wormyrocks/d-lev-mini/release/burnlist.md

# board burn list

# general to do's

## release script
- [x] round tracks
- [x] teardrops
- [ ] gerbolyzation
- [ ] panelization
- [ ] use commit hash in folder name

# all boards
- [x] de-round round tracks
- [ ] design rule audit 
- [ ] thank you notes

# mainboard
- [x] place refdes'

# i/o board 
- [ ] gerbolyze marla sketch

# tuner
- [ ] gerbolyze front panel design

# afe
- [ ] gerbolyze sketch

# wontfix
- [ ] silk icons for top 10 line items
- [ ] use absolute paths in d-lev-main in order for blender export to work properly
