wormyrocks/d-lev-mini/d-lev-main/Notes_Questions.md

* Anything special about the LP2950 or should any reasonable 3.3v regulator work here?
