wormyrocks/d-lev-mini/d-lev-libraries/refdes/font.md

# reference designator font

exporting with [pixel font converter](https://yellowafterlife.itch.io/pixelfont)
21 characters at 75x110
0 1 2 3 4 5 6 7 8 9 R C L U Q J X P - < >
min/max pressure values: 4/7
export at 1.2mm tall
