wormyrocks/d-lev-mini/d-lev-main/datasheet/EP4CE15 and E22 in QFP144 pinout.xls

Cyclone® IV EP4CE15 Device Version 1.3 Notes (1), (2), (3) |  |  |  |  |  | Cyclone® IV EP4CE22 Device Version 1.2 Notes (1), (2), (3) |  |  |  |  |  |  | +3.3V | I/O | Reserved (config, etc)
 |  |  |  |  |  |  |  |  |  |  |  |  | Com | Com
 |  |  |  |  |  |  |  |  |  |  |  |  | +1.2V | Vccint Vccd_pll
Bank | VREFB Group | Optional Function(s) | Configuration Function | PinName/ Function | E144 (4) | Bank Number | VREFB Group | Optional Function(s) | Configuration Function | Pin Name / Function | E144 (4) | Function | +2.5V | Vcca
 |  |  |  | VCCD_PLL3 | 1 |  |  |  |  | VCCD_PLL3 | 1
 |  |  |  | GNDA3 | 2 |  |  |  |  | GNDA3 | 2
 |  |  |  | VCCA3 | 3 |  |  |  |  | VCCA3 | 3
 |  |  |  | GND | 4 |  |  |  |  | GND | 4
 |  |  |  | VCCINT | 5 |  |  |  |  | VCCINT | 5
B1 | VREFB1N0 | DIFFIO_L4n | DATA1,ASDO | IO | 6 | B1 | VREFB1N0 | DIFFIO_L3n | DATA1,ASDO | IO | 6
B1 | VREFB1N0 | VREFB1N0 |  | IO | 7 | B1 | VREFB1N0 | VREFB1N0 |  | IO | 7
B1 | VREFB1N0 | DIFFIO_L6p | FLASH_nCE,nCSO | IO | 8 | B1 | VREFB1N0 | DIFFIO_L4p | FLASH_nCE,nCSO | IO | 8
B1 | VREFB1N1 |  | nSTATUS | nSTATUS | 9 | B1 | VREFB1N0 |  | nSTATUS | nSTATUS | 9
B1 | VREFB1N1 |  |  | IO | 10 | B1 | VREFB1N0 | DIFFIO_L6p |  | IO | 10
B1 | VREFB1N1 | VREFB1N1 |  | IO | 11 | B1 | VREFB1N0 | DIFFIO_L6n |  | IO | 11
B1 | VREFB1N1 |  | DCLK | DCLK | 12 | B1 | VREFB1N0 |  | DCLK | DCLK | 12
B1 | VREFB1N1 |  | DATA0 | IO | 13 | B1 | VREFB1N0 |  | DATA0 | IO | 13
B1 | VREFB1N1 |  | nCONFIG | nCONFIG | 14 | B1 | VREFB1N0 |  | nCONFIG | nCONFIG | 14
B1 | VREFB1N1 |  | TDI | TDI | 15 | B1 | VREFB1N0 |  | TDI | TDI | 15
B1 | VREFB1N1 |  | TCK | TCK | 16 | B1 | VREFB1N0 |  | TCK | TCK | 16
 |  |  |  | VCCIO1 | 17 |  |  |  |  | VCCIO1 | 17
B1 | VREFB1N1 |  | TMS | TMS | 18 | B1 | VREFB1N0 |  | TMS | TMS | 18
 |  |  |  | GND | 19 |  |  |  |  | GND | 19
B1 | VREFB1N1 |  | TDO | TDO | 20 | B1 | VREFB1N0 |  | TDO | TDO | 20
B1 | VREFB1N1 |  | nCE | nCE | 21 | B1 | VREFB1N0 |  | nCE | nCE | 21
 |  |  |  | GND | 22 |  |  |  |  | GND | 22
B1 | VREFB1N1 | DIFFCLK_0n |  | CLK1 | 23 | B1 | VREFB1N0 | DIFFCLK_0n |  | CLK1 | 23 | Clock
B2 | VREFB2N0 | DIFFCLK_1p |  | CLK2 | 24 | B2 | VREFB2N0 | DIFFCLK_1p |  | CLK2 | 24 | Master In
B2 | VREFB2N0 | DIFFCLK_1n |  | CLK3 | 25 | B2 | VREFB2N0 | DIFFCLK_1n |  | CLK3 | 25
 |  |  |  | VCCIO2 | 26 |  |  |  |  | VCCIO2 | 26
 |  |  |  | GND | 27 |  |  |  |  | GND | 27
B2 | VREFB2N0 | VREFB2N0 |  | IO | 28 | B2 | VREFB2N0 | DIFFIO_L8p |  | IO | 28
 |  |  |  | VCCINT | 29 |  |  |  |  | VCCINT | 29
B2 | VREFB2N0 | DIFFIO_L19p |  | IO | 30 | B2 | VREFB2N0 | DIFFIO_L11p |  | IO | 30 | Dig In
B2 | VREFB2N1 | VREFB2N1 |  | IO | 31 | B2 | VREFB2N0 | VREFB2N0 |  | IO | 31
B2 | VREFB2N1 | RUP1 |  | IO | 32 | B2 | VREFB2N0 | RUP1 |  | IO | 32
B2 | VREFB2N1 | RDN1 |  | IO | 33 | B2 | VREFB2N0 | RDN1 |  | IO | 33
 |  |  |  | VCCINT | 34 |  |  |  |  | VCCINT | 34
 |  |  |  | VCCA1 | 35 |  |  |  |  | VCCA1 | 35
 |  |  |  | GNDA1 | 36 |  |  |  |  | GNDA1 | 36
 |  |  |  | VCCD_PLL1 | 37 |  |  |  |  | VCCD_PLL1 | 37
 |  |  |  | VCCINT | 38 |  |  |  |  | VCCINT | 38
B3 | VREFB3N1 | VREFB3N1 |  | IO | 39 | B3 | VREFB3N0 | DIFFIO_B2p |  | IO | 39 | Dig In
 |  |  |  | VCCIO3 | 40 |  |  |  |  | VCCIO3 | 40
 |  |  |  | GND | 41 |  |  |  |  | GND | 41
B3 | VREFB3N1 |  |  | IO | 42 | B3 | VREFB3N0 |  |  | IO | 42 | Dig In
B3 | VREFB3N1 | PLL1_CLKOUTp |  | IO | 43 | B3 | VREFB3N0 | PLL1_CLKOUTp |  | IO | 43
B3 | VREFB3N1 | PLL1_CLKOUTn |  | IO | 44 | B3 | VREFB3N0 | PLL1_CLKOUTn |  | IO | 44
 |  |  |  | VCCINT | 45 |  |  |  |  | VCCINT | 45
B3 | VREFB3N0 | VREFB3N0 |  | IO | 46 | B3 | VREFB3N0 | VREFB3N0 |  | IO | 46
 |  |  |  | VCCIO3 | 47 |  |  |  |  | VCCIO3 | 47
 |  |  |  | GND | 48 |  |  |  |  | GND | 48
B3 | VREFB3N0 |  |  | IO | 49 | B3 | VREFB3N0 | DIFFIO_B9n |  | IO | 49
B3 | VREFB3N0 | DIFFIO_B18p |  | IO | 50 | B3 | VREFB3N0 | DIFFIO_B10n |  | IO | 50
B3 | VREFB3N0 | DIFFIO_B18n |  | IO | 51 | B3 | VREFB3N0 | DIFFIO_B11p |  | IO | 51
B3 | VREFB3N0 | DIFFCLK_6p |  | CLK15 | 52 | B3 | VREFB3N0 | DIFFCLK_6p |  | CLK15 | 52
B3 | VREFB3N0 | DIFFCLK_6n |  | CLK14 | 53 | B3 | VREFB3N0 | DIFFCLK_6n |  | CLK14 | 53 | AC Line
B4 | VREFB4N1 | DIFFCLK_7p |  | CLK13 | 54 | B4 | VREFB4N0 | DIFFCLK_7p |  | CLK13 | 54 | Extend In
B4 | VREFB4N1 | DIFFCLK_7n |  | CLK12 | 55 | B4 | VREFB4N0 | DIFFCLK_7n |  | CLK12 | 55
 |  |  |  | VCCIO4 | 56 |  |  |  |  | VCCIO4 | 56
 |  |  |  | GND | 57 |  |  |  |  | GND | 57
B4 | VREFB4N1 | DIFFIO_B21p |  | IO | 58 | B4 | VREFB4N0 | DIFFIO_B16p |  | IO | 58 | Extend Out
B4 | VREFB4N1 | DIFFIO_B22p |  | IO | 59 | B4 | VREFB4N0 | DIFFIO_B17p |  | IO | 59
B4 | VREFB4N1 | DIFFIO_B22n |  | IO | 60 | B4 | VREFB4N0 | DIFFIO_B17n |  | IO | 60
B4 | VREFB4N1 | DIFFIO_B23p |  | IO | 61 |  |  |  |  | VCCINT | 61
 |  |  |  | VCCIO4 | 62 |  |  |  |  | VCCIO4 | 62
 |  |  |  | GND | 63 |  |  |  |  | GND | 63
B4 | VREFB4N1 |  |  | IO | 64 | B4 | VREFB4N0 |  |  | IO | 64 | DAC Ctrl
B4 | VREFB4N1 | VREFB4N1 |  | IO | 65 | B4 | VREFB4N0 | VREFB4N0 |  | IO | 65
B4 | VREFB4N0 | RUP2 |  | IO | 66 | B4 | VREFB4N0 | RUP2 |  | IO | 66
B4 | VREFB4N0 | RDN2 |  | IO | 67 | B4 | VREFB4N0 | RDN2 |  | IO | 67
B4 | VREFB4N0 | DIFFIO_B29n |  | IO | 68 | B4 | VREFB4N0 | DIFFIO_B23n |  | IO | 68
B4 | VREFB4N0 | VREFB4N0 |  | IO | 69 | B4 | VREFB4N0 | DIFFIO_B24p |  | IO | 69
 |  |  |  | VCCINT | 70 |  |  |  |  | VCCINT | 70
B4 | VREFB4N0 | PLL4_CLKOUTp |  | IO | 71 | B4 | VREFB4N0 | PLL4_CLKOUTp |  | IO | 71 | DAC
B4 | VREFB4N0 | PLL4_CLKOUTn |  | IO | 72 | B4 | VREFB4N0 | PLL4_CLKOUTn |  | IO | 72
 |  |  |  | VCCD_PLL4 | 73 |  |  |  |  | VCCD_PLL4 | 73
 |  |  |  | GNDA4 | 74 |  |  |  |  | GNDA4 | 74
 |  |  |  | VCCA4 | 75 |  |  |  |  | VCCA4 | 75
B5 | VREFB5N1 | RUP3 |  | IO | 76 | B5 | VREFB5N0 | RUP3 |  | IO | 76
B5 | VREFB5N1 | RDN3 |  | IO | 77 | B5 | VREFB5N0 | RDN3 |  | IO | 77
 |  |  |  | VCCINT | 78 |  |  |  |  | VCCINT | 78
 |  |  |  | GND | 79 |  |  |  |  | GND | 79
B5 | VREFB5N1 | VREFB5N1 |  | IO | 80 | B5 | VREFB5N0 | VREFB5N0 |  | IO | 80
 |  |  |  | VCCIO5 | 81 |  |  |  |  | VCCIO5 | 81
 |  |  |  | GND | 82 |  |  |  |  | GND | 82
B5 | VREFB5N0 | VREFB5N0 |  | IO | 83 | B5 | VREFB5N0 | DIFFIO_R11p |  | IO | 83 | ADC
 |  |  |  | VCCINT | 84 |  |  |  |  | VCCINT | 84
B5 | VREFB5N0 | DIFFIO_R22p |  | IO | 85 | B5 | VREFB5N0 | DIFFIO_R10p |  | IO | 85 | ADC
B5 | VREFB5N0 | DIFFIO_R21n | DEV_OE | IO | 86 | B5 | VREFB5N0 | DIFFIO_R9n | DEV_OE | IO | 86
B5 | VREFB5N0 | DIFFIO_R21p | DEV_CLRn | IO | 87 | B5 | VREFB5N0 | DIFFIO_R9p | DEV_CLRn | IO | 87
B5 | VREFB5N0 | DIFFCLK_3n |  | CLK7 | 88 | B5 | VREFB5N0 | DIFFCLK_3n |  | CLK7 | 88
B5 | VREFB5N0 | DIFFCLK_3p |  | CLK6 | 89 | B5 | VREFB5N0 | DIFFCLK_3p |  | CLK6 | 89
B6 | VREFB6N1 | DIFFCLK_2n |  | CLK5 | 90 | B6 | VREFB6N0 | DIFFCLK_2n |  | CLK5 | 90
B6 | VREFB6N1 | DIFFCLK_2p |  | CLK4 | 91 | B6 | VREFB6N0 | DIFFCLK_2p |  | CLK4 | 91
B6 | VREFB6N1 |  | CONF_DONE | CONF_DONE | 92 | B6 | VREFB6N0 |  | CONF_DONE | CONF_DONE | 92
 |  |  |  | VCCIO6 | 93 |  |  |  |  | VCCIO6 | 93
B6 | VREFB6N1 |  | MSEL0 | MSEL0 | 94 | B6 | VREFB6N0 |  | MSEL0 | MSEL0 | 94 |  | GND | AS +3.3V
 |  |  |  | GND | 95 |  |  |  |  | GND | 95
B6 | VREFB6N1 |  | MSEL1 | MSEL1 | 96 | B6 | VREFB6N0 |  | MSEL1 | MSEL1 | 96 |  | Vcca
B6 | VREFB6N1 |  | MSEL2 | MSEL2 | 97 | B6 | VREFB6N0 |  | MSEL2 | MSEL2 | 97 |  | GND
B6 | VREFB6N1 | DIFFIO_R17n | INIT_DONE | IO | 98 | B6 | VREFB6N0 | DIFFIO_R5n | INIT_DONE | IO | 98 | DAC
B6 | VREFB6N1 | DIFFIO_R17p | CRC_ERROR | IO | 99 | B6 | VREFB6N0 | DIFFIO_R5p | CRC_ERROR | IO | 99
B6 | VREFB6N1 | VREFB6N1 |  | IO | 100 | B6 | VREFB6N0 |  |  | IO | 100
B6 | VREFB6N1 | DIFFIO_R16n | nCEO | IO | 101 | B6 | VREFB6N0 | DIFFIO_R4n | nCEO | IO | 101
 |  |  |  | VCCINT | 102 |  |  |  |  | VCCINT | 102
B6 | VREFB6N1 | DIFFIO_R16p | CLKUSR | IO | 103 | B6 | VREFB6N0 | DIFFIO_R4p | CLKUSR | IO | 103 | DAC
B6 | VREFB6N1 | DIFFIO_R15n |  | IO | 104 | B6 | VREFB6N0 |  |  | IO | 104
B6 | VREFB6N0 | VREFB6N0 |  | IO | 105 | B6 | VREFB6N0 | VREFB6N0 |  | IO | 105
B6 | VREFB6N0 | DIFFIO_R2n | PADD20 | IO | 106 | B6 | VREFB6N0 | DIFFIO_R1n | PADD20 | IO | 106
 |  |  |  | VCCA2 | 107 |  |  |  |  | VCCA2 | 107
 |  |  |  | GNDA2 | 108 |  |  |  |  | GNDA2 | 108
 |  |  |  | VCCD_PLL2 | 109 |  |  |  |  | VCCD_PLL2 | 109
B7 | VREFB7N0 | DIFFIO_T30p |  | IO | 110 | B7 | VREFB7N0 | DIFFIO_T23p |  | IO | 110 | DAC
B7 | VREFB7N0 | VREFB7N0 |  | IO | 111 | B7 | VREFB7N0 | DIFFIO_T22p |  | IO | 111
B7 | VREFB7N0 | PLL2_CLKOUTn |  | IO | 112 | B7 | VREFB7N0 | PLL2_CLKOUTn |  | IO | 112
B7 | VREFB7N0 | PLL2_CLKOUTp |  | IO | 113 | B7 | VREFB7N0 | PLL2_CLKOUTp |  | IO | 113
B7 | VREFB7N0 | RUP4 |  | IO | 114 | B7 | VREFB7N0 | RUP4 |  | IO | 114
B7 | VREFB7N0 | RDN4 |  | IO | 115 | B7 | VREFB7N0 | RDN4 |  | IO | 115
 |  |  |  | VCCINT | 116 |  |  |  |  | VCCINT | 116
 |  |  |  | VCCIO7 | 117 |  |  |  |  | VCCIO7 | 117
 |  |  |  | GND | 118 |  |  |  |  | GND | 118
B7 | VREFB7N1 | VREFB7N1 |  | IO | 119 | B7 | VREFB7N0 | VREFB7N0 |  | IO | 119
B7 | VREFB7N1 | DIFFIO_T23n | PADD3 | IO | 120 | B7 | VREFB7N0 | DIFFIO_T19n | PADD1 | IO | 120 | Phi Pot
B7 | VREFB7N1 | DIFFIO_T21p | PADD4 | IO | 121 | B7 | VREFB7N0 | DIFFIO_T17p | PADD4 | IO | 121 | Phi Pot
 |  |  |  | VCCIO7 | 122 |  |  |  |  | VCCIO7 | 122
 |  |  |  | GND | 123 |  |  |  |  | GND | 123
 |  |  |  | VCCINT | 124 |  |  |  |  | VCCINT | 124
B7 | VREFB7N1 | DIFFIO_T17p | PADD12 | IO | 125 | B7 | VREFB7N0 | DIFFIO_T13p | PADD12 | IO | 125
B7 | VREFB7N1 | DIFFCLK_5n |  | CLK8 | 126 | B7 | VREFB7N0 | DIFFCLK_5n |  | CLK8 | 126 | Phi Pot
B7 | VREFB7N1 | DIFFCLK_5p |  | CLK9 | 127 | B7 | VREFB7N0 | DIFFCLK_5p |  | CLK9 | 127
B8 | VREFB8N0 | DIFFCLK_4n |  | CLK10 | 128 | B8 | VREFB8N0 | DIFFCLK_4n |  | CLK10 | 128
B8 | VREFB8N0 | DIFFCLK_4p |  | CLK11 | 129 | B8 | VREFB8N0 | DIFFCLK_4p |  | CLK11 | 129
 |  |  |  | VCCIO8 | 130 |  |  |  |  | VCCIO8 | 130
 |  |  |  | GND | 131 |  |  |  |  | GND | 131
B8 | VREFB8N0 | DIFFIO_T12n | DATA2 | IO | 132 | B8 | VREFB8N0 | DIFFIO_T10n | DATA2 | IO | 132 | Dat Out
B8 | VREFB8N0 | DIFFIO_T12p | DATA3 | IO | 133 | B8 | VREFB8N0 | DIFFIO_T10p | DATA3 | IO | 133
B8 | VREFB8N0 | DIFFIO_T11n | PADD18 | IO | 134 |  |  |  |  | VCCINT | 134
B8 | VREFB8N0 | DIFFIO_T11p | DATA4 | IO | 135 | B8 | VREFB8N0 | DIFFIO_T9p | DATA4 | IO | 135 | Dat Out
B8 | VREFB8N0 | VREFB8N0 |  | IO | 136 | B8 | VREFB8N0 | VREFB8N0 |  | IO | 136
B8 | VREFB8N0 |  | DATA5 | IO | 137 | B8 | VREFB8N0 |  | DATA5 | IO | 137
 |  |  |  | VCCINT | 138 |  |  |  |  | VCCINT | 138
 |  |  |  | VCCIO8 | 139 |  |  |  |  | VCCIO8 | 139
 |  |  |  | GND | 140 |  |  |  |  | GND | 140
B8 | VREFB8N1 | VREFB8N1 |  | IO | 141 | B8 | VREFB8N0 | DIFFIO_T2p |  | IO | 141 | Dat out
B8 | VREFB8N1 | DIFFIO_T2p | DATA12 | IO | 142 | B8 | VREFB8N0 |  | DATA12 | IO | 142
B8 | VREFB8N1 | PLL3_CLKOUTn |  | IO | 143 | B8 | VREFB8N0 | PLL3_CLKOUTn |  | IO | 143 | PRBS Out
B8 | VREFB8N1 | PLL3_CLKOUTp |  | IO | 144 | B8 | VREFB8N0 | PLL3_CLKOUTp |  | IO | 144 | LED
Notes:
(1) If the p pin or n pin is not available for the package, the particular differential pair is not supported. |  |  |  |  |  | Notes:
(2) For DQS pins that do not have the associated DQpins, the particular DQS is not supported. |  |  |  |  |  | (1) If the p pin or n pin is not available for the package, the particular differential pair is not supported.
(3) For more information about pin definition and pin connection guidelines, refer to the |  |  |  |  |  | (2) For DQS pins that do not have the associated DQ pins, the particular DQS is not supported.
Cyclone IV Device Family Pin Connection Guidelines. (http://www.altera.com/literature/dp/cyclone-iv/PCG-01008.pdf) |  |  |  |  |  | (3) For more information about pin definition and pin connection guidelines, refer to the
(4) The E144 package has an exposed pad at the bottom of the package. This exposed pad is a ground pad that must be connected to the ground plane on your PCB. |  |  |  |  |  | Cyclone IV Device Family Pin Connection Guidelines. (http://www.altera.com/literature/dp/cyclone-iv/PCG-01008.pdf)
This exposed pad is used for electrical connectivity, and not for thermal purposes. |  |  |  |  |  | (4) The E144 package has an exposed pad at the bottom of the package. This exposed pad is a ground pad that must be connected to the ground plane on your PCB.
 |  |  |  |  |  | This exposed pad is used for electrical connectivity, and not for thermal purposes.
