wormyrocks/d-lev-mini/d-lev-afe/2019-03-09_AFE3_layout.jpg

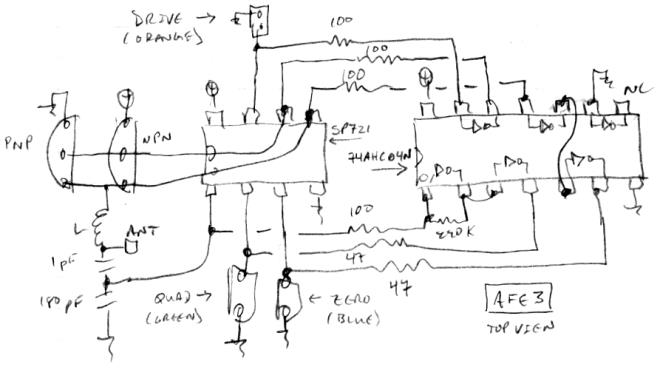
d-lev-afe/2019-03-09_AFE3_layout.jpg
