wormyrocks/d-lev-mini/d-lev-libraries/refdes/text.png

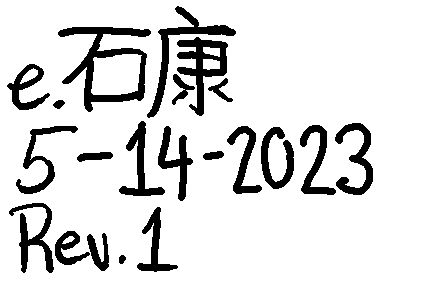
d-lev-libraries/refdes/text.png
