wormyrocks/d-lev-mini/d-lev-main/datasheet/Big_Inductor.png

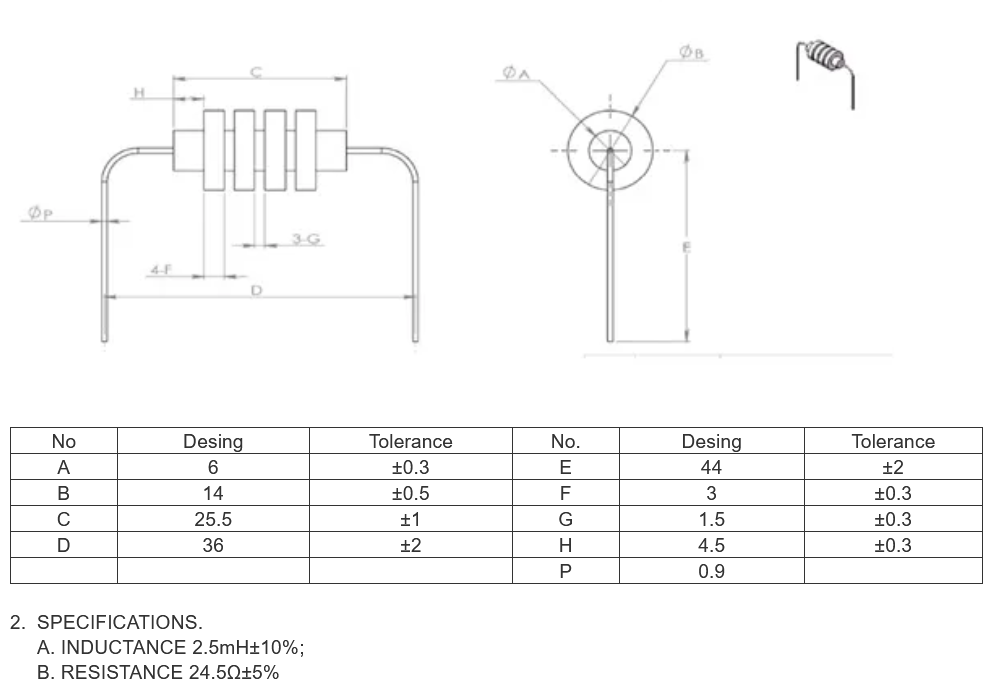
d-lev-main/datasheet/Big_Inductor.png
