wormyrocks/d-lev-mini/d-lev-main/ac608-pinmap.xlsx

Sheet: EP4CE10 Mapping
Pin Information for the Cyclone® IV EP4CE10 Device Version 1.2 Notes (1), (2), (3)
Bank Number |  |  | VREFB Group |  | Pin Name / Function |  |  | Optional Function(s) |  | Configuration Function | F256/ U256 |  | E144 (4) | DQS for X8/X9 in F256/U256 | DQS for X16/X18 in F256/U256 |  |  | DQS for X8/X9 in E144
B1 |  |  | VREFB1N0 |  | IO |  |  |  |  |  | D4 |  | 1
B1 |  |  | VREFB1N0 |  | IO |  |  |  |  |  | E5 |  | 2
B1 |  |  | VREFB1N0 |  | IO |  |  |  |  |  | F5 |  | 3
B1 |  |  | VREFB1N0 |  | IO |  |  |  |  |  | B1 |  |  | DQS2L/CQ3L | DQS2L/CQ3L |  |  | DQS2L/CQ3L
B1 |  |  | VREFB1N0 |  | IO |  |  | DIFFIO_L1p |  |  | C2
B1 |  |  | VREFB1N0 |  | IO |  |  | DIFFIO_L1n |  | DATA1,ASDO | C1 |  | 6
B1 |  |  | VREFB1N0 |  | IO |  |  | VREFB1N0 |  |  | F3 |  | 7
B1 |  |  | VREFB1N0 |  | IO |  |  | DIFFIO_L2p |  | FLASH_nCE,nCSO | D2 |  | 8
B1 |  |  | VREFB1N0 |  | IO |  |  | DIFFIO_L2n |  |  | D1
B1 |  |  | VREFB1N0 |  | nSTATUS |  |  |  |  | nSTATUS | F4 |  | 9
B1 |  |  | VREFB1N0 |  | IO |  |  |  |  |  | G5
B1 |  |  | VREFB1N0 |  | IO |  |  | DIFFIO_L3p |  |  | F2
B1 |  |  | VREFB1N0 |  | IO |  |  | DIFFIO_L3n |  |  | F1
B1 |  |  | VREFB1N0 |  | IO |  |  | DIFFIO_L4p |  |  | G2 |  | 10 | DQS0L/CQ1L,DPCLK0 | DQS0L/CQ1L,DPCLK0 |  |  | DQS0L/CQ1L,DPCLK0
B1 |  |  | VREFB1N0 |  | IO |  |  | DIFFIO_L4n |  |  | G1 |  | 11
B1 |  |  | VREFB1N0 |  | DCLK |  |  |  |  | DCLK | H1 |  | 12
B1 |  |  | VREFB1N0 |  | IO |  |  |  |  | DATA0 | H2 |  | 13
B1 |  |  | VREFB1N0 |  | nCONFIG |  |  |  |  | nCONFIG | H5 |  | 14
B1 |  |  | VREFB1N0 |  | TDI |  |  |  |  | TDI | H4 |  | 15
B1 |  |  | VREFB1N0 |  | TCK |  |  |  |  | TCK | H3 |  | 16
B1 |  |  | VREFB1N0 |  | TMS |  |  |  |  | TMS | J5 |  | 18
B1 |  |  | VREFB1N0 |  | TDO |  |  |  |  | TDO | J4 |  | 20
B1 |  |  | VREFB1N0 |  | nCE |  |  |  |  | nCE | J3 |  | 21
B1 |  |  | VREFB1N0 |  | CLK1 |  |  | DIFFCLK_0n |  |  | E1 |  | 23
B2 |  |  | VREFB2N0 |  | CLK2 |  |  | DIFFCLK_1p |  |  | M2 |  | 24
B2 |  |  | VREFB2N0 |  | CLK3 |  |  | DIFFCLK_1n |  |  | M1 |  | 25
B2 |  |  | VREFB2N0 |  | IO |  |  | DIFFIO_L5p |  |  | J2 |  |  | DQ1L
B2 |  |  | VREFB2N0 |  | IO |  |  | DIFFIO_L5n |  |  | J1 |  |  | DQ1L
B2 |  |  | VREFB2N0 |  | IO |  |  |  |  |  | J6
B2 |  |  | VREFB2N0 |  | IO |  |  | DIFFIO_L6p |  |  | K6
B2 |  |  | VREFB2N0 |  | IO |  |  | DIFFIO_L6n |  |  | L6 |  | 28
B2 |  |  | VREFB2N0 |  | IO |  |  | DIFFIO_L7p |  |  | K2
B2 |  |  | VREFB2N0 |  | IO |  |  | DIFFIO_L7n |  |  | K1 |  |  | DQ1L
B2 |  |  | VREFB2N0 |  | IO |  |  | DIFFIO_L8p |  |  | L2 |  | 30 | DQS1L/CQ1L#,DPCLK1 | DQS1L/CQ1L#,DPCLK1 |  |  | DQS1L/CQ1L#,DPCLK1
B2 |  |  | VREFB2N0 |  | IO |  |  | DIFFIO_L8n |  |  | L1 |  |  | DQ1L
B2 |  |  | VREFB2N0 |  | IO |  |  | VREFB2N0 |  |  | L3 |  | 31
B2 |  |  | VREFB2N0 |  | IO |  |  | DIFFIO_L9p |  |  | N2 |  |  | DQ1L
B2 |  |  | VREFB2N0 |  | IO |  |  | DIFFIO_L9n |  |  | N1 |  |  | DQ1L
B2 |  |  | VREFB2N0 |  | IO |  |  | RUP1 |  |  | K5 |  | 32 | DQ1L
B2 |  |  | VREFB2N0 |  | IO |  |  | RDN1 |  |  | L4 |  | 33 | DQ1L
B2 |  |  | VREFB2N0 |  | IO |  |  |  |  |  |  |  | 34
B2 |  |  | VREFB2N0 |  | IO |  |  |  |  |  | R1 |  |  | DQS3L/CQ3L# | DQS3L/CQ3L# |  |  | DQS3L/CQ3L#
B2 |  |  | VREFB2N0 |  | IO |  |  | DIFFIO_L10p |  |  | P2 |  |  | DQ1L
B2 |  |  | VREFB2N0 |  | IO |  |  | DIFFIO_L10n |  |  | P1 |  |  | DM1L/BWS#1L
B3 |  |  | VREFB3N0 |  | IO |  |  | DIFFIO_B1p |  |  | N3 |  | 38
B3 |  |  | VREFB3N0 |  | IO |  |  | DIFFIO_B1n |  |  | P3 |  | 39 | DM3B/BWS#3B | DM5B/BWS#5B
Pin Information for the Cyclone® IV EP4CE10 Device Version 1.2 Notes (1), (2), (3)
Bank Number |  |  | VREFB Group |  | Pin Name / Function |  |  | Optional Function(s) |  | Configuration Function | F256/ U256 |  | E144 (4) | DQS for X8/X9 in F256/U256 | DQS for X16/X18 in F256/U256 |  |  | DQS for X8/X9 in E144
B3 |  |  | VREFB3N0 |  | IO |  |  | DIFFIO_B2p |  |  | R3 |  |  | DQ3B | DQ5B
B3 |  |  | VREFB3N0 |  | IO |  |  | DIFFIO_B2n |  |  | T3
B3 |  |  | VREFB3N0 |  | IO |  |  |  |  |  | T2 |  | 42 | DQS1B/CQ1B#,DPCLK2 | DQS1B/CQ1B#,DPCLK2 |  |  | DQS1B/CQ1B#,DPCLK2
B3 |  |  | VREFB3N0 |  | IO |  |  | PLL1_CLKOUTp |  |  | R4 |  | 43
B3 |  |  | VREFB3N0 |  | IO |  |  | PLL1_CLKOUTn |  |  | T4 |  | 44
B3 |  |  | VREFB3N0 |  | IO |  |  | DIFFIO_B4p |  |  | N5 |  |  | DQ3B | DQ5B
B3 |  |  | VREFB3N0 |  | IO |  |  | DIFFIO_B4n |  |  | N6 |  |  | DQ3B | DQ5B
B3 |  |  | VREFB3N0 |  | IO |  |  |  |  |  | M6 |  |  | DQ3B | DQ5B
B3 |  |  | VREFB3N0 |  | IO |  |  | VREFB3N0 |  |  | P6 |  | 46
B3 |  |  | VREFB3N0 |  | IO |  |  | DIFFIO_B5p |  |  | M7 |  |  | DQS3B/CQ3B# | DQS3B/CQ3B# |  |  | DQS3B/CQ3B#
B3 |  |  | VREFB3N0 |  | IO |  |  | DIFFIO_B5n |  |  | K8
B3 |  |  | VREFB3N0 |  | IO |  |  | DIFFIO_B6p |  |  | R5 |  |  | DQ3B | DQ5B
B3 |  |  | VREFB3N0 |  | IO |  |  | DIFFIO_B6n |  |  | T5
B3 |  |  | VREFB3N0 |  | IO |  |  | DIFFIO_B7p |  |  | R6 |  |  | DQ3B | DQ5B
B3 |  |  | VREFB3N0 |  | IO |  |  | DIFFIO_B7n |  |  | T6
B3 |  |  | VREFB3N0 |  | IO |  |  |  |  |  | L7 |  |  | DQ3B | DQ5B
B3 |  |  | VREFB3N0 |  | IO |  |  | DIFFIO_B8p |  |  | R7 |  |  | DQ3B | DQ5B
B3 |  |  | VREFB3N0 |  | IO |  |  | DIFFIO_B8n |  |  | T7 |  |  | DQS5B/CQ5B# | DQS5B/CQ5B# |  |  | DQS5B/CQ5B#
B3 |  |  | VREFB3N0 |  | IO |  |  | DIFFIO_B9p |  |  | L8 |  | 49 | DQ3B | DQ5B |  |  | DQ1B
B3 |  |  | VREFB3N0 |  | IO |  |  | DIFFIO_B9n |  |  | M8 |  | 50 | DM5B/BWS#5B | DM5B/BWS#5B |  |  | DQ1B
B3 |  |  | VREFB3N0 |  | IO |  |  | DIFFIO_B10p |  |  | N8 |  | 51 | DQ5B | DQ5B |  |  | DQ1B
B3 |  |  | VREFB3N0 |  | IO |  |  | DIFFIO_B10n |  |  | P8 |  |  | DQ5B | DQ5B
B3 |  |  | VREFB3N0 |  | IO |  |  | DIFFIO_B11p |  |  | R8 |  | 52
B3 |  |  | VREFB3N0 |  | IO |  |  | DIFFIO_B11n |  |  | T8 |  | 53
B4 |  |  | VREFB4N0 |  | IO |  |  | DIFFIO_B12p |  |  | R9 |  | 54
B4 |  |  | VREFB4N0 |  | IO |  |  | DIFFIO_B12n |  |  | T9 |  | 55
B4 |  |  | VREFB4N0 |  | IO |  |  | DIFFIO_B13p |  |  | K9
B4 |  |  | VREFB4N0 |  | IO |  |  | DIFFIO_B13n |  |  | L9
B4 |  |  | VREFB4N0 |  | IO |  |  | DIFFIO_B14p |  |  | M9
B4 |  |  | VREFB4N0 |  | IO |  |  | DIFFIO_B14n |  |  | N9 |  |  | DQ5B | DQ5B
B4 |  |  | VREFB4N0 |  | IO |  |  | DIFFIO_B15p |  |  | R10 |  | 58 | DQ5B | DQ5B |  |  | DQ1B
B4 |  |  | VREFB4N0 |  | IO |  |  | DIFFIO_B15n |  |  | T10 |  |  | DQS4B/CQ5B | DQS4B/CQ5B |  |  | DQS4B/CQ5B
B4 |  |  | VREFB4N0 |  | IO |  |  | DIFFIO_B16p |  |  | R11 |  | 59 | DQ5B | DQ5B |  |  | DQ1B
B4 |  |  | VREFB4N0 |  | IO |  |  | DIFFIO_B16n |  |  | T11 |  | 60 |  |  |  |  | DQ1B
B4 |  |  | VREFB4N0 |  | IO |  |  | DIFFIO_B17p |  |  | R12 |  |  | DQ5B | DQ5B
B4 |  |  | VREFB4N0 |  | IO |  |  | DIFFIO_B17n |  |  | T12 |  |  | DQ5B | DQ5B
B4 |  |  | VREFB4N0 |  | IO |  |  | DIFFIO_B18p |  |  | K10
B4 |  |  | VREFB4N0 |  | IO |  |  | DIFFIO_B18n |  |  | L10
B4 |  |  | VREFB4N0 |  | IO |  |  |  |  |  | P9 |  | 64 | DQS2B/CQ3B | DQS2B/CQ3B
B4 |  |  | VREFB4N0 |  | IO |  |  | VREFB4N0 |  |  | P11 |  | 65
B4 |  |  | VREFB4N0 |  | IO |  |  | DIFFIO_B19p |  |  | R13
B4 |  |  | VREFB4N0 |  | IO |  |  | DIFFIO_B19n |  |  | T13 |  |  | DQ5B | DQ5B
B4 |  |  | VREFB4N0 |  | IO |  |  | RUP2 |  |  | M10 |  | 66 |  |  |  |  | DQ1B
B4 |  |  | VREFB4N0 |  | IO |  |  | RDN2 |  |  | N11 |  | 67 |  |  |  |  | DQ1B
B4 |  |  | VREFB4N0 |  | IO |  |  | DIFFIO_B20p |  |  | T14 |  |  | DQ5B | DQ5B
B4 |  |  | VREFB4N0 |  | IO |  |  | DIFFIO_B20n |  |  | T15 |  | 68 | DQS0B/CQ1B,DPCLK3 | DQS0B/CQ1B,DPCLK3 |  |  | DQS0B/CQ1B,DPCLK3
Pin Information for the Cyclone® IV EP4CE10 Device Version 1.2 Notes (1), (2), (3)
Bank Number |  |  | VREFB Group |  | Pin Name / Function |  |  | Optional Function(s) |  | Configuration Function | F256/ U256 |  | E144 (4) | DQS for X8/X9 in F256/U256 | DQS for X16/X18 in F256/U256 |  |  | DQS for X8/X9 in E144
B4 |  |  | VREFB4N0 |  | IO |  |  |  |  |  | R14 |  | 69
B4 |  |  | VREFB4N0 |  | IO |  |  | DIFFIO_B21p |  |  | P14 |  | 70
B4 |  |  | VREFB4N0 |  | IO |  |  | DIFFIO_B21n |  |  | L11 |  | 71
B4 |  |  | VREFB4N0 |  | IO |  |  | DIFFIO_B22p |  |  | M11 |  | 72
B4 |  |  | VREFB4N0 |  | IO |  |  | DIFFIO_B22n |  |  | N12
B5 |  |  | VREFB5N0 |  | IO |  |  |  |  |  | N13 |  | 73
B5 |  |  | VREFB5N0 |  | IO |  |  |  |  |  | M12 |  | 74
B5 |  |  | VREFB5N0 |  | IO |  |  |  |  |  | L12 |  | 75
B5 |  |  | VREFB5N0 |  | IO |  |  |  |  |  | K12
B5 |  |  | VREFB5N0 |  | IO |  |  | RUP3 |  |  | N14 |  | 76 | DM1R/BWS#1R
B5 |  |  | VREFB5N0 |  | IO |  |  | RDN3 |  |  | P15 |  | 77 | DQ1R
B5 |  |  | VREFB5N0 |  | IO |  |  | DIFFIO_R11n |  |  | P16 |  |  | DQS3R/CQ3R# | DQS3R/CQ3R# |  |  | DQS3R/CQ3R#
B5 |  |  | VREFB5N0 |  | IO |  |  | DIFFIO_R11p |  |  | R16 |  |  | DQ1R
B5 |  |  | VREFB5N0 |  | IO |  |  |  |  |  | K11
B5 |  |  | VREFB5N0 |  | IO |  |  | DIFFIO_R10n |  |  | N16 |  |  | DQ1R
B5 |  |  | VREFB5N0 |  | IO |  |  | DIFFIO_R10p |  |  | N15 |  |  | DQ1R
B5 |  |  | VREFB5N0 |  | IO |  |  | VREFB5N0 |  |  | L14 |  | 80
B5 |  |  | VREFB5N0 |  | IO |  |  |  |  |  | L13 |  |  | DQ1R
B5 |  |  | VREFB5N0 |  | IO |  |  | DIFFIO_R9n |  |  | L16 |  |  | DQ1R
B5 |  |  | VREFB5N0 |  | IO |  |  | DIFFIO_R9p |  |  | L15
B5 |  |  | VREFB5N0 |  | IO |  |  |  |  |  | J11 |  | 83
B5 |  |  | VREFB5N0 |  | IO |  |  | DIFFIO_R8n |  |  | K16 |  | 84 | DQ1R
B5 |  |  | VREFB5N0 |  | IO |  |  | DIFFIO_R8p |  |  | K15 |  | 85 | DQS1R/CQ1R#,DPCLK4 | DQS1R/CQ1R#,DPCLK4 |  |  | DQS1R/CQ1R#,DPCLK4
B5 |  |  | VREFB5N0 |  | IO |  |  | DIFFIO_R7n |  | DEV_OE | J16 |  | 86
B5 |  |  | VREFB5N0 |  | IO |  |  | DIFFIO_R7p |  | DEV_CLRn | J15 |  | 87
B5 |  |  | VREFB5N0 |  | IO |  |  | DIFFIO_R6n |  |  | J14 |  |  | DQ1R
B5 |  |  | VREFB5N0 |  | IO |  |  | DIFFIO_R6p |  |  | J12
B5 |  |  | VREFB5N0 |  | IO |  |  |  |  |  | J13 |  |  | DQ1R
B5 |  |  | VREFB5N0 |  | CLK7 |  |  | DIFFCLK_3n |  |  | M16 |  | 88
B5 |  |  | VREFB5N0 |  | CLK6 |  |  | DIFFCLK_3p |  |  | M15 |  | 89
B6 |  |  | VREFB6N0 |  | CLK5 |  |  | DIFFCLK_2n |  |  | E16 |  | 90
B6 |  |  | VREFB6N0 |  | CLK4 |  |  | DIFFCLK_2p |  |  | E15 |  | 91
B6 |  |  | VREFB6N0 |  | CONF_DONE |  |  |  |  | CONF_DONE | H14 |  | 92
B6 |  |  | VREFB6N0 |  | MSEL0 |  |  |  |  | MSEL0 | H13 |  | 94
B6 |  |  | VREFB6N0 |  | MSEL1 |  |  |  |  | MSEL1 | H12 |  | 96
B6 |  |  | VREFB6N0 |  | MSEL2 |  |  |  |  | MSEL2 | G12 |  | 97
B6 |  |  | VREFB6N0 |  | IO |  |  | DIFFIO_R4n |  | INIT_DONE | G16 |  | 98
B6 |  |  | VREFB6N0 |  | IO |  |  | DIFFIO_R4p |  | CRC_ERROR | G15 |  | 99
B6 |  |  | VREFB6N0 |  | IO |  |  |  |  |  | F13 |  | 100
B6 |  |  | VREFB6N0 |  | IO |  |  | DIFFIO_R3n |  | nCEO | F16 |  | 101
B6 |  |  | VREFB6N0 |  | IO |  |  | DIFFIO_R3p |  | CLKUSR | F15 |  | 103
B6 |  |  | VREFB6N0 |  | IO |  |  |  |  |  | B16 |  | 104 | DQS0R/CQ1R,DPCLK5 | DQS0R/CQ1R,DPCLK5 |  |  | DQS0R/CQ1R,DPCLK5
B6 |  |  | VREFB6N0 |  | IO |  |  | VREFB6N0 |  |  | F14 |  | 105
B6 |  |  | VREFB6N0 |  | IO |  |  | DIFFIO_R2n |  |  | D16
B6 |  |  | VREFB6N0 |  | IO |  |  | DIFFIO_R2p |  |  | D15
B6 |  |  | VREFB6N0 |  | IO |  |  |  |  |  | G11
Pin Information for the Cyclone® IV EP4CE10 Device Version 1.2 Notes (1), (2), (3)
Bank Number |  |  | VREFB Group |  | Pin Name / Function |  |  | Optional Function(s) |  | Configuration Function | F256/ U256 |  | E144 (4) | DQS for X8/X9 in F256/U256 | DQS for X16/X18 in F256/U256 |  |  | DQS for X8/X9 in E144
B6 |  |  | VREFB6N0 |  | IO |  |  | DIFFIO_R1n |  |  | C16 |  | 106 | DQS2R/CQ3R | DQS2R/CQ3R
B6 |  |  | VREFB6N0 |  | IO |  |  | DIFFIO_R1p |  |  | C15
B7 |  |  | VREFB7N0 |  | IO |  |  | DIFFIO_T21n |  |  | C14
B7 |  |  | VREFB7N0 |  | IO |  |  | DIFFIO_T21p |  |  | D14 |  |  | DQ5T | DQ5T
B7 |  |  | VREFB7N0 |  | IO |  |  | DIFFIO_T20n |  |  | D11
B7 |  |  | VREFB7N0 |  | IO |  |  | DIFFIO_T20p |  |  | D12 |  | 110 | DQS0T/CQ1T,DPCLK6 | DQS0T/CQ1T,DPCLK6 |  |  | DQS0T/CQ1T,DPCLK6
B7 |  |  | VREFB7N0 |  | IO |  |  | DIFFIO_T19n |  |  | A13
B7 |  |  | VREFB7N0 |  | IO |  |  | DIFFIO_T19p |  |  | B13 |  | 111 | DQ5T | DQ5T
B7 |  |  | VREFB7N0 |  | IO |  |  | PLL2_CLKOUTn |  |  | A14 |  | 112
B7 |  |  | VREFB7N0 |  | IO |  |  | PLL2_CLKOUTp |  |  | B14 |  | 113
B7 |  |  | VREFB7N0 |  | IO |  |  | RUP4 |  |  | E11 |  | 114 |  |  |  |  | DQ1T
B7 |  |  | VREFB7N0 |  | IO |  |  | RDN4 |  |  | E10 |  | 115 |  |  |  |  | DQ1T
B7 |  |  | VREFB7N0 |  | IO |  |  | DIFFIO_T18n |  |  | A12 |  |  | DQ5T | DQ5T
B7 |  |  | VREFB7N0 |  | IO |  |  | DIFFIO_T18p |  |  | B12 |  |  | DQ5T | DQ5T
B7 |  |  | VREFB7N0 |  | IO |  |  | DIFFIO_T17n |  |  | A11 |  |  | DQ5T | DQ5T
B7 |  |  | VREFB7N0 |  | IO |  |  | DIFFIO_T17p |  |  | B11 |  |  | DQ5T | DQ5T
B7 |  |  | VREFB7N0 |  | IO |  |  | VREFB7N0 |  |  | C11 |  | 119
B7 |  |  | VREFB7N0 |  | IO |  |  | DIFFIO_T16n |  |  | F10 |  | 120 |  |  |  |  | DQ1T
B7 |  |  | VREFB7N0 |  | IO |  |  | DIFFIO_T16p |  |  | F9 |  | 121 | DQS2T/CQ3T | DQS2T/CQ3T
B7 |  |  | VREFB7N0 |  | IO |  |  | DIFFIO_T15n |  |  | F11
B7 |  |  | VREFB7N0 |  | IO |  |  | DIFFIO_T15p |  |  | A15
B7 |  |  | VREFB7N0 |  | IO |  |  | DIFFIO_T14n |  |  | A10 |  |  | DQ5T | DQ5T
B7 |  |  | VREFB7N0 |  | IO |  |  | DIFFIO_T14p |  |  | B10 |  |  | DQ5T | DQ5T
B7 |  |  | VREFB7N0 |  | IO |  |  | DIFFIO_T13n |  |  | C9 |  |  | DQ5T | DQ5T
B7 |  |  | VREFB7N0 |  | IO |  |  | DIFFIO_T13p |  |  | D9 |  | 124 | DM5T/BWS#5T | DM5T/BWS#5T
B7 |  |  | VREFB7N0 |  | IO |  |  |  |  |  | E9 |  | 125 | DQS4T/CQ5T | DQS4T/CQ5T
B7 |  |  | VREFB7N0 |  | IO |  |  | DIFFIO_T12n |  |  | A9 |  | 126
B7 |  |  | VREFB7N0 |  | IO |  |  | DIFFIO_T12p |  |  | B9 |  | 127
B8 |  |  | VREFB8N0 |  | IO |  |  | DIFFIO_T11n |  |  | A8 |  | 128
B8 |  |  | VREFB8N0 |  | IO |  |  | DIFFIO_T11p |  |  | B8 |  | 129
B8 |  |  | VREFB8N0 |  | IO |  |  |  |  |  | C8 |  |  | DQS5T/CQ5T# | DQS5T/CQ5T# |  |  | DQS5T/CQ5T#
B8 |  |  | VREFB8N0 |  | IO |  |  |  |  |  | D8 |  |  | DQ3T | DQ5T
B8 |  |  | VREFB8N0 |  | IO |  |  | DIFFIO_T10n |  | DATA2 | E8 |  | 132 | DQ3T | DQ5T |  |  | DQ1T
B8 |  |  | VREFB8N0 |  | IO |  |  | DIFFIO_T10p |  | DATA3 | F8 |  | 133 |  |  |  |  | DQ1T
B8 |  |  | VREFB8N0 |  | IO |  |  | DIFFIO_T9n |  |  | A7 |  |  | DQ3T | DQ5T
B8 |  |  | VREFB8N0 |  | IO |  |  | DIFFIO_T9p |  | DATA4 | B7 |  |  | DQ3T | DQ5T
B8 |  |  | VREFB8N0 |  | IO |  |  | DIFFIO_T8n |  |  | F6 |  | 135 |  |  |  |  | DQ1T
B8 |  |  | VREFB8N0 |  | IO |  |  | DIFFIO_T8p |  |  | F7
B8 |  |  | VREFB8N0 |  | IO |  |  | VREFB8N0 |  |  | C6 |  | 136
B8 |  |  | VREFB8N0 |  | IO |  |  | DIFFIO_T7n |  |  | A6 |  |  | DQS3T/CQ3T# | DQS3T/CQ3T# |  |  | DQS3T/CQ3T#
B8 |  |  | VREFB8N0 |  | IO |  |  | DIFFIO_T7p |  |  | B6 |  |  | DQ3T | DQ5T
B8 |  |  | VREFB8N0 |  | IO |  |  |  |  | DATA5 | E7 |  | 137 | DQ3T | DQ5T |  |  | DQ1T
B8 |  |  | VREFB8N0 |  | IO |  |  |  |  | DATA6 | E6 |  | 138 | DQ3T | DQ5T
B8 |  |  | VREFB8N0 |  | IO |  |  | DIFFIO_T6n |  | DATA7 | A5 |  |  | DQ3T | DQ5T
B8 |  |  | VREFB8N0 |  | IO |  |  | DIFFIO_T5n |  |  | A2
B8 |  |  | VREFB8N0 |  | IO |  |  | DIFFIO_T5p |  |  | B5 |  | 141 | DQ3T | DQ5T
Pin Information for the Cyclone® IV EP4CE10 Device Version 1.2 Notes (1), (2), (3)
Bank Number |  |  | VREFB Group |  | Pin Name / Function |  |  | Optional Function(s) |  | Configuration Function | F256/ U256 |  | E144 (4) | DQS for X8/X9 in F256/U256 | DQS for X16/X18 in F256/U256 |  |  | DQS for X8/X9 in E144
B8 |  |  | VREFB8N0 |  | IO |  |  | DIFFIO_T4n |  |  | A4 |  |  | DM3T/BWS#3T | DM5T/BWS#5T
B8 |  |  | VREFB8N0 |  | IO |  |  | DIFFIO_T4p |  |  | B4
B8 |  |  | VREFB8N0 |  | IO |  |  | DIFFIO_T3n |  |  | D5
B8 |  |  | VREFB8N0 |  | IO |  |  | DIFFIO_T3p |  |  | D6
B8 |  |  | VREFB8N0 |  | IO |  |  | DIFFIO_T2n |  |  | A3
B8 |  |  | VREFB8N0 |  | IO |  |  | DIFFIO_T2p |  |  | B3 |  | 142 | DQS1T/CQ1T#,DPCLK7 | DQS1T/CQ1T#,DPCLK7 |  |  | DQS1T/CQ1T#,DPCLK7
B8 |  |  | VREFB8N0 |  | IO |  |  | DIFFIO_T1n |  |  | C3 |  | 143 |  |  |  |  | DQ1T
B8 |  |  | VREFB8N0 |  | IO |  |  | DIFFIO_T1p |  |  | D3 |  | 144 |  |  |  |  | DM1T
 |  |  |  |  | GND |  |  |  |  |  | H7 |  | 19
 |  |  |  |  | GND |  |  |  |  |  | H8 |  | 27
 |  |  |  |  | GND |  |  |  |  |  | H9 |  | 41
 |  |  |  |  | GND |  |  |  |  |  | H10 |  | 48
 |  |  |  |  | GND |  |  |  |  |  | J7 |  | 57
 |  |  |  |  | GND |  |  |  |  |  | J8 |  | 63
 |  |  |  |  | GND |  |  |  |  |  | J9 |  | 82
 |  |  |  |  | GND |  |  |  |  |  | J10 |  | 95
 |  |  |  |  | GND |  |  |  |  |  | B2 |  | 118
 |  |  |  |  | GND |  |  |  |  |  | B15 |  | 123
 |  |  |  |  | GND |  |  |  |  |  | C5 |  | 131
 |  |  |  |  | GND |  |  |  |  |  | C12 |  | 140
 |  |  |  |  | GND |  |  |  |  |  | D7 |  | 4
 |  |  |  |  | GND |  |  |  |  |  | D10 |  | 22
 |  |  |  |  | GND |  |  |  |  |  | E4 |  | 79
 |  |  |  |  | GND |  |  |  |  |  | E13
 |  |  |  |  | GND |  |  |  |  |  | G4
 |  |  |  |  | GND |  |  |  |  |  | G13
 |  |  |  |  | GND |  |  |  |  |  | K4
 |  |  |  |  | GND |  |  |  |  |  | K13
 |  |  |  |  | GND |  |  |  |  |  | M4
 |  |  |  |  | GND |  |  |  |  |  | M13
 |  |  |  |  | GND |  |  |  |  |  | N7
 |  |  |  |  | GND |  |  |  |  |  | N10
 |  |  |  |  | GND |  |  |  |  |  | P5
 |  |  |  |  | GND |  |  |  |  |  | P12
 |  |  |  |  | GND |  |  |  |  |  | R2
 |  |  |  |  | GND |  |  |  |  |  | R15
 |  |  |  |  | GND |  |  |  |  |  | E2
 |  |  |  |  | GND |  |  |  |  |  | H16
 |  |  |  |  | GND |  |  |  |  |  | H15
 |  |  |  |  | GNDA1 |  |  |  |  |  | M5 |  | 36
 |  |  |  |  | GNDA2 |  |  |  |  |  | E12 |  | 108
 |  |  |  |  | VCCINT |  |  |  |  |  | G6 |  | 5
 |  |  |  |  | VCCINT |  |  |  |  |  | G7 |  | 29
 |  |  |  |  | VCCINT |  |  |  |  |  | G8 |  | 45
 |  |  |  |  | VCCINT |  |  |  |  |  | G9 |  | 61
 |  |  |  |  | VCCINT |  |  |  |  |  | G10 |  | 78
Pin Information for the Cyclone® IV EP4CE10 Device Version 1.2 Notes (1), (2), (3)
Bank Number |  |  | VREFB Group |  | Pin Name / Function |  |  | Optional Function(s) |  | Configuration Function | F256/ U256 |  | E144 (4) | DQS for X8/X9 in F256/U256 | DQS for X16/X18 in F256/U256 |  |  | DQS for X8/X9 in E144
 |  |  |  |  | VCCINT |  |  |  |  |  | H6 |  | 102
 |  |  |  |  | VCCINT |  |  |  |  |  | H11 |  | 116
 |  |  |  |  | VCCINT |  |  |  |  |  | K7 |  | 134
 |  |  |  |  | VCCIO1 |  |  |  |  |  | E3 |  | 17
 |  |  |  |  | VCCIO1 |  |  |  |  |  | G3
 |  |  |  |  | VCCIO2 |  |  |  |  |  | K3 |  | 26
 |  |  |  |  | VCCIO2 |  |  |  |  |  | M3
 |  |  |  |  | VCCIO3 |  |  |  |  |  | P4 |  | 40
 |  |  |  |  | VCCIO3 |  |  |  |  |  | P7 |  | 47
 |  |  |  |  | VCCIO3 |  |  |  |  |  | T1
 |  |  |  |  | VCCIO4 |  |  |  |  |  | P10 |  | 56
 |  |  |  |  | VCCIO4 |  |  |  |  |  | P13 |  | 62
 |  |  |  |  | VCCIO4 |  |  |  |  |  | T16
 |  |  |  |  | VCCIO5 |  |  |  |  |  | K14 |  | 81
 |  |  |  |  | VCCIO5 |  |  |  |  |  | M14
 |  |  |  |  | VCCIO6 |  |  |  |  |  | E14 |  | 93
 |  |  |  |  | VCCIO6 |  |  |  |  |  | G14
 |  |  |  |  | VCCIO7 |  |  |  |  |  | A16 |  | 117
 |  |  |  |  | VCCIO7 |  |  |  |  |  | C10 |  | 122
 |  |  |  |  | VCCIO7 |  |  |  |  |  | C13
 |  |  |  |  | VCCIO8 |  |  |  |  |  | A1 |  | 130
 |  |  |  |  | VCCIO8 |  |  |  |  |  | C4 |  | 139
 |  |  |  |  | VCCIO8 |  |  |  |  |  | C7
 |  |  |  |  | VCCA1 |  |  |  |  |  | L5 |  | 35
 |  |  |  |  | VCCA2 |  |  |  |  |  | F12 |  | 107
 |  |  |  |  | VCCD_PLL1 |  |  |  |  |  | N4 |  | 37
 |  |  |  |  | VCCD_PLL2 |  |  |  |  |  | D13 |  | 109
Notes:
(1) If the p pin or n pin is not available for the package, the particular differential pair is not supported.
(2) For DQS pins that do not have the associated DQ pins, the particular DQS is not supported.
(3) For more information about pin definition and pin connection guidelines, refer to the
Cyclone IV Device Family Pin Connection Guidelines. (http://www.altera.com/literature/dp/cyclone-iv/PCG-01008.pdf)
(4) The E144 package has an exposed pad at the bottom of the package. This exposed pad is a ground pad that must be connected to the ground plane on your PCB.
This exposed pad is used for electrical connectivity, and not for thermal purposes.
Pin Information for the Cyclone® IV EP4CE10 Device Version 1.2
 |  |  |  |  |  | VREFB8N0 |  |  |  |  |  | VREFB7N0 |  |  |  | PLL2
 |  |  |  |  |  | B8 |  |  |  |  |  | B7
 |  | VREFB1N0 |  | B1 |  |  |  |  |  |  |  |  |  |  |  | B6 | VREFB6N0
 |  | VREFB2N0 |  | B2 |  |  |  |  |  |  |  |  |  |  |  | B5 | VREFB5N0
 |  | PLL1 |  |  |  | B3 |  |  |  |  |  | B4
 |  |  |  |  |  | VREFB3N0 |  |  |  |  |  | VREFB4N0
Notes:
1. This is a top view of the silicon die.
2. This is only a pictorial representation to provide an idea of placement on the device. For exact locations, refer to the pin list and the Quartus® II software.
 | Pin Information for the Cyclone® IV EP4CE10 Device Version 1.2
 | Version Number |  |  |  |  |  | Date |  | Changes made
 | 1.0 |  |  |  |  |  | 2010-01-25 |  | Initial Release.
 | 1.1 |  |  |  |  |  | 2010-12-06 |  | Added UBGA package support.
 | 1.2 |  |  |  |  |  | 2011-06-10 |  | Removed Pin Definitions sheet.

Sheet: EP4CE6 Mapping
Pin Information for the Cyclone® IV EP4CE6 Device Version 1.2 Notes (1), (2), (3)
Bank Number |  |  | VREFB Group |  | Pin Name / Function |  |  | Optional Function(s) |  | Configuration Function | F256/ U256 | E144 (4) | DQS for X8/X9 in F256/U256 | DQS for X16/X18 in F256/U256 |  |  | DQS for X8/X9 in E144
B1 |  |  | VREFB1N0 |  | IO |  |  |  |  |  | D4 | 1
B1 |  |  | VREFB1N0 |  | IO |  |  |  |  |  | E5 | 2
B1 |  |  | VREFB1N0 |  | IO |  |  |  |  |  | F5 | 3
B1 |  |  | VREFB1N0 |  | IO |  |  |  |  |  | B1 |  | DQS2L/CQ3L | DQS2L/CQ3L |  |  | DQS2L/CQ3L
B1 |  |  | VREFB1N0 |  | IO |  |  | DIFFIO_L1p |  |  | C2
B1 |  |  | VREFB1N0 |  | IO |  |  | DIFFIO_L1n |  | DATA1,ASDO | C1 | 6
B1 |  |  | VREFB1N0 |  | IO |  |  | VREFB1N0 |  |  | F3 | 7
B1 |  |  | VREFB1N0 |  | IO |  |  | DIFFIO_L2p |  | FLASH_nCE,nCSO | D2 | 8
B1 |  |  | VREFB1N0 |  | IO |  |  | DIFFIO_L2n |  |  | D1
B1 |  |  | VREFB1N0 |  | nSTATUS |  |  |  |  | nSTATUS | F4 | 9
B1 |  |  | VREFB1N0 |  | IO |  |  |  |  |  | G5
B1 |  |  | VREFB1N0 |  | IO |  |  | DIFFIO_L3p |  |  | F2
B1 |  |  | VREFB1N0 |  | IO |  |  | DIFFIO_L3n |  |  | F1
B1 |  |  | VREFB1N0 |  | IO |  |  | DIFFIO_L4p |  |  | G2 | 10 | DQS0L/CQ1L,DPCLK0 | DQS0L/CQ1L,DPCLK0 |  |  | DQS0L/CQ1L,DPCLK0
B1 |  |  | VREFB1N0 |  | IO |  |  | DIFFIO_L4n |  |  | G1 | 11
B1 |  |  | VREFB1N0 |  | DCLK |  |  |  |  | DCLK | H1 | 12
B1 |  |  | VREFB1N0 |  | IO |  |  |  |  | DATA0 | H2 | 13
B1 |  |  | VREFB1N0 |  | nCONFIG |  |  |  |  | nCONFIG | H5 | 14
B1 |  |  | VREFB1N0 |  | TDI |  |  |  |  | TDI | H4 | 15
B1 |  |  | VREFB1N0 |  | TCK |  |  |  |  | TCK | H3 | 16
B1 |  |  | VREFB1N0 |  | TMS |  |  |  |  | TMS | J5 | 18
B1 |  |  | VREFB1N0 |  | TDO |  |  |  |  | TDO | J4 | 20
B1 |  |  | VREFB1N0 |  | nCE |  |  |  |  | nCE | J3 | 21
B1 |  |  | VREFB1N0 |  | CLK1 |  |  | DIFFCLK_0n |  |  | E1 | 23
B2 |  |  | VREFB2N0 |  | CLK2 |  |  | DIFFCLK_1p |  |  | M2 | 24
B2 |  |  | VREFB2N0 |  | CLK3 |  |  | DIFFCLK_1n |  |  | M1 | 25
B2 |  |  | VREFB2N0 |  | IO |  |  | DIFFIO_L5p |  |  | J2 |  | DQ1L
B2 |  |  | VREFB2N0 |  | IO |  |  | DIFFIO_L5n |  |  | J1 |  | DQ1L
B2 |  |  | VREFB2N0 |  | IO |  |  |  |  |  | J6
B2 |  |  | VREFB2N0 |  | IO |  |  | DIFFIO_L6p |  |  | K6
B2 |  |  | VREFB2N0 |  | IO |  |  | DIFFIO_L6n |  |  | L6 | 28
B2 |  |  | VREFB2N0 |  | IO |  |  | DIFFIO_L7p |  |  | K2
B2 |  |  | VREFB2N0 |  | IO |  |  | DIFFIO_L7n |  |  | K1 |  | DQ1L
B2 |  |  | VREFB2N0 |  | IO |  |  | DIFFIO_L8p |  |  | L2 | 30 | DQS1L/CQ1L#,DPCLK1 | DQS1L/CQ1L#,DPCLK1 |  |  | DQS1L/CQ1L#,DPCLK1
B2 |  |  | VREFB2N0 |  | IO |  |  | DIFFIO_L8n |  |  | L1 |  | DQ1L
B2 |  |  | VREFB2N0 |  | IO |  |  | VREFB2N0 |  |  | L3 | 31
B2 |  |  | VREFB2N0 |  | IO |  |  | DIFFIO_L9p |  |  | N2 |  | DQ1L
B2 |  |  | VREFB2N0 |  | IO |  |  | DIFFIO_L9n |  |  | N1 |  | DQ1L
B2 |  |  | VREFB2N0 |  | IO |  |  | RUP1 |  |  | K5 | 32 | DQ1L
B2 |  |  | VREFB2N0 |  | IO |  |  | RDN1 |  |  | L4 | 33 | DQ1L
B2 |  |  | VREFB2N0 |  | IO |  |  |  |  |  |  | 34
B2 |  |  | VREFB2N0 |  | IO |  |  |  |  |  | R1 |  | DQS3L/CQ3L# | DQS3L/CQ3L# |  |  | DQS3L/CQ3L#
B2 |  |  | VREFB2N0 |  | IO |  |  | DIFFIO_L10p |  |  | P2 |  | DQ1L
B2 |  |  | VREFB2N0 |  | IO |  |  | DIFFIO_L10n |  |  | P1 |  | DM1L/BWS#1L
B3 |  |  | VREFB3N0 |  | IO |  |  | DIFFIO_B1p |  |  | N3 | 38
B3 |  |  | VREFB3N0 |  | IO |  |  | DIFFIO_B1n |  |  | P3 | 39 | DM3B/BWS#3B | DM5B/BWS#5B
Pin Information for the Cyclone® IV EP4CE6 Device Version 1.2 Notes (1), (2), (3)
Bank Number |  |  | VREFB Group |  | Pin Name / Function |  |  | Optional Function(s) |  | Configuration Function | F256/ U256 | E144 (4) | DQS for X8/X9 in F256/U256 | DQS for X16/X18 in F256/U256 |  |  | DQS for X8/X9 in E144
B3 |  |  | VREFB3N0 |  | IO |  |  | DIFFIO_B2p |  |  | R3 |  | DQ3B | DQ5B
B3 |  |  | VREFB3N0 |  | IO |  |  | DIFFIO_B2n |  |  | T3
B3 |  |  | VREFB3N0 |  | IO |  |  |  |  |  | T2 | 42 | DQS1B/CQ1B#,DPCLK2 | DQS1B/CQ1B#,DPCLK2 |  |  | DQS1B/CQ1B#,DPCLK2
B3 |  |  | VREFB3N0 |  | IO |  |  | PLL1_CLKOUTp |  |  | R4 | 43
B3 |  |  | VREFB3N0 |  | IO |  |  | PLL1_CLKOUTn |  |  | T4 | 44
B3 |  |  | VREFB3N0 |  | IO |  |  | DIFFIO_B4p |  |  | N5 |  | DQ3B | DQ5B
B3 |  |  | VREFB3N0 |  | IO |  |  | DIFFIO_B4n |  |  | N6 |  | DQ3B | DQ5B
B3 |  |  | VREFB3N0 |  | IO |  |  |  |  |  | M6 |  | DQ3B | DQ5B
B3 |  |  | VREFB3N0 |  | IO |  |  | VREFB3N0 |  |  | P6 | 46
B3 |  |  | VREFB3N0 |  | IO |  |  | DIFFIO_B5p |  |  | M7 |  | DQS3B/CQ3B# | DQS3B/CQ3B# |  |  | DQS3B/CQ3B#
B3 |  |  | VREFB3N0 |  | IO |  |  | DIFFIO_B5n |  |  | K8
B3 |  |  | VREFB3N0 |  | IO |  |  | DIFFIO_B6p |  |  | R5 |  | DQ3B | DQ5B
B3 |  |  | VREFB3N0 |  | IO |  |  | DIFFIO_B6n |  |  | T5
B3 |  |  | VREFB3N0 |  | IO |  |  | DIFFIO_B7p |  |  | R6 |  | DQ3B | DQ5B
B3 |  |  | VREFB3N0 |  | IO |  |  | DIFFIO_B7n |  |  | T6
B3 |  |  | VREFB3N0 |  | IO |  |  |  |  |  | L7 |  | DQ3B | DQ5B
B3 |  |  | VREFB3N0 |  | IO |  |  | DIFFIO_B8p |  |  | R7 |  | DQ3B | DQ5B
B3 |  |  | VREFB3N0 |  | IO |  |  | DIFFIO_B8n |  |  | T7 |  | DQS5B/CQ5B# | DQS5B/CQ5B# |  |  | DQS5B/CQ5B#
B3 |  |  | VREFB3N0 |  | IO |  |  | DIFFIO_B9p |  |  | L8 | 49 | DQ3B | DQ5B |  |  | DQ1B
B3 |  |  | VREFB3N0 |  | IO |  |  | DIFFIO_B9n |  |  | M8 | 50 | DM5B/BWS#5B | DM5B/BWS#5B |  |  | DQ1B
B3 |  |  | VREFB3N0 |  | IO |  |  | DIFFIO_B10p |  |  | N8 | 51 | DQ5B | DQ5B |  |  | DQ1B
B3 |  |  | VREFB3N0 |  | IO |  |  | DIFFIO_B10n |  |  | P8 |  | DQ5B | DQ5B
B3 |  |  | VREFB3N0 |  | IO |  |  | DIFFIO_B11p |  |  | R8 | 52
B3 |  |  | VREFB3N0 |  | IO |  |  | DIFFIO_B11n |  |  | T8 | 53
B4 |  |  | VREFB4N0 |  | IO |  |  | DIFFIO_B12p |  |  | R9 | 54
B4 |  |  | VREFB4N0 |  | IO |  |  | DIFFIO_B12n |  |  | T9 | 55
B4 |  |  | VREFB4N0 |  | IO |  |  | DIFFIO_B13p |  |  | K9
B4 |  |  | VREFB4N0 |  | IO |  |  | DIFFIO_B13n |  |  | L9
B4 |  |  | VREFB4N0 |  | IO |  |  | DIFFIO_B14p |  |  | M9
B4 |  |  | VREFB4N0 |  | IO |  |  | DIFFIO_B14n |  |  | N9 |  | DQ5B | DQ5B
B4 |  |  | VREFB4N0 |  | IO |  |  | DIFFIO_B15p |  |  | R10 | 58 | DQ5B | DQ5B |  |  | DQ1B
B4 |  |  | VREFB4N0 |  | IO |  |  | DIFFIO_B15n |  |  | T10 |  | DQS4B/CQ5B | DQS4B/CQ5B |  |  | DQS4B/CQ5B
B4 |  |  | VREFB4N0 |  | IO |  |  | DIFFIO_B16p |  |  | R11 | 59 | DQ5B | DQ5B |  |  | DQ1B
B4 |  |  | VREFB4N0 |  | IO |  |  | DIFFIO_B16n |  |  | T11 | 60 |  |  |  |  | DQ1B
B4 |  |  | VREFB4N0 |  | IO |  |  | DIFFIO_B17p |  |  | R12 |  | DQ5B | DQ5B
B4 |  |  | VREFB4N0 |  | IO |  |  | DIFFIO_B17n |  |  | T12 |  | DQ5B | DQ5B
B4 |  |  | VREFB4N0 |  | IO |  |  | DIFFIO_B18p |  |  | K10
B4 |  |  | VREFB4N0 |  | IO |  |  | DIFFIO_B18n |  |  | L10
B4 |  |  | VREFB4N0 |  | IO |  |  |  |  |  | P9 | 64 | DQS2B/CQ3B | DQS2B/CQ3B
B4 |  |  | VREFB4N0 |  | IO |  |  | VREFB4N0 |  |  | P11 | 65
B4 |  |  | VREFB4N0 |  | IO |  |  | DIFFIO_B19p |  |  | R13
B4 |  |  | VREFB4N0 |  | IO |  |  | DIFFIO_B19n |  |  | T13 |  | DQ5B | DQ5B
B4 |  |  | VREFB4N0 |  | IO |  |  | RUP2 |  |  | M10 | 66 |  |  |  |  | DQ1B
B4 |  |  | VREFB4N0 |  | IO |  |  | RDN2 |  |  | N11 | 67 |  |  |  |  | DQ1B
B4 |  |  | VREFB4N0 |  | IO |  |  | DIFFIO_B20p |  |  | T14 |  | DQ5B | DQ5B
B4 |  |  | VREFB4N0 |  | IO |  |  | DIFFIO_B20n |  |  | T15 | 68 | DQS0B/CQ1B,DPCLK3 | DQS0B/CQ1B,DPCLK3 |  |  | DQS0B/CQ1B,DPCLK3
Pin Information for the Cyclone® IV EP4CE6 Device Version 1.2 Notes (1), (2), (3)
Bank Number |  |  | VREFB Group |  | Pin Name / Function |  |  | Optional Function(s) |  | Configuration Function | F256/ U256 | E144 (4) | DQS for X8/X9 in F256/U256 | DQS for X16/X18 in F256/U256 |  |  | DQS for X8/X9 in E144
B4 |  |  | VREFB4N0 |  | IO |  |  |  |  |  | R14 | 69
B4 |  |  | VREFB4N0 |  | IO |  |  | DIFFIO_B21p |  |  | P14 | 70
B4 |  |  | VREFB4N0 |  | IO |  |  | DIFFIO_B21n |  |  | L11 | 71
B4 |  |  | VREFB4N0 |  | IO |  |  | DIFFIO_B22p |  |  | M11 | 72
B4 |  |  | VREFB4N0 |  | IO |  |  | DIFFIO_B22n |  |  | N12
B5 |  |  | VREFB5N0 |  | IO |  |  |  |  |  | N13 | 73
B5 |  |  | VREFB5N0 |  | IO |  |  |  |  |  | M12 | 74
B5 |  |  | VREFB5N0 |  | IO |  |  |  |  |  | L12 | 75
B5 |  |  | VREFB5N0 |  | IO |  |  |  |  |  | K12
B5 |  |  | VREFB5N0 |  | IO |  |  | RUP3 |  |  | N14 | 76 | DM1R/BWS#1R
B5 |  |  | VREFB5N0 |  | IO |  |  | RDN3 |  |  | P15 | 77 | DQ1R
B5 |  |  | VREFB5N0 |  | IO |  |  | DIFFIO_R11n |  |  | P16 |  | DQS3R/CQ3R# | DQS3R/CQ3R# |  |  | DQS3R/CQ3R#
B5 |  |  | VREFB5N0 |  | IO |  |  | DIFFIO_R11p |  |  | R16 |  | DQ1R
B5 |  |  | VREFB5N0 |  | IO |  |  |  |  |  | K11
B5 |  |  | VREFB5N0 |  | IO |  |  | DIFFIO_R10n |  |  | N16 |  | DQ1R
B5 |  |  | VREFB5N0 |  | IO |  |  | DIFFIO_R10p |  |  | N15 |  | DQ1R
B5 |  |  | VREFB5N0 |  | IO |  |  | VREFB5N0 |  |  | L14 | 80
B5 |  |  | VREFB5N0 |  | IO |  |  |  |  |  | L13 |  | DQ1R
B5 |  |  | VREFB5N0 |  | IO |  |  | DIFFIO_R9n |  |  | L16 |  | DQ1R
B5 |  |  | VREFB5N0 |  | IO |  |  | DIFFIO_R9p |  |  | L15
B5 |  |  | VREFB5N0 |  | IO |  |  |  |  |  | J11 | 83
B5 |  |  | VREFB5N0 |  | IO |  |  | DIFFIO_R8n |  |  | K16 | 84 | DQ1R
B5 |  |  | VREFB5N0 |  | IO |  |  | DIFFIO_R8p |  |  | K15 | 85 | DQS1R/CQ1R#,DPCLK4 | DQS1R/CQ1R#,DPCLK4 |  |  | DQS1R/CQ1R#,DPCLK4
B5 |  |  | VREFB5N0 |  | IO |  |  | DIFFIO_R7n |  | DEV_OE | J16 | 86
B5 |  |  | VREFB5N0 |  | IO |  |  | DIFFIO_R7p |  | DEV_CLRn | J15 | 87
B5 |  |  | VREFB5N0 |  | IO |  |  | DIFFIO_R6n |  |  | J14 |  | DQ1R
B5 |  |  | VREFB5N0 |  | IO |  |  | DIFFIO_R6p |  |  | J12
B5 |  |  | VREFB5N0 |  | IO |  |  |  |  |  | J13 |  | DQ1R
B5 |  |  | VREFB5N0 |  | CLK7 |  |  | DIFFCLK_3n |  |  | M16 | 88
B5 |  |  | VREFB5N0 |  | CLK6 |  |  | DIFFCLK_3p |  |  | M15 | 89
B6 |  |  | VREFB6N0 |  | CLK5 |  |  | DIFFCLK_2n |  |  | E16 | 90
B6 |  |  | VREFB6N0 |  | CLK4 |  |  | DIFFCLK_2p |  |  | E15 | 91
B6 |  |  | VREFB6N0 |  | CONF_DONE |  |  |  |  | CONF_DONE | H14 | 92
B6 |  |  | VREFB6N0 |  | MSEL0 |  |  |  |  | MSEL0 | H13 | 94
B6 |  |  | VREFB6N0 |  | MSEL1 |  |  |  |  | MSEL1 | H12 | 96
B6 |  |  | VREFB6N0 |  | MSEL2 |  |  |  |  | MSEL2 | G12 | 97
B6 |  |  | VREFB6N0 |  | IO |  |  | DIFFIO_R4n |  | INIT_DONE | G16 | 98
B6 |  |  | VREFB6N0 |  | IO |  |  | DIFFIO_R4p |  | CRC_ERROR | G15 | 99
B6 |  |  | VREFB6N0 |  | IO |  |  |  |  |  | F13 | 100
B6 |  |  | VREFB6N0 |  | IO |  |  | DIFFIO_R3n |  | nCEO | F16 | 101
B6 |  |  | VREFB6N0 |  | IO |  |  | DIFFIO_R3p |  | CLKUSR | F15 | 103
B6 |  |  | VREFB6N0 |  | IO |  |  |  |  |  | B16 | 104 | DQS0R/CQ1R,DPCLK5 | DQS0R/CQ1R,DPCLK5 |  |  | DQS0R/CQ1R,DPCLK5
B6 |  |  | VREFB6N0 |  | IO |  |  | VREFB6N0 |  |  | F14 | 105
B6 |  |  | VREFB6N0 |  | IO |  |  | DIFFIO_R2n |  |  | D16
B6 |  |  | VREFB6N0 |  | IO |  |  | DIFFIO_R2p |  |  | D15
B6 |  |  | VREFB6N0 |  | IO |  |  |  |  |  | G11
Pin Information for the Cyclone® IV EP4CE6 Device Version 1.2 Notes (1), (2), (3)
Bank Number |  |  | VREFB Group |  | Pin Name / Function |  |  | Optional Function(s) |  | Configuration Function | F256/ U256 | E144 (4) | DQS for X8/X9 in F256/U256 | DQS for X16/X18 in F256/U256 |  |  | DQS for X8/X9 in E144
B6 |  |  | VREFB6N0 |  | IO |  |  | DIFFIO_R1n |  |  | C16 | 106 | DQS2R/CQ3R | DQS2R/CQ3R
B6 |  |  | VREFB6N0 |  | IO |  |  | DIFFIO_R1p |  |  | C15
B7 |  |  | VREFB7N0 |  | IO |  |  | DIFFIO_T21n |  |  | C14
B7 |  |  | VREFB7N0 |  | IO |  |  | DIFFIO_T21p |  |  | D14 |  | DQ5T | DQ5T
B7 |  |  | VREFB7N0 |  | IO |  |  | DIFFIO_T20n |  |  | D11
B7 |  |  | VREFB7N0 |  | IO |  |  | DIFFIO_T20p |  |  | D12 | 110 | DQS0T/CQ1T,DPCLK6 | DQS0T/CQ1T,DPCLK6 |  |  | DQS0T/CQ1T,DPCLK6
B7 |  |  | VREFB7N0 |  | IO |  |  | DIFFIO_T19n |  |  | A13
B7 |  |  | VREFB7N0 |  | IO |  |  | DIFFIO_T19p |  |  | B13 | 111 | DQ5T | DQ5T
B7 |  |  | VREFB7N0 |  | IO |  |  | PLL2_CLKOUTn |  |  | A14 | 112
B7 |  |  | VREFB7N0 |  | IO |  |  | PLL2_CLKOUTp |  |  | B14 | 113
B7 |  |  | VREFB7N0 |  | IO |  |  | RUP4 |  |  | E11 | 114 |  |  |  |  | DQ1T
B7 |  |  | VREFB7N0 |  | IO |  |  | RDN4 |  |  | E10 | 115 |  |  |  |  | DQ1T
B7 |  |  | VREFB7N0 |  | IO |  |  | DIFFIO_T18n |  |  | A12 |  | DQ5T | DQ5T
B7 |  |  | VREFB7N0 |  | IO |  |  | DIFFIO_T18p |  |  | B12 |  | DQ5T | DQ5T
B7 |  |  | VREFB7N0 |  | IO |  |  | DIFFIO_T17n |  |  | A11 |  | DQ5T | DQ5T
B7 |  |  | VREFB7N0 |  | IO |  |  | DIFFIO_T17p |  |  | B11 |  | DQ5T | DQ5T
B7 |  |  | VREFB7N0 |  | IO |  |  | VREFB7N0 |  |  | C11 | 119
B7 |  |  | VREFB7N0 |  | IO |  |  | DIFFIO_T16n |  |  | F10 | 120 |  |  |  |  | DQ1T
B7 |  |  | VREFB7N0 |  | IO |  |  | DIFFIO_T16p |  |  | F9 | 121 | DQS2T/CQ3T | DQS2T/CQ3T
B7 |  |  | VREFB7N0 |  | IO |  |  | DIFFIO_T15n |  |  | F11
B7 |  |  | VREFB7N0 |  | IO |  |  | DIFFIO_T15p |  |  | A15
B7 |  |  | VREFB7N0 |  | IO |  |  | DIFFIO_T14n |  |  | A10 |  | DQ5T | DQ5T
B7 |  |  | VREFB7N0 |  | IO |  |  | DIFFIO_T14p |  |  | B10 |  | DQ5T | DQ5T
B7 |  |  | VREFB7N0 |  | IO |  |  | DIFFIO_T13n |  |  | C9 |  | DQ5T | DQ5T
B7 |  |  | VREFB7N0 |  | IO |  |  | DIFFIO_T13p |  |  | D9 | 124 | DM5T/BWS#5T | DM5T/BWS#5T
B7 |  |  | VREFB7N0 |  | IO |  |  |  |  |  | E9 | 125 | DQS4T/CQ5T | DQS4T/CQ5T
B7 |  |  | VREFB7N0 |  | IO |  |  | DIFFIO_T12n |  |  | A9 | 126
B7 |  |  | VREFB7N0 |  | IO |  |  | DIFFIO_T12p |  |  | B9 | 127
B8 |  |  | VREFB8N0 |  | IO |  |  | DIFFIO_T11n |  |  | A8 | 128
B8 |  |  | VREFB8N0 |  | IO |  |  | DIFFIO_T11p |  |  | B8 | 129
B8 |  |  | VREFB8N0 |  | IO |  |  |  |  |  | C8 |  | DQS5T/CQ5T# | DQS5T/CQ5T# |  |  | DQS5T/CQ5T#
B8 |  |  | VREFB8N0 |  | IO |  |  |  |  |  | D8 |  | DQ3T | DQ5T
B8 |  |  | VREFB8N0 |  | IO |  |  | DIFFIO_T10n |  | DATA2 | E8 | 132 | DQ3T | DQ5T |  |  | DQ1T
B8 |  |  | VREFB8N0 |  | IO |  |  | DIFFIO_T10p |  | DATA3 | F8 | 133 |  |  |  |  | DQ1T
B8 |  |  | VREFB8N0 |  | IO |  |  | DIFFIO_T9n |  |  | A7 |  | DQ3T | DQ5T
B8 |  |  | VREFB8N0 |  | IO |  |  | DIFFIO_T9p |  | DATA4 | B7 |  | DQ3T | DQ5T
B8 |  |  | VREFB8N0 |  | IO |  |  | DIFFIO_T8n |  |  | F6 | 135 |  |  |  |  | DQ1T
B8 |  |  | VREFB8N0 |  | IO |  |  | DIFFIO_T8p |  |  | F7
B8 |  |  | VREFB8N0 |  | IO |  |  | VREFB8N0 |  |  | C6 | 136
B8 |  |  | VREFB8N0 |  | IO |  |  | DIFFIO_T7n |  |  | A6 |  | DQS3T/CQ3T# | DQS3T/CQ3T# |  |  | DQS3T/CQ3T#
B8 |  |  | VREFB8N0 |  | IO |  |  | DIFFIO_T7p |  |  | B6 |  | DQ3T | DQ5T
B8 |  |  | VREFB8N0 |  | IO |  |  |  |  | DATA5 | E7 | 137 | DQ3T | DQ5T |  |  | DQ1T
B8 |  |  | VREFB8N0 |  | IO |  |  |  |  | DATA6 | E6 | 138 | DQ3T | DQ5T
B8 |  |  | VREFB8N0 |  | IO |  |  | DIFFIO_T6n |  | DATA7 | A5 |  | DQ3T | DQ5T
B8 |  |  | VREFB8N0 |  | IO |  |  | DIFFIO_T5n |  |  | A2
B8 |  |  | VREFB8N0 |  | IO |  |  | DIFFIO_T5p |  |  | B5 | 141 | DQ3T | DQ5T
Pin Information for the Cyclone® IV EP4CE6 Device Version 1.2 Notes (1), (2), (3)
Bank Number |  |  | VREFB Group |  | Pin Name / Function |  |  | Optional Function(s) |  | Configuration Function | F256/ U256 | E144 (4) | DQS for X8/X9 in F256/U256 | DQS for X16/X18 in F256/U256 |  |  | DQS for X8/X9 in E144
B8 |  |  | VREFB8N0 |  | IO |  |  | DIFFIO_T4n |  |  | A4 |  | DM3T/BWS#3T | DM5T/BWS#5T
B8 |  |  | VREFB8N0 |  | IO |  |  | DIFFIO_T4p |  |  | B4
B8 |  |  | VREFB8N0 |  | IO |  |  | DIFFIO_T3n |  |  | D5
B8 |  |  | VREFB8N0 |  | IO |  |  | DIFFIO_T3p |  |  | D6
B8 |  |  | VREFB8N0 |  | IO |  |  | DIFFIO_T2n |  |  | A3
B8 |  |  | VREFB8N0 |  | IO |  |  | DIFFIO_T2p |  |  | B3 | 142 | DQS1T/CQ1T#,DPCLK7 | DQS1T/CQ1T#,DPCLK7 |  |  | DQS1T/CQ1T#,DPCLK7
B8 |  |  | VREFB8N0 |  | IO |  |  | DIFFIO_T1n |  |  | C3 | 143 |  |  |  |  | DQ1T
B8 |  |  | VREFB8N0 |  | IO |  |  | DIFFIO_T1p |  |  | D3 | 144 |  |  |  |  | DM1T
 |  |  |  |  | GND |  |  |  |  |  | H7 | 19
 |  |  |  |  | GND |  |  |  |  |  | H8 | 27
 |  |  |  |  | GND |  |  |  |  |  | H9 | 41
 |  |  |  |  | GND |  |  |  |  |  | H10 | 48
 |  |  |  |  | GND |  |  |  |  |  | J7 | 57
 |  |  |  |  | GND |  |  |  |  |  | J8 | 63
 |  |  |  |  | GND |  |  |  |  |  | J9 | 82
 |  |  |  |  | GND |  |  |  |  |  | J10 | 95
 |  |  |  |  | GND |  |  |  |  |  | B2 | 118
 |  |  |  |  | GND |  |  |  |  |  | B15 | 123
 |  |  |  |  | GND |  |  |  |  |  | C5 | 131
 |  |  |  |  | GND |  |  |  |  |  | C12 | 140
 |  |  |  |  | GND |  |  |  |  |  | D7 | 4
 |  |  |  |  | GND |  |  |  |  |  | D10 | 22
 |  |  |  |  | GND |  |  |  |  |  | E4 | 79
 |  |  |  |  | GND |  |  |  |  |  | E13
 |  |  |  |  | GND |  |  |  |  |  | G4
 |  |  |  |  | GND |  |  |  |  |  | G13
 |  |  |  |  | GND |  |  |  |  |  | K4
 |  |  |  |  | GND |  |  |  |  |  | K13
 |  |  |  |  | GND |  |  |  |  |  | M4
 |  |  |  |  | GND |  |  |  |  |  | M13
 |  |  |  |  | GND |  |  |  |  |  | N7
 |  |  |  |  | GND |  |  |  |  |  | N10
 |  |  |  |  | GND |  |  |  |  |  | P5
 |  |  |  |  | GND |  |  |  |  |  | P12
 |  |  |  |  | GND |  |  |  |  |  | R2
 |  |  |  |  | GND |  |  |  |  |  | R15
 |  |  |  |  | GND |  |  |  |  |  | E2
 |  |  |  |  | GND |  |  |  |  |  | H16
 |  |  |  |  | GND |  |  |  |  |  | H15
 |  |  |  |  | GNDA1 |  |  |  |  |  | M5 | 36
 |  |  |  |  | GNDA2 |  |  |  |  |  | E12 | 108
 |  |  |  |  | VCCINT |  |  |  |  |  | G6 | 5
 |  |  |  |  | VCCINT |  |  |  |  |  | G7 | 29
 |  |  |  |  | VCCINT |  |  |  |  |  | G8 | 45
 |  |  |  |  | VCCINT |  |  |  |  |  | G9 | 61
 |  |  |  |  | VCCINT |  |  |  |  |  | G10 | 78
Pin Information for the Cyclone® IV EP4CE6 Device Version 1.2 Notes (1), (2), (3)
Bank Number |  |  | VREFB Group |  | Pin Name / Function |  |  | Optional Function(s) |  | Configuration Function | F256/ U256 | E144 (4) | DQS for X8/X9 in F256/U256 | DQS for X16/X18 in F256/U256 |  |  | DQS for X8/X9 in E144
 |  |  |  |  | VCCINT |  |  |  |  |  | H6 | 102
 |  |  |  |  | VCCINT |  |  |  |  |  | H11 | 116
 |  |  |  |  | VCCINT |  |  |  |  |  | K7 | 134
 |  |  |  |  | VCCIO1 |  |  |  |  |  | E3 | 17
 |  |  |  |  | VCCIO1 |  |  |  |  |  | G3
 |  |  |  |  | VCCIO2 |  |  |  |  |  | K3 | 26
 |  |  |  |  | VCCIO2 |  |  |  |  |  | M3
 |  |  |  |  | VCCIO3 |  |  |  |  |  | P4 | 40
 |  |  |  |  | VCCIO3 |  |  |  |  |  | P7 | 47
 |  |  |  |  | VCCIO3 |  |  |  |  |  | T1
 |  |  |  |  | VCCIO4 |  |  |  |  |  | P10 | 56
 |  |  |  |  | VCCIO4 |  |  |  |  |  | P13 | 62
 |  |  |  |  | VCCIO4 |  |  |  |  |  | T16
 |  |  |  |  | VCCIO5 |  |  |  |  |  | K14 | 81
 |  |  |  |  | VCCIO5 |  |  |  |  |  | M14
 |  |  |  |  | VCCIO6 |  |  |  |  |  | E14 | 93
 |  |  |  |  | VCCIO6 |  |  |  |  |  | G14
 |  |  |  |  | VCCIO7 |  |  |  |  |  | A16 | 117
 |  |  |  |  | VCCIO7 |  |  |  |  |  | C10 | 122
 |  |  |  |  | VCCIO7 |  |  |  |  |  | C13
 |  |  |  |  | VCCIO8 |  |  |  |  |  | A1 | 130
 |  |  |  |  | VCCIO8 |  |  |  |  |  | C4 | 139
 |  |  |  |  | VCCIO8 |  |  |  |  |  | C7
 |  |  |  |  | VCCA1 |  |  |  |  |  | L5 | 35
 |  |  |  |  | VCCA2 |  |  |  |  |  | F12 | 107
 |  |  |  |  | VCCD_PLL1 |  |  |  |  |  | N4 | 37
 |  |  |  |  | VCCD_PLL2 |  |  |  |  |  | D13 | 109
Notes:
(1) If the p pin or n pin is not available for the package, the particular differential pair is not supported.
(2) For DQS pins that do not have the associated DQ pins, the particular DQS is not supported.
(3) For more information about pin definition and pin connection guidelines, refer to the
Cyclone IV Device Family Pin Connection Guidelines. (http://www.altera.com/literature/dp/cyclone-iv/PCG-01008.pdf)
(4) The E144 package has an exposed pad at the bottom of the package. This exposed pad is a ground pad that must be connected to the ground plane on your PCB.
This exposed pad is used for electrical connectivity, and not for thermal purposes.
Pin Information for the Cyclone® IV EP4CE6 Device Version 1.2
 |  |  |  |  |  | VREFB8N0 |  |  |  |  | VREFB7N0 |  |  |  | PLL2
 |  |  |  |  |  | B8 |  |  |  |  | B7
 |  | VREFB1N0 |  | B1 |  |  |  |  |  |  |  |  |  |  | B6 | VREFB6N0
 |  | VREFB2N0 |  | B2 |  |  |  |  |  |  |  |  |  |  | B5 | VREFB5N0
 |  | PLL1 |  |  |  | B3 |  |  |  |  | B4
 |  |  |  |  |  | VREFB3N0 |  |  |  |  | VREFB4N0
Notes:
1. This is a top view of the silicon die.
2. This is only a pictorial representation to provide an idea of placement on the device. For exact locations, refer to the pin list and the Quartus® II software.
 | Pin Information for the Cyclone® IV EP4CE6 Device Version 1.2
 | Version Number |  |  |  |  |  | Date |  | Changes made
 | 1.0 |  |  |  |  |  | 2010-01-25 |  | Initial Release.
 | 1.1 |  |  |  |  |  | 2010-12-06 |  | Added UBGA package support.
 | 1.2 |  |  |  |  |  | 2011-06-10 |  | Removed Pin Definitions sheet.

Sheet: AC608 Pins
ac608 pin | ep4ce10 pin | AC608 comment | e144 equivalent
1 | T14 |  | 0
2 | T15 |  | 68
3 | R16 |  | 0
4 | P15 |  | 77
5 | P16 |  | 0
6 | N15 |  | 0
7 | N16 |  | 0
8 | M15 | INPUT ONLY | 89
9 | M16 | INPUT ONLY | 88
10 | L15 |  | 0
11 | L16 |  | 0
12 | P11 |  | 65
13 | N11 |  | 67
14 | VDD3.3 |  | ERR
15 | GND |  | ERR
16 | N12 |  | 0
17 | P14 |  | 70
18 | N14 |  | 76
19 | L13 |  | 0
20 | K16 |  | 84
21 | J15 |  | 87
22 | J16 |  | 86
23 | L14 |  | 80
24 | J14 |  | 0
25 | K15 |  | 85
26 | F16 |  | 101
27 | G15 |  | 99
28 | F15 |  | 103
29 | E16 | INPUT ONLY | 90
30 | D16 |  | 0
31 | D15 |  | 0
32 | C16 |  | 106
33 | C15 |  | 0
34 | B16 |  | 104
35 | J13 |  | 0
36 | G16 |  | 98
37 | F8 |  | 133
38 | F13 |  | 100
39 | F14 |  | 105
40 | F9 |  | 121
41 | E11 |  | 114
42 | A9 | INPUT ONLY | 126
43 | B9 | INPUT ONLY | 127
44 | C9 |  | 0
45 | A8 | INPUT ONLY | 128
46 | D9 |  | 124
47 | B8 | INPUT ONLY | 129
48 | VDD3.3 |  | ERR
49 | GND |  | ERR
50 | E1 | INPUT ONLY | 23
51 | B1 |  | 0
52 | C2 |  | 0
53 | D1 |  | 0
54 | F3 |  | 7
55 | F2 |  | 0
56 | F1 |  | 0
57 | G5 |  | 0
58 | G2 |  | 10
59 | G1 |  | 11
60 | H3 | TCK | 16
61 | H4 | TDI | 15
62 | J5 | TMS | 18
63 | VDD2.5 |  | ERR
64 | J4 | TDO | 20
65 | K5 |  | 32
66 | L4 |  | 33
67 | M6 |  | 0
68 | N3 |  | 38
69 | N5 |  | 0
70 | P3 |  | 39
71 | L7 |  | 0
72 | N6 |  | 0
73 | GND |  | ERR
74 | VDD1.2 |  | ERR
75 | P6 |  | 46
76 | M7 |  | 0
77 | M8 |  | 50
78 | VDD3.3 |  | ERR
79 | GND |  | ERR
80 | P8 |  | 0
81 | N8 |  | 51
82 | L8 |  | 49
83 | N9 |  | 0
84 | P9 |  | 64
85 | M10 |  | 66
86 | J1 | LVDS_TX1_N | 0
87 | J2 | LVDS_TX1_P | 0
88 | K1 | LVDS_TX2_N | 0
89 | K2 | LVDS_TX2_P | 0
90 | L1 | LVDS_TX3_N | 0
91 | L2 | LVDS_TX3_P | 30
92 | M1 | INPUT ONLY / RXCLK_N | 25
93 | M2 | INPUT ONLY / RXCLK_P | 24
94 | N1 | LVDS_TX4_N | 0
95 | N2 | LVDS_TX4_P | 0
96 | P1 | LVDS_TX5_N | 0
97 | P2 | LVDS_TX5_P | 0
98 | R1 |  | 0
99 | T2 |  | 42
100 | R3 |  | 0
101 | T3 |  | 0
102 | R4 |  | 43
103 | T4 |  | 44
104 | R5 |  | 0
105 | T5 |  | 0
106 | VDD3.3 |  | ERR
107 | GND |  | ERR
108 | R6 |  | 0
109 | T6 |  | 0
110 | R7 |  | 0
111 | T7 |  | 0
112 | R8 | INPUT ONLY | 52
113 | T8 | INPUT ONLY | 53
114 | R9 | INPUT ONLY | 54
115 | T9 | INPUT ONLY | 55
116 | R10 |  | 58
117 | T10 |  | 0
118 | R11 |  | 59
119 | T11 |  | 60
120 | R12 |  | 0
121 | T12 |  | 0
122 | R13 |  | 0
123 | T13 |  | 0
124 | R14 |  | 69

Sheet: D-Lev To Waveshare
Eric Pin Left |  | Waveshare Pin Left | Eric Pin Right |  | Waveshare Pin Right
2 | GND | 1 | 2 | 3V3 | 1
4 | NC | 3 | 4 | NC | 3
6 | NC | 5 | 6 | NC | 5
8 | pitch_quad_i | 7 | 8 | NC | 7
10 | pitch_sq_o | 9 | 10 | NC | 9
12 | pitch_zero_i | 11 | 12 | NC | 11
14 | NC | 13 | 14 | NC | 13
16 | midi_tx_o | 15 | 16 | NC | 15
18 | enc_7_i[0] | 17 | 18 | NC | 17
20 | enc_5_i[0] | 19 | 20 | midi_tx_n_o | 19
22 | enc_3_i[0] | 21 | 22 | gpio_o[3] | 21
24 | GND | 23 | 24 | 5V | 23
26 | enc_1_i[0] | 25 | 26 | NC | 25
28 | enc_1_i[1] | 27 | 28 | NC | 27
30 | pb_i[1] | 29 | 30 | spi_scl_o | 29
32 | enc_3_i[1] | 31 | 32 | spi_sdi_o | 31
34 | pb_i[3] | 33 | 34 | spi_sdo_i | 33
36 | enc_5_i[1] | 35 | 36 | spi_scs_o | 35
38 | pb_i[5] | 37 | 38 | gpio_i[3] | 37
40 | enc_7_i[1] | 39 | 40 | gpio_i[2] | 39
42 | pb_i[7] | 41 | 42 | spdif_tx_o[0] | 41
44 | pb_acal_i/gpio_i[1] | 43 | 44 | spdif_tx_o[1] | 43
1 | 3V3 | 2 | 1 | GND | 2
3 | NC | 4 | 3 | NC | 4
5 | NC | 6 | 5 | NC | 6
7 | NC | 8 | 7 | volume_zero_i | 8
9 | NC | 10 | 9 | volume_sq_o | 10
11 | NC | 12 | 11 | volume_quad_i | 12
13 | lcd_data_o[0] | 14 | 13 | pb_i[6] | 14
15 | lcd_data_o[2] | 16 | 15 | enc_6_i[1] | 16
17 | lcd_data_o[3] | 18 | 17 | pb_i[4] | 18
19 | lcd_data_o[1] | 20 | 19 | enc_4_i[1] | 20
21 | lcd_e_o | 22 | 21 | pb_i[2] | 22
23 | 5V | 24 | 23 | GND | 24
25 | lcd_rs_o | 26 | 25 | NC | 26
27 | lcd_pwm_o/gpio_o[1] | 28 | 27 | NC | 28
29 | mute_led_o/gpio_o[0] | 30 | 29 | enc_2_i[1] | 30
31 | gpio_o[2] | 32 | 31 | pb_i[0] | 32
33 | tuner_scl_o | 34 | 33 | enc_0_i[1] | 34
35 | tuner_le_o | 36 | 35 | enc_0_i[0] | 36
37 | tuner_oe_o | 38 | 37 | enc_2_i[0] | 38
39 | tuner_sda_o | 40 | 39 | enc_4_i[0] | 40
41 | uart_rx_i | 42 | 41 | enc_6_i[0] | 42
43 | uart_tx_o | 44 | 43 | pb_mute_i/gpio_i[0] | 44

Sheet: Waveshare to E144
Waveshare Left | E144 | Altera Comment | FBGA Equiv | AC608 | FBGA | Xiaomege Comment | D-Lev Function | FBGA (check)
1 | 4 | 0 | D7 | not found |  |  | GND | err
2 | 3V3 | not found |  | not found |  |  | 3V3 | match
3 | 59 | 0 | R11 | 118 | R11 | 0 | NC | match
4 | 60 | 0 | T11 | 119 | T11 | 0 | NC | match
5 | 64 | 0 | P9 | 84 | P9 | 0 | NC | match
6 | 65 | 0 | P11 | 12 | P11 | 0 | NC | match
7 | 66 | 0 | M10 | 85 | M10 | 0 | pitch_quad_i | match
8 | 67 | 0 | N11 | 13 | N11 | 0 | NC | match
9 | 68 | 0 | T15 | 2 | T15 | 0 | pitch_sq_o | match
10 | 69 | 0 | R14 | 124 | R14 | 0 | NC | match
11 | 70 | 0 | P14 | 17 | P14 | 0 | pitch_zero_i | match
12 | 71 | 0 | L11 | not found |  |  | NC | err
13 | 72 | 0 | M11 | not found |  |  | NC | err
14 | 73 | 0 | N13 | not found |  |  | lcd_data_o[0] | err
15 | 74 | 0 | M12 | not found |  |  | midi_tx_o | err
16 | 75 | 0 | L12 | not found |  |  | lcd_data_o[2] | err
17 | 76 | 0 | N14 | 18 | N14 | 0 | enc_7_i[0] | match
18 | 77 | 0 | P15 | 4 | P15 | 0 | lcd_data_o[3] | match
19 | 80 | 0 | L14 | 23 | L14 | 0 | enc_5_i[0] | match
20 | 83 | 0 | J11 | not found |  |  | lcd_data_o[1] | err
21 | 84 | 0 | K16 | 20 | K16 | 0 | enc_3_i[0] | match
22 | 85 | 0 | K15 | 25 | K15 | 0 | lcd_e_o | match
23 | GND | not found |  | not found |  |  | GND | match
24 | 5V | not found |  | not found |  |  | 5V | match
25 | 86 | DEV_OE | J16 | 22 | J16 | 0 | enc_1_i[0] | match
26 | 87 | DEV_CLRn | J15 | 21 | J15 | 0 | lcd_rs_o | match
27 | 98 | INIT_DONE | G16 | 36 | G16 | 0 | enc_1_i[1] | match
28 | 99 | CRC_ERROR | G15 | 27 | G15 | 0 | lcd_pwm_o/gpio_o[1] | match
29 | 100 | 0 | F13 | 38 | F13 | 0 | pb_i[1] | match
30 | 101 | nCEO | F16 | 26 | F16 | 0 | mute_led_o/gpio_o[0] | match
31 | 103 | CLKUSR | F15 | 28 | F15 | 0 | enc_3_i[1] | match
32 | 104 | 0 | B16 | 34 | B16 | 0 | gpio_o[2] | match
33 | 105 | 0 | F14 | 39 | F14 | 0 | pb_i[3] | match
34 | 106 | 0 | C16 | 32 | C16 | 0 | tuner_scl_o | match
35 | 110 | 0 | D12 | not found |  |  | enc_5_i[1] | err
36 | 111 | 0 | B13 | not found |  |  | tuner_le_o | err
37 | 112 | 0 | A14 | not found |  |  | pb_i[5] | err
38 | 113 | 0 | B14 | not found |  |  | tuner_oe_o | err
39 | 114 | 0 | E11 | 41 | E11 | 0 | enc_7_i[1] | match
40 | 115 | 0 | E10 | not found |  |  | tuner_sda_o | err
41 | 119 | 0 | C11 | not found |  |  | pb_i[7] | err
42 | 120 | 0 | F10 | not found |  |  | uart_rx_i | err
43 | 121 | 0 | F9 | 40 | F9 | 0 | pb_acal_i/gpio_i[1] | match
44 | 124 | 0 | D9 | 46 | D9 | 0 | uart_tx_o | match
Waveshare Right | E144 | Altera Comment | FBGA Equiv | AC608 | FBGA | Xiaomege Comment | D-Lev Function
1 | GND | not found |  | not found |  |  | 3V3 | match
2 | 3V3 | not found |  | not found |  |  | GND | match
3 | 55 | 0 | T9 | 115 | T9 | INPUT ONLY | NC | match
4 | 58 | 0 | R10 | 116 | R10 | 0 | NC | match
5 | 53 | 0 | T8 | 113 | T8 | INPUT ONLY | NC | match
6 | 54 | 0 | R9 | 114 | R9 | INPUT ONLY | NC | match
7 | 51 | 0 | N8 | 81 | N8 | 0 | NC | match
8 | 52 | 0 | R8 | 112 | R8 | INPUT ONLY | volume_zero_i | match
9 | 49 | 0 | L8 | 82 | L8 | 0 | NC | match
10 | 50 | 0 | M8 | 77 | M8 | 0 | volume_sq_o | match
11 | 44 | 0 | T4 | 103 | T4 | 0 | NC | match
12 | 46 | 0 | P6 | 75 | P6 | 0 | volume_quad_i | match
13 | 42 | 0 | T2 | 99 | T2 | 0 | NC | match
14 | 43 | 0 | R4 | 102 | R4 | 0 | pb_i[6] | match
15 | 38 | 0 | N3 | 68 | N3 | 0 | NC | match
16 | 39 | 0 | P3 | 70 | P3 | 0 | enc_6_i[1] | match
17 | 33 | 0 | L4 | 66 | L4 | 0 | NC | match
18 | 34 | 0 | 0 | not found |  |  | pb_i[4] | match
19 | 31 | 0 | L3 | not found |  |  | midi_tx_n_o | err
20 | 32 | 0 | K5 | 65 | K5 | 0 | enc_4_i[1] | match
21 | 28 | 0 | L6 | not found |  |  | gpio_o[3] | err
22 | 30 | 0 | L2 | 91 | L2 | LVDS_TX3_P | pb_i[2] | match
23 | 5V | not found |  | not found |  |  | 5V | match
24 | GND | not found |  | not found |  |  | GND | match
25 | 10 | 0 | G2 | 58 | G2 | 0 | NC | match
26 | 11 | 0 | G1 | 59 | G1 | 0 | NC | match
27 | 3 | 0 | F5 | not found |  |  | NC | err
28 | 7 | 0 | F3 | 54 | F3 | 0 | NC | match
29 | 1 | 0 | D4 | not found |  |  | spi_scl_o | err
30 | 2 | 0 | E5 | not found |  |  | enc_2_i[1] | err
31 | 143 | 0 | C3 | not found |  |  | spi_sdi_o | err
32 | 144 | 0 | D3 | not found |  |  | pb_i[0] | err
33 | 141 | 0 | B5 | not found |  |  | spi_sdo_i | err
34 | 142 | 0 | B3 | not found |  |  | enc_0_i[1] | err
35 | 137 | DATA5 | E7 | not found |  |  | spi_scs_o | err
36 | 138 | DATA6 | E6 | not found |  |  | enc_0_i[0] | err
37 | 135 | 0 | F6 | not found |  |  | gpio_i[3] | err
38 | 136 | 0 | C6 | not found |  |  | enc_2_i[0] | err
39 | 132 | DATA2 | E8 | not found |  |  | gpio_i[2] | err
40 | 133 | DATA3 | F8 | 37 | F8 | 0 | enc_4_i[0] | match
41 | 128 | 0 | A8 | 45 | A8 | INPUT ONLY | spdif_tx_o[0] | match
42 | 129 | 0 | B8 | 47 | B8 | INPUT ONLY | enc_6_i[0] | match
43 | 126 | 0 | A9 | 42 | A9 | INPUT ONLY | spdif_tx_o[1] | match
44 | 127 | 0 | B9 | 43 | B9 | INPUT ONLY | pb_mute_i/gpio_i[0] | match

Sheet: AC608 safe GPIO
AC608_MB3 Headers | Altera Comments
 |  |  | VREFB Group |  | Pin Name / Function |  |  | Optional Function(s) |  | Configuration Function | PIN |  | E144 (4) | DQS for X8/X9 in F256/U256
M10 | 0 | 0 | VREFB4N0 | 0 | IO | 0 | 0 | RUP2 | 0 | 0 | M10 | 0 | 66
N9 | 0 | 0 | VREFB4N0 | 0 | IO | 0 | 0 | DIFFIO_B14n | 0 | 0 | N9 | 0 | 0
N8 | 0 | 0 | VREFB3N0 | 0 | IO | 0 | 0 | DIFFIO_B10p | 0 | 0 | N8 | 0 | 51
M8 | 0 | 0 | VREFB3N0 | 0 | IO | 0 | 0 | DIFFIO_B9n | 0 | 0 | M8 | 0 | 50
P6 | 0 | 0 | VREFB3N0 | 0 | IO | 0 | 0 | VREFB3N0 | 0 | 0 | P6 | 0 | 46
 | 0 | 0 | VREFB2N0 | 0 | IO | 0 | 0 | 0 | 0 | 0 | 0 | 0 | 34
L7 | 0 | 0 | VREFB3N0 | 0 | IO | 0 | 0 | 0 | 0 | 0 | L7 | 0 | 0
N5 | 0 | 0 | VREFB3N0 | 0 | IO | 0 | 0 | DIFFIO_B4p | 0 | 0 | N5 | 0 | 0
M6 | 0 | 0 | VREFB3N0 | 0 | IO | 0 | 0 | 0 | 0 | 0 | M6 | 0 | 0
K5 | 0 | 0 | VREFB2N0 | 0 | IO | 0 | 0 | RUP1 | 0 | 0 | K5 | 0 | 32
G2 | 0 | 0 | VREFB1N0 | 0 | IO | 0 | 0 | DIFFIO_L4p | 0 | 0 | G2 | 0 | 10
F1 | 0 | 0 | VREFB1N0 | 0 | IO | 0 | 0 | DIFFIO_L3n | 0 | 0 | F1 | 0 | 0
F3 | 0 | 0 | VREFB1N0 | 0 | IO | 0 | 0 | VREFB1N0 | 0 | 0 | F3 | 0 | 7
C2 | 0 | 0 | VREFB1N0 | 0 | IO | 0 | 0 | DIFFIO_L1p | 0 | 0 | C2 | 0 | 0
 | 0 | 0 | VREFB2N0 | 0 | IO | 0 | 0 | 0 | 0 | 0 | 0 | 0 | 34
D9 | 0 | 0 | VREFB7N0 | 0 | IO | 0 | 0 | DIFFIO_T13p | 0 | 0 | D9 | 0 | 124
E11 | 0 | 0 | VREFB7N0 | 0 | IO | 0 | 0 | RUP4 | 0 | 0 | E11 | 0 | 114
F14 | 0 | 0 | VREFB6N0 | 0 | IO | 0 | 0 | VREFB6N0 | 0 | 0 | F14 | 0 | 105
F8 | 0 | 0 | VREFB8N0 | 0 | IO | 0 | 0 | DIFFIO_T10p | 0 | DATA3 | F8 | 0 | 133
J13 | 0 | 0 | VREFB5N0 | 0 | IO | 0 | 0 | 0 | 0 | 0 | J13 | 0 | 0
 | 0 | 0 | VREFB2N0 | 0 | IO | 0 | 0 | 0 | 0 | 0 | 0 | 0 | 34
 | 0 | 0 | VREFB2N0 | 0 | IO | 0 | 0 | 0 | 0 | 0 | 0 | 0 | 34
C15 | 0 | 0 | VREFB6N0 | 0 | IO | 0 | 0 | DIFFIO_R1p | 0 | 0 | C15 | 0 | 0
D15 | 0 | 0 | VREFB6N0 | 0 | IO | 0 | 0 | DIFFIO_R2p | 0 | 0 | D15 | 0 | 0
F15 | 0 | 0 | VREFB6N0 | 0 | IO | 0 | 0 | DIFFIO_R3p | 0 | CLKUSR | F15 | 0 | 103
F16 | 0 | 0 | VREFB6N0 | 0 | IO | 0 | 0 | DIFFIO_R3n | 0 | nCEO | F16 | 0 | 101
J14 | 0 | 0 | VREFB5N0 | 0 | IO | 0 | 0 | DIFFIO_R6n | 0 | 0 | J14 | 0 | 0
 | 0 | 0 | VREFB2N0 | 0 | IO | 0 | 0 | 0 | 0 | 0 | 0 | 0 | 34
J16 | 0 | 0 | VREFB5N0 | 0 | IO | 0 | 0 | DIFFIO_R7n | 0 | DEV_OE | J16 | 0 | 86
K16 | 0 | 0 | VREFB5N0 | 0 | IO | 0 | 0 | DIFFIO_R8n | 0 | 0 | K16 | 0 | 84
N14 | 0 | 0 | VREFB5N0 | 0 | IO | 0 | 0 | RUP3 | 0 | 0 | N14 | 0 | 76
N12 | 0 | 0 | VREFB4N0 | 0 | IO | 0 | 0 | DIFFIO_B22n | 0 | 0 | N12 | 0 | 0
P11 | 0 | 0 | VREFB4N0 | 0 | IO | 0 | 0 | VREFB4N0 | 0 | 0 | P11 | 0 | 65
L15 | 0 | 0 | VREFB5N0 | 0 | IO | 0 | 0 | DIFFIO_R9p | 0 | 0 | L15 | 0 | 0
N15 | 0 | 0 | VREFB5N0 | 0 | IO | 0 | 0 | DIFFIO_R10p | 0 | 0 | N15 | 0 | 0
P15 | 0 | 0 | VREFB5N0 | 0 | IO | 0 | 0 | RDN3 | 0 | 0 | P15 | 0 | 77
 | 0 | 0 | VREFB2N0 | 0 | IO | 0 | 0 | 0 | 0 | 0 | 0 | 0 | 34
T15 | 0 | 0 | VREFB4N0 | 0 | IO | 0 | 0 | DIFFIO_B20n | 0 | 0 | T15 | 0 | 68
R14 | 0 | 0 | VREFB4N0 | 0 | IO | 0 | 0 | 0 | 0 | 0 | R14 | 0 | 69
R13 | 0 | 0 | VREFB4N0 | 0 | IO | 0 | 0 | DIFFIO_B19p | 0 | 0 | R13 | 0 | 0
R12 | 0 | 0 | VREFB4N0 | 0 | IO | 0 | 0 | DIFFIO_B17p | 0 | 0 | R12 | 0 | 0
R11 | 0 | 0 | VREFB4N0 | 0 | IO | 0 | 0 | DIFFIO_B16p | 0 | 0 | R11 | 0 | 59
 | 0 | 0 | VREFB2N0 | 0 | IO | 0 | 0 | 0 | 0 | 0 | 0 | 0 | 34
P9 | 0 | 0 | VREFB4N0 | 0 | IO | 0 | 0 | 0 | 0 | 0 | P9 | 0 | 64
L8 | 0 | 0 | VREFB3N0 | 0 | IO | 0 | 0 | DIFFIO_B9p | 0 | 0 | L8 | 0 | 49
P8 | 0 | 0 | VREFB3N0 | 0 | IO | 0 | 0 | DIFFIO_B10n | 0 | 0 | P8 | 0 | 0
M7 | 0 | 0 | VREFB3N0 | 0 | IO | 0 | 0 | DIFFIO_B5p | 0 | 0 | M7 | 0 | 0
N6 | 0 | 0 | VREFB3N0 | 0 | IO | 0 | 0 | DIFFIO_B4n | 0 | 0 | N6 | 0 | 0
 | 0 | 0 | VREFB2N0 | 0 | IO | 0 | 0 | 0 | 0 | 0 | 0 | 0 | 34
P3 | 0 | 0 | VREFB3N0 | 0 | IO | 0 | 0 | DIFFIO_B1n | 0 | 0 | P3 | 0 | 39
N3 | 0 | 0 | VREFB3N0 | 0 | IO | 0 | 0 | DIFFIO_B1p | 0 | 0 | N3 | 0 | 38
L4 | 0 | 0 | VREFB2N0 | 0 | IO | 0 | 0 | RDN1 | 0 | 0 | L4 | 0 | 33
G1 | 0 | 0 | VREFB1N0 | 0 | IO | 0 | 0 | DIFFIO_L4n | 0 | 0 | G1 | 0 | 11
G5 | 0 | 0 | VREFB1N0 | 0 | IO | 0 | 0 | 0 | 0 | 0 | G5 | 0 | 0
F2 | 0 | 0 | VREFB1N0 | 0 | IO | 0 | 0 | DIFFIO_L3p | 0 | 0 | F2 | 0 | 0
D1 | 0 | 0 | VREFB1N0 | 0 | IO | 0 | 0 | DIFFIO_L2n | 0 | 0 | D1 | 0 | 0
B1 | 0 | 0 | VREFB1N0 | 0 | IO | 0 | 0 | 0 | 0 | 0 | B1 | 0 | 0
 | 0 | 0 | VREFB2N0 | 0 | IO | 0 | 0 | 0 | 0 | 0 | 0 | 0 | 34
C9 | 0 | 0 | VREFB7N0 | 0 | IO | 0 | 0 | DIFFIO_T13n | 0 | 0 | C9 | 0 | 0
F9 | 0 | 0 | VREFB7N0 | 0 | IO | 0 | 0 | DIFFIO_T16p | 0 | 0 | F9 | 0 | 121
F13 | 0 | 0 | VREFB6N0 | 0 | IO | 0 | 0 | 0 | 0 | 0 | F13 | 0 | 100
G16 | 0 | 0 | VREFB6N0 | 0 | IO | 0 | 0 | DIFFIO_R4n | 0 | INIT_DONE | G16 | 0 | 98
B16 | 0 | 0 | VREFB6N0 | 0 | IO | 0 | 0 | 0 | 0 | 0 | B16 | 0 | 104
 | 0 | 0 | VREFB2N0 | 0 | IO | 0 | 0 | 0 | 0 | 0 | 0 | 0 | 34
 | 0 | 0 | VREFB2N0 | 0 | IO | 0 | 0 | 0 | 0 | 0 | 0 | 0 | 34
C16 | 0 | 0 | VREFB6N0 | 0 | IO | 0 | 0 | DIFFIO_R1n | 0 | 0 | C16 | 0 | 106
D16 | 0 | 0 | VREFB6N0 | 0 | IO | 0 | 0 | DIFFIO_R2n | 0 | 0 | D16 | 0 | 0
G15 | 0 | 0 | VREFB6N0 | 0 | IO | 0 | 0 | DIFFIO_R4p | 0 | CRC_ERROR | G15 | 0 | 99
K15 | 0 | 0 | VREFB5N0 | 0 | IO | 0 | 0 | DIFFIO_R8p | 0 | 0 | K15 | 0 | 85
L14 | 0 | 0 | VREFB5N0 | 0 | IO | 0 | 0 | VREFB5N0 | 0 | 0 | L14 | 0 | 80
 | 0 | 0 | VREFB2N0 | 0 | IO | 0 | 0 | 0 | 0 | 0 | 0 | 0 | 34
J15 | 0 | 0 | VREFB5N0 | 0 | IO | 0 | 0 | DIFFIO_R7p | 0 | DEV_CLRn | J15 | 0 | 87
L13 | 0 | 0 | VREFB5N0 | 0 | IO | 0 | 0 | 0 | 0 | 0 | L13 | 0 | 0
P14 | 0 | 0 | VREFB4N0 | 0 | IO | 0 | 0 | DIFFIO_B21p | 0 | 0 | P14 | 0 | 70
N11 | 0 | 0 | VREFB4N0 | 0 | IO | 0 | 0 | RDN2 | 0 | 0 | N11 | 0 | 67
L16 | 0 | 0 | VREFB5N0 | 0 | IO | 0 | 0 | DIFFIO_R9n | 0 | 0 | L16 | 0 | 0
N16 | 0 | 0 | VREFB5N0 | 0 | IO | 0 | 0 | DIFFIO_R10n | 0 | 0 | N16 | 0 | 0
P16 | 0 | 0 | VREFB5N0 | 0 | IO | 0 | 0 | DIFFIO_R11n | 0 | 0 | P16 | 0 | 0
R16 | 0 | 0 | VREFB5N0 | 0 | IO | 0 | 0 | DIFFIO_R11p | 0 | 0 | R16 | 0 | 0
 | 0 | 0 | VREFB2N0 | 0 | IO | 0 | 0 | 0 | 0 | 0 | 0 | 0 | 34
T14 | 0 | 0 | VREFB4N0 | 0 | IO | 0 | 0 | DIFFIO_B20p | 0 | 0 | T14 | 0 | 0
T13 | 0 | 0 | VREFB4N0 | 0 | IO | 0 | 0 | DIFFIO_B19n | 0 | 0 | T13 | 0 | 0
T12 | 0 | 0 | VREFB4N0 | 0 | IO | 0 | 0 | DIFFIO_B17n | 0 | 0 | T12 | 0 | 0
T11 | 0 | 0 | VREFB4N0 | 0 | IO | 0 | 0 | DIFFIO_B16n | 0 | 0 | T11 | 0 | 60
T10 | 0 | 0 | VREFB4N0 | 0 | IO | 0 | 0 | DIFFIO_B15n | 0 | 0 | T10 | 0 | 0
