wormyrocks/d-lev-mini/cad/standoff_m3x5.stp

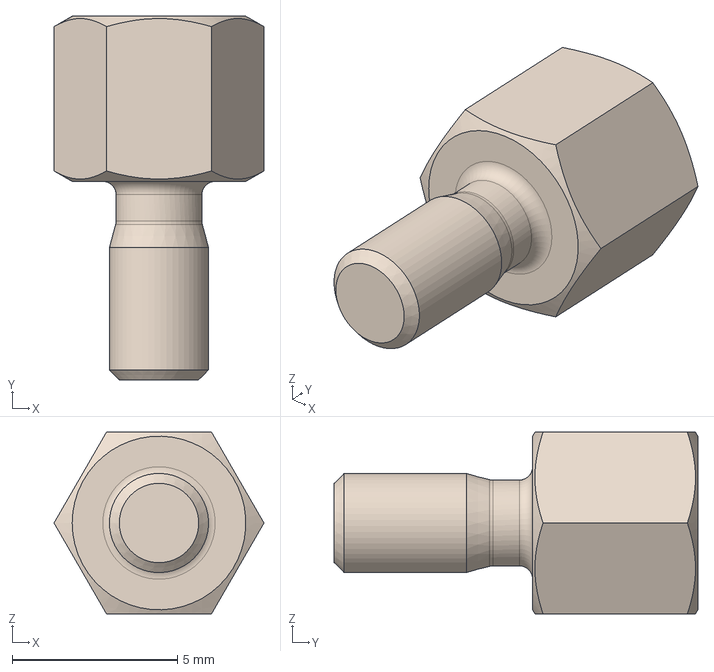
[picture p4: CAD file, 2023-06-12]
cad/standoff_m3x5.stp
6.35 x 11.0 x 5.50 mm
