wormyrocks/d-lev-mini/cad/standoff_m3x4.stp

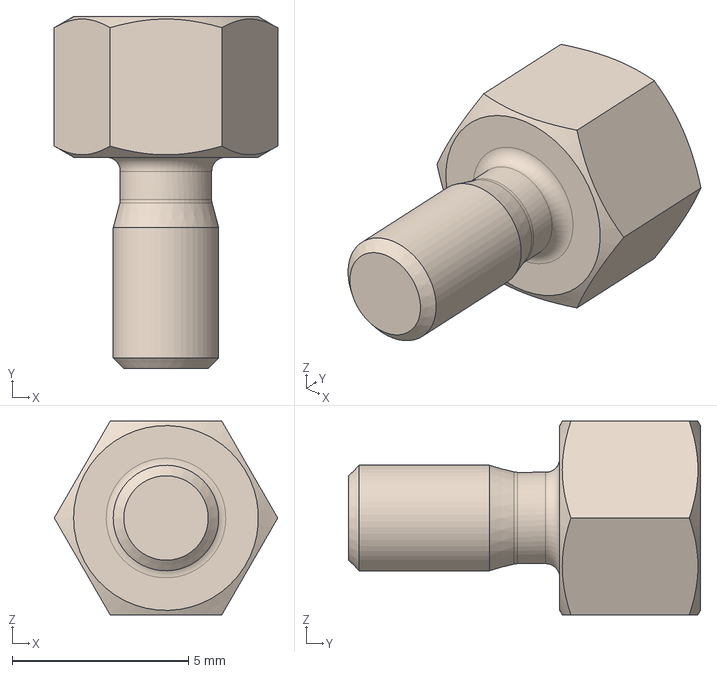
[picture p5: CAD file, 2023-06-12]
cad/standoff_m3x4.stp
6.35 x 10.0 x 5.50 mm
