wormyrocks/d-lev-mini/cad/standoff_m3x10.stp

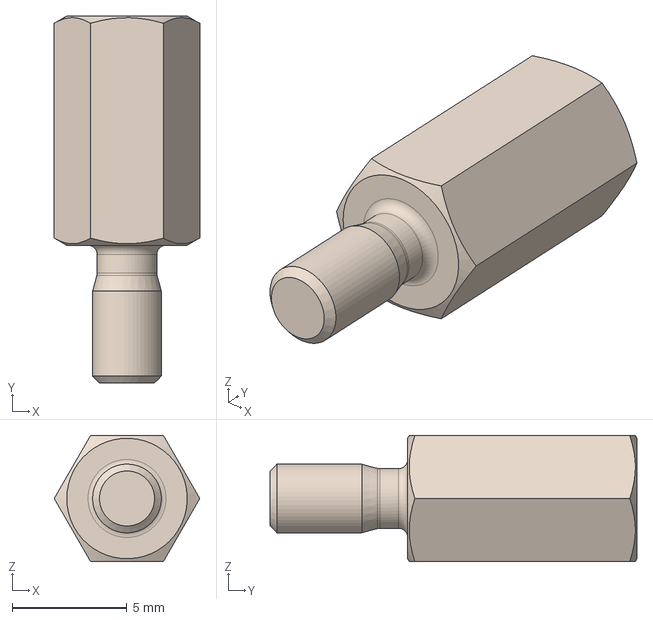
[picture p6: CAD file, 2023-06-12]
cad/standoff_m3x10.stp
6.35 x 16.0 x 5.50 mm
