wormyrocks/d-lev-mini/cad/knob.step

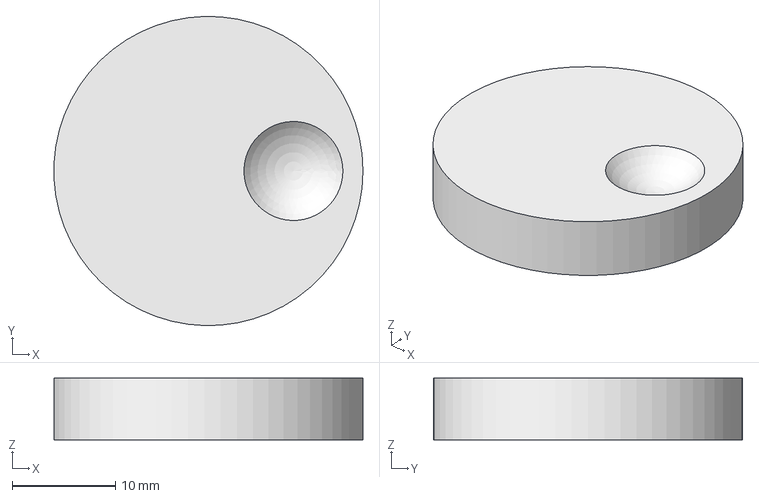
[picture p7: CAD file, 2023-06-12]
cad/knob.step
30.0 x 30.0 x 6.00 mm
