wormyrocks/d-lev-mini/cad/standoff_m3x6.stp

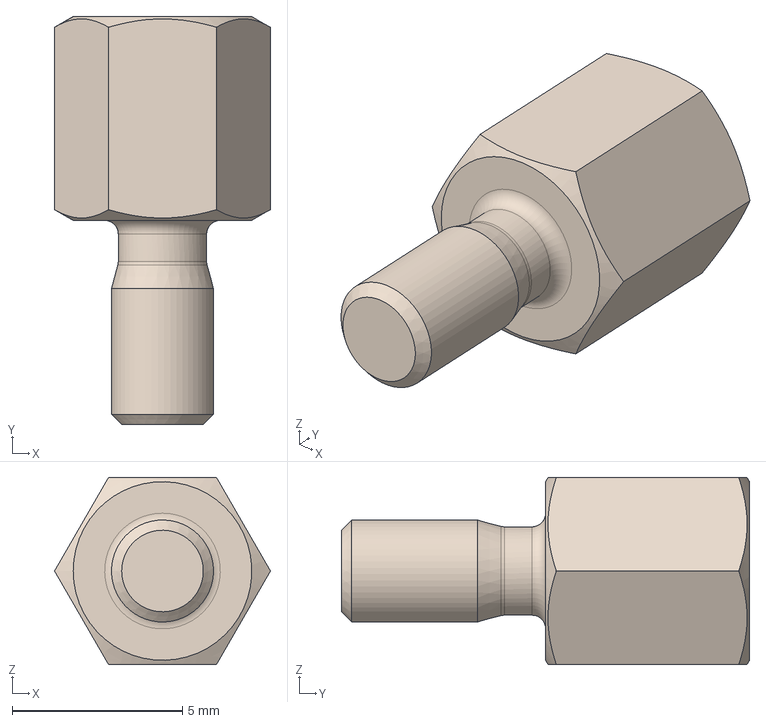
[picture p8: CAD file, 2023-06-12]
cad/standoff_m3x6.stp
6.35 x 12.0 x 5.50 mm
