wormyrocks/d-lev-mini/cad/standoff_m3x8.stp

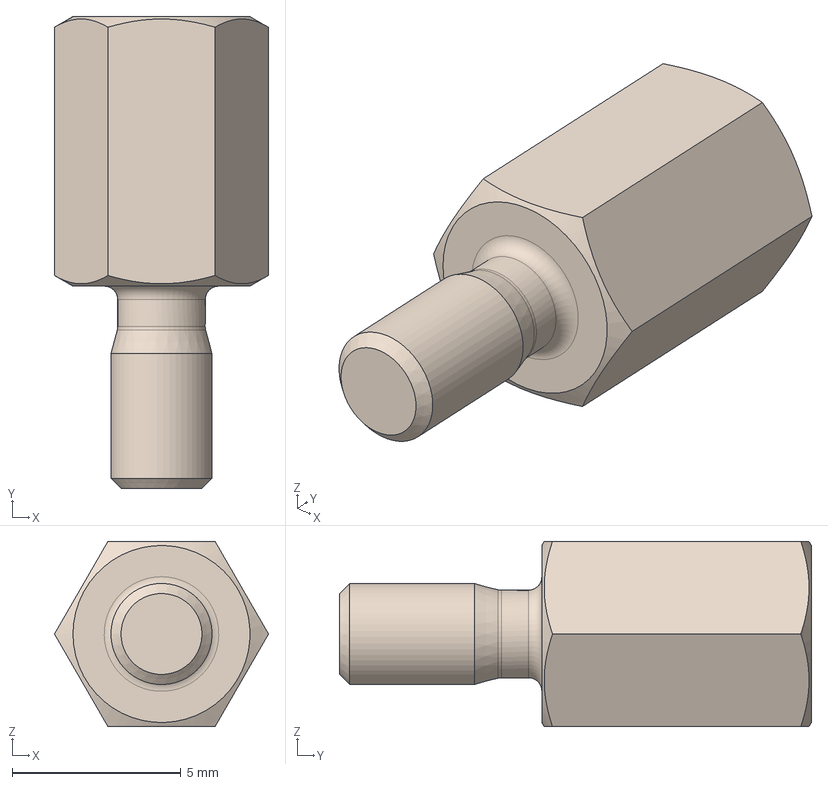
[picture p9: CAD file, 2023-06-12]
cad/standoff_m3x8.stp
6.35 x 14.0 x 5.50 mm
