wormyrocks/d-lev-mini/cad/standoff_m3x7.stp

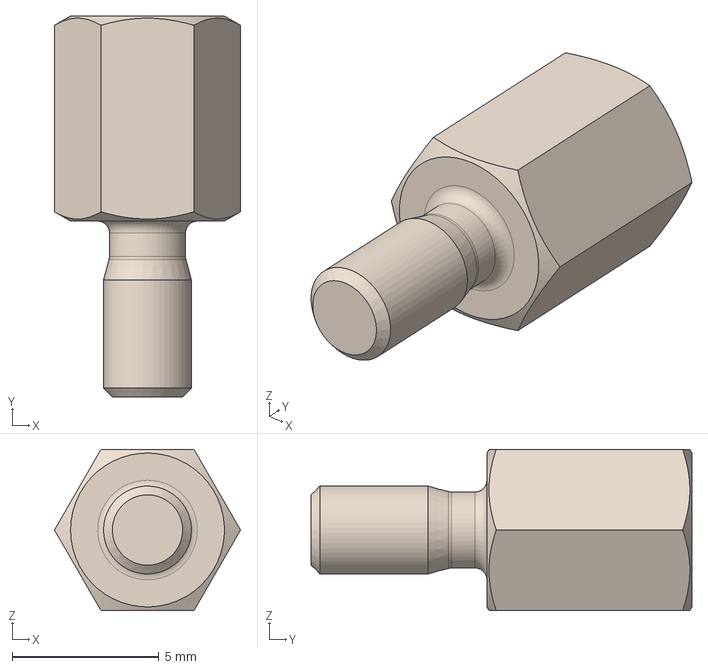
[picture p10: CAD file, 2023-06-12]
cad/standoff_m3x7.stp
6.35 x 13.0 x 5.50 mm
