wormyrocks/d-lev-mini/d-lev-tuner/lightguides.md

https://hackaday.com/2023/03/13/a-hackers-introduction-to-diy-light-guide-plates/#more-578474
https://hackaday.io/page/6081-using-side-view-leds-in-place-of-reverse-mount-leds
https://hackaday.io/project/162980-you-are-here
