wormyrocks/d-lev-mini/d-lev-io/datasheet/2023-03-24 14_20_47-TPS54202H 4.5-V to 28-V Input, 2-A Output, SWIFT™ Synchronous Step Down Voltage .png

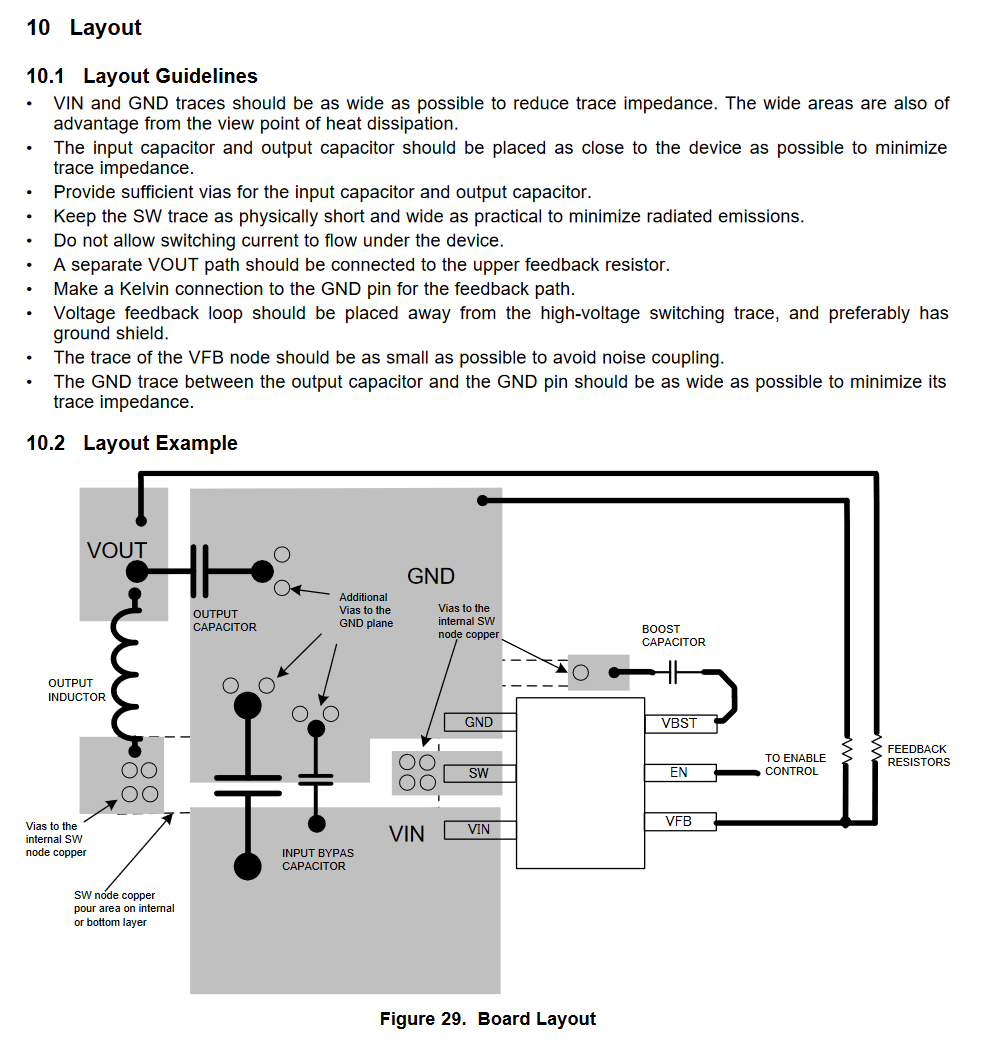
d-lev-io/datasheet/2023-03-24 14_20_47-TPS54202H 4.5-V to 28-V Input, 2-A Output, SWIFT™ Synchronous Step Down Voltage .png
