wormyrocks/d-lev-mini/(list of files, drawings)

Other design files:
d-lev-main/datasheet/4868-9016K2M/PCB/ES90182M_REF3_3v0.dip
