wormyrocks/d-lev-mini/d-lev-afe/d-lev-afe.kicad_pcb

## KiCad design d-lev-afe/d-lev-afe.kicad_pcb (2023-10-17)

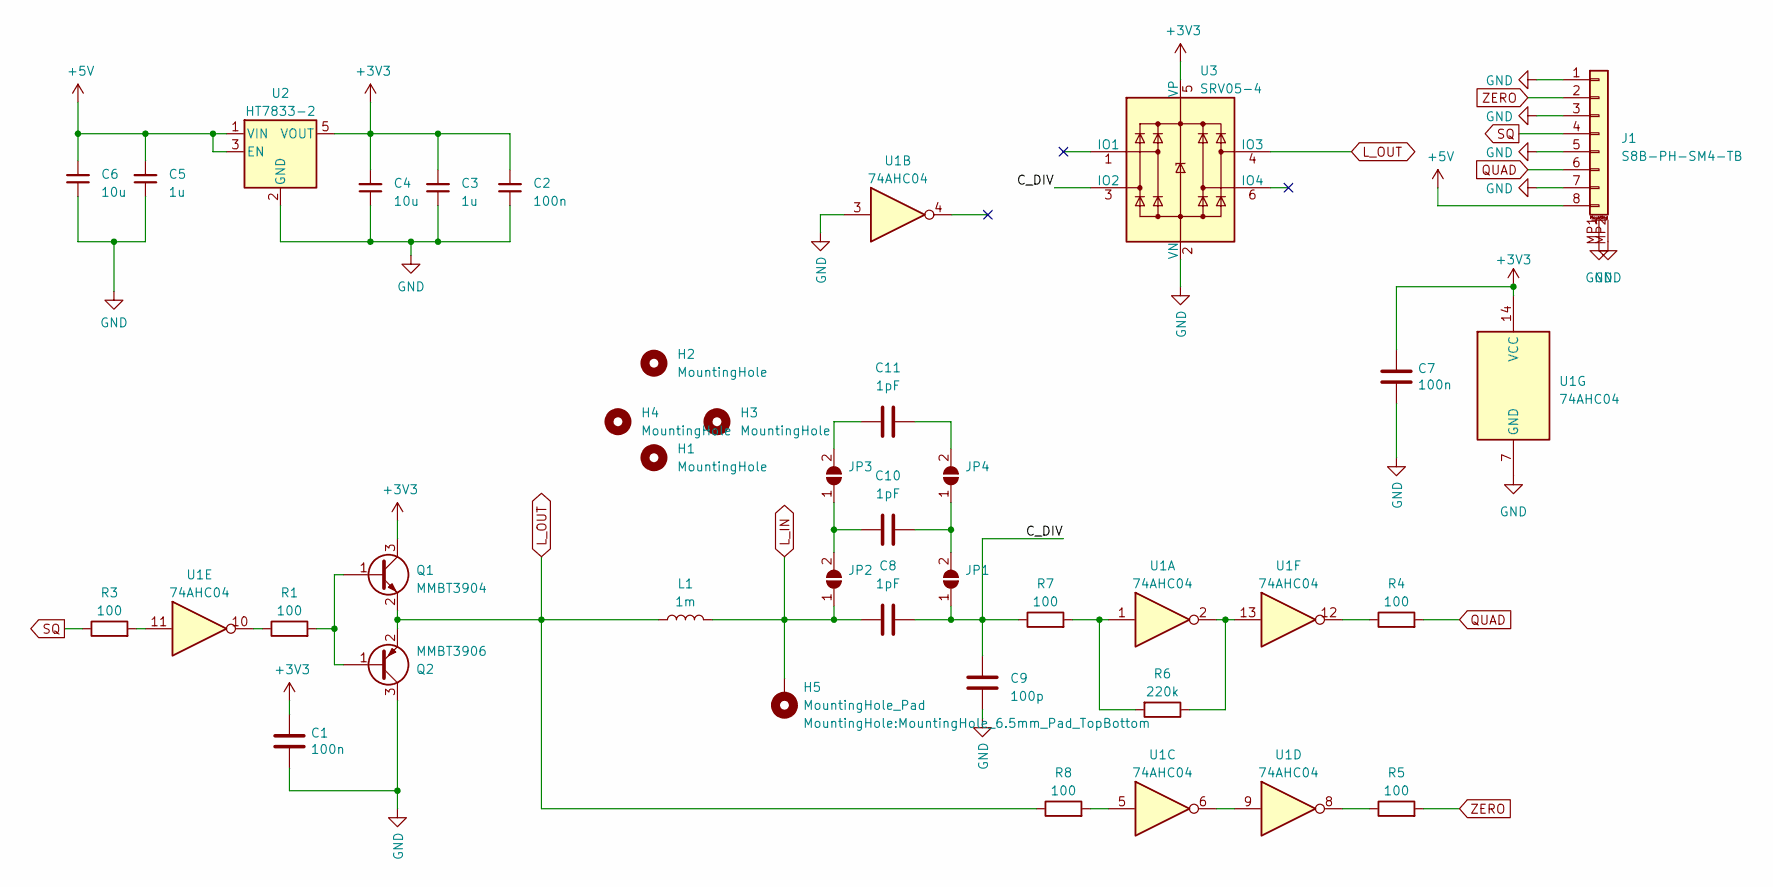
[picture p12: schematic d-lev-afe.kicad_sch]

Parts:
C1, C2, C7: 100n; C_0603_1608Metric; MPN GRM188R71E104KA01D; LCSC C14663
C3, C5: 1u; C_0603_1608Metric; LCSC C15849
C4, C6: 10u; C_0805_2012Metric; MPN CL21A106KAYNNNG; LCSC C440198
C8, C10, C11: 1pF; testpoint_cap_1pf
C9: 100p; C_0603_1608Metric; MPN C0603C101K8RACAUTO; LCSC C14858
H1, H2, H3, H4: MountingHole; MountingHole_3.2mm_M3
H5: MountingHole_Pad; MountingHole_6.5mm_Pad_TopBottom
J1: S8B-PH-SM4-TB; JST_PH_S8B-PH-SM4-TB_1x08-1MP_P2.00mm_Horizontal; MPN S8B-PH-SM4-TB; LCSC C265121
JP1, JP2, JP3, JP4: SolderJumper_2_Open; SolderJumper-0.5mm-Tiny
L1: 1m; LargeHoneycombCoil; Tolerance 10%; MPN 2ZFF4-252k-DM
Q1: MMBT3904; SOT-23; MPN MMBT3904-7-F; LCSC C20526
Q2: MMBT3906; SOT-23; MPN MMBT3906-7-F; LCSC C2143
R1, R3, R4, R5, R7, R8: 100; R_0603_1608Metric; LCSC C22775
R6: 220k; R_0603_1608Metric; MPN RC0603FR-13220KL; LCSC C22961
U1: 74AHC04; SOIC-14_3.9x8.7mm_P1.27mm; MPN SN74AHC04DRG4; LCSC C8131
U2: HT7833-2; SOT-23-5; MPN HT7833-2; LCSC C164106
U3: SRV05-4; SOT-23-6; MPN SRV05-4L-TP; LCSC C85364

Connections:
+3V3: C1.1, C2.2, C3.2, C4.2, C7.1, Q1.3 (C), U1.14 (VCC), U2.5 (VOUT), U3.5 (VP)
+5V: C5.2, C6.2, J1.8, U2.1 (VIN), U2.3 (EN)
/C_DIV: C8.1, C9.1, JP1.1 (A), R7.1, U3.3 (IO2)
GND: C1.2, C2.1, C3.1, C4.1, C5.1, C6.1, C7.2, C9.2, J1.1, J1.3, J1.5, J1.7, J1.MP1 (MountPin1), J1.MP2 (MountPin2), Q2.3 (C), U1.3, U1.7 (GND), U2.2 (GND), U3.2 (VN)
L_IN: C8.2, H5.1, JP2.1 (A), L1.2
L_OUT: L1.1, Q1.2 (E), Q2.2 (E), R8.1, U3.4 (IO3)
unnamed: C10.1, JP1.2 (B), JP4.1 (A)
unnamed: C10.2, JP2.2 (B), JP3.1 (A)
unnamed: C11.2, JP3.2 (B)
unnamed: C11.1, JP4.2 (B)
unnamed: Q1.1 (B), Q2.1 (B), R1.2
unnamed: R1.1, U1.10
unnamed: R3.2, U1.11
unnamed: R4.1, U1.12
unnamed: R5.1, U1.8
unnamed: R6.1, U1.2, U1.13
unnamed: R6.2, R7.2, U1.1
unnamed: R8.2, U1.5
unnamed: U1.6, U1.9
QUAD: J1.6, R4.2
SQ: J1.4, R3.1
ZERO: J1.2, R5.2

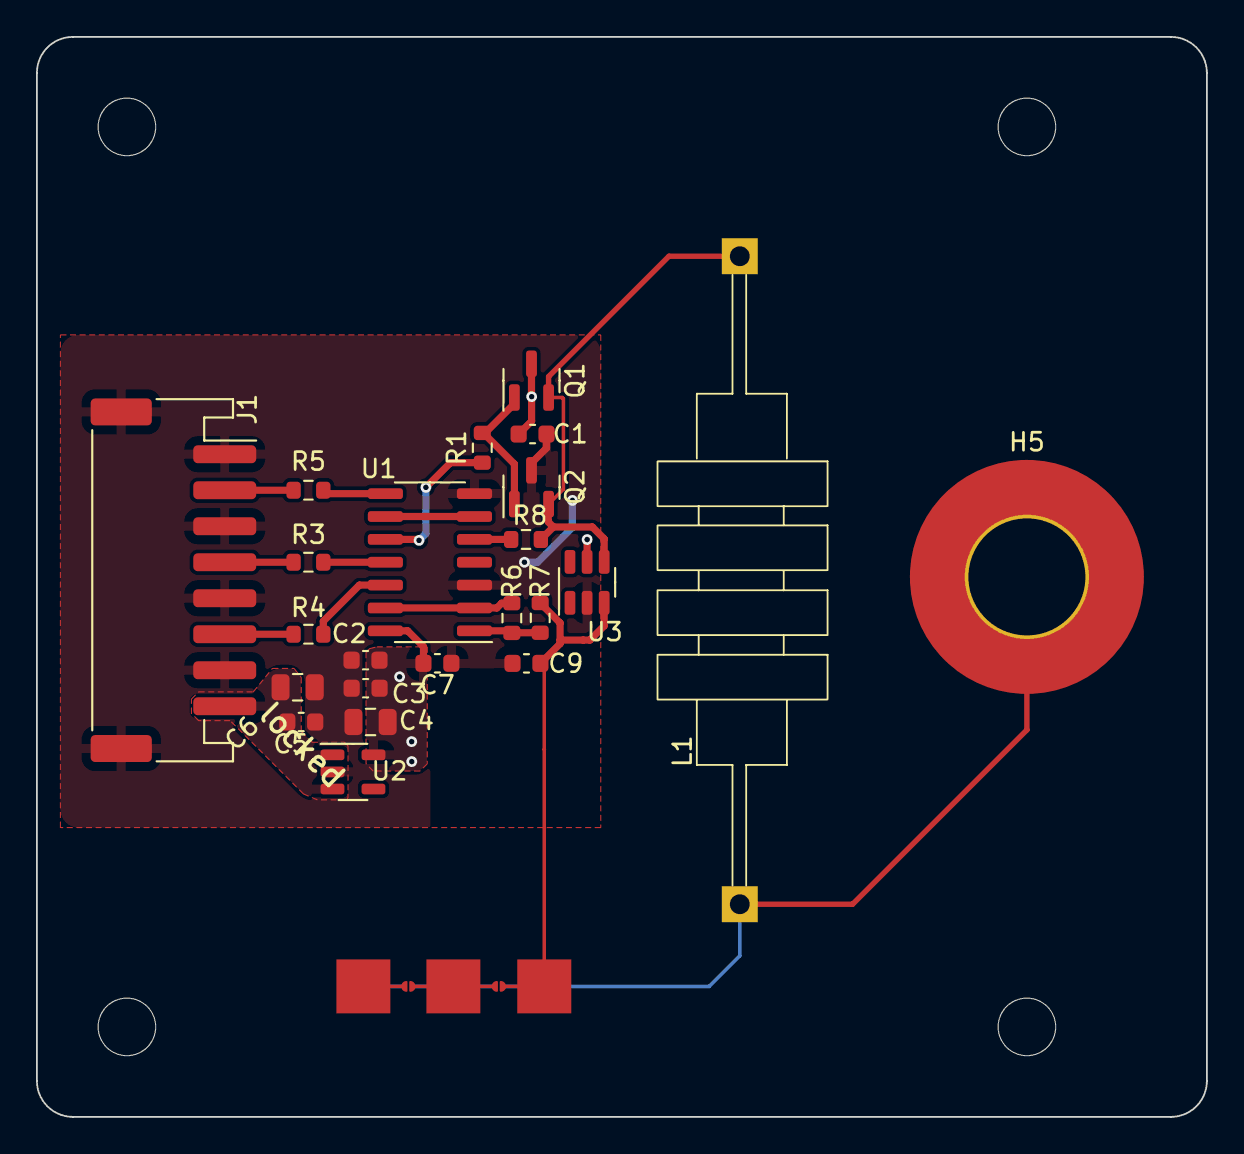
[picture p13: board d-lev-afe.kicad_pcb from above]

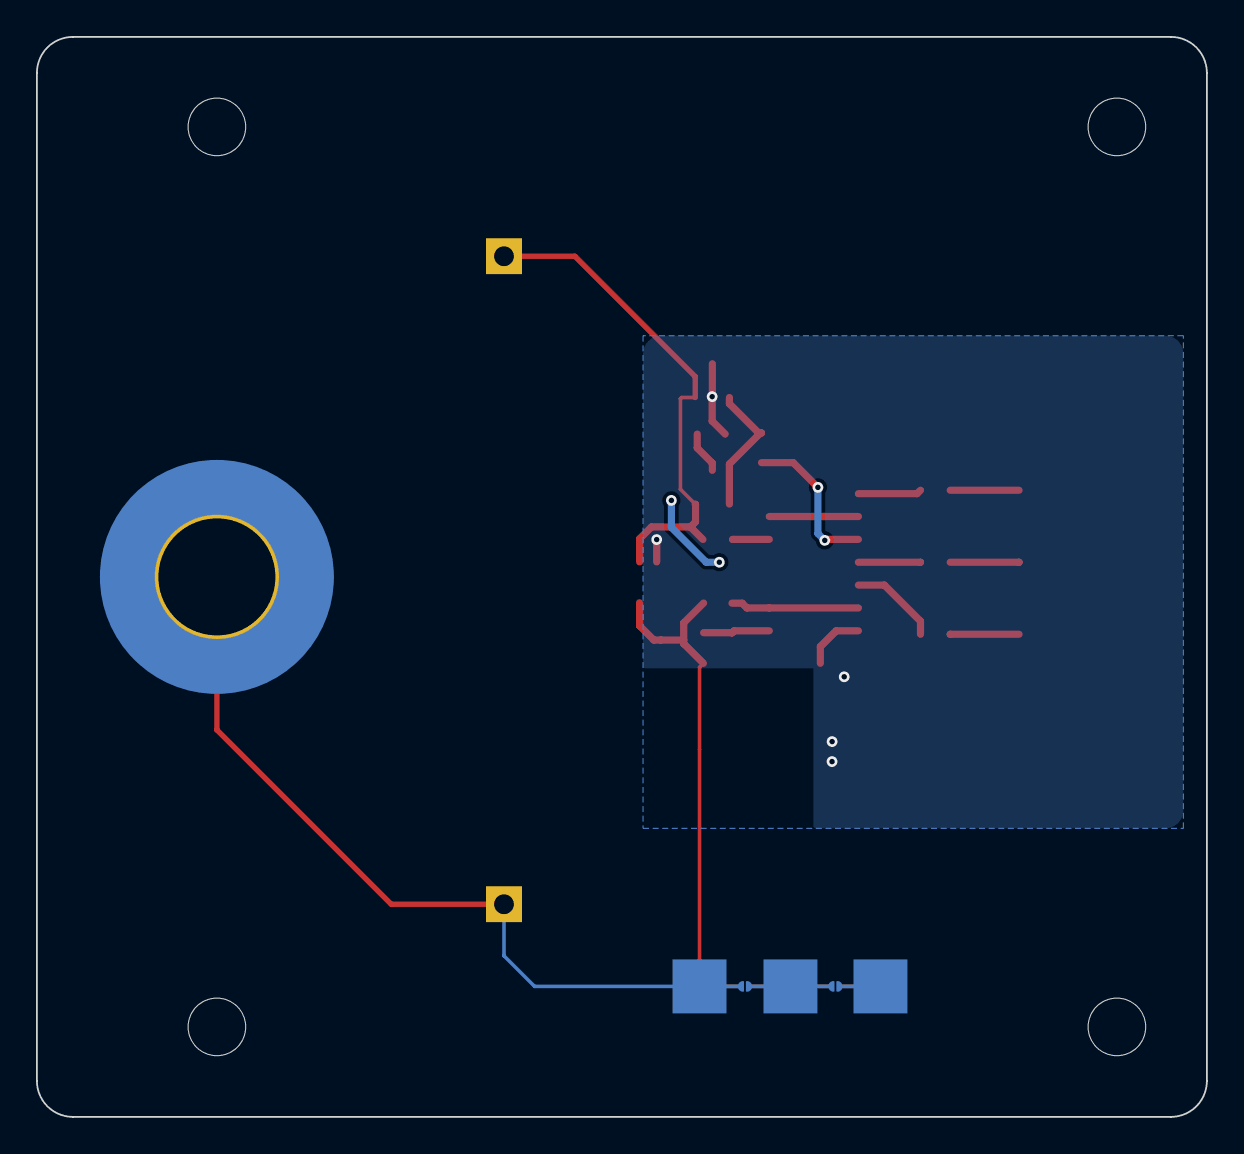
[picture p14: board d-lev-afe.kicad_pcb from below]

Board: 2 copper layers, 65.0 x 60.0 mm, 34 parts (2 on the bottom side), 22 nets.
