wormyrocks/d-lev-mini/d-lev-tuner/d-lev-tuner.kicad_pcb

## KiCad design d-lev-tuner/d-lev-tuner.kicad_pcb (2023-06-06)

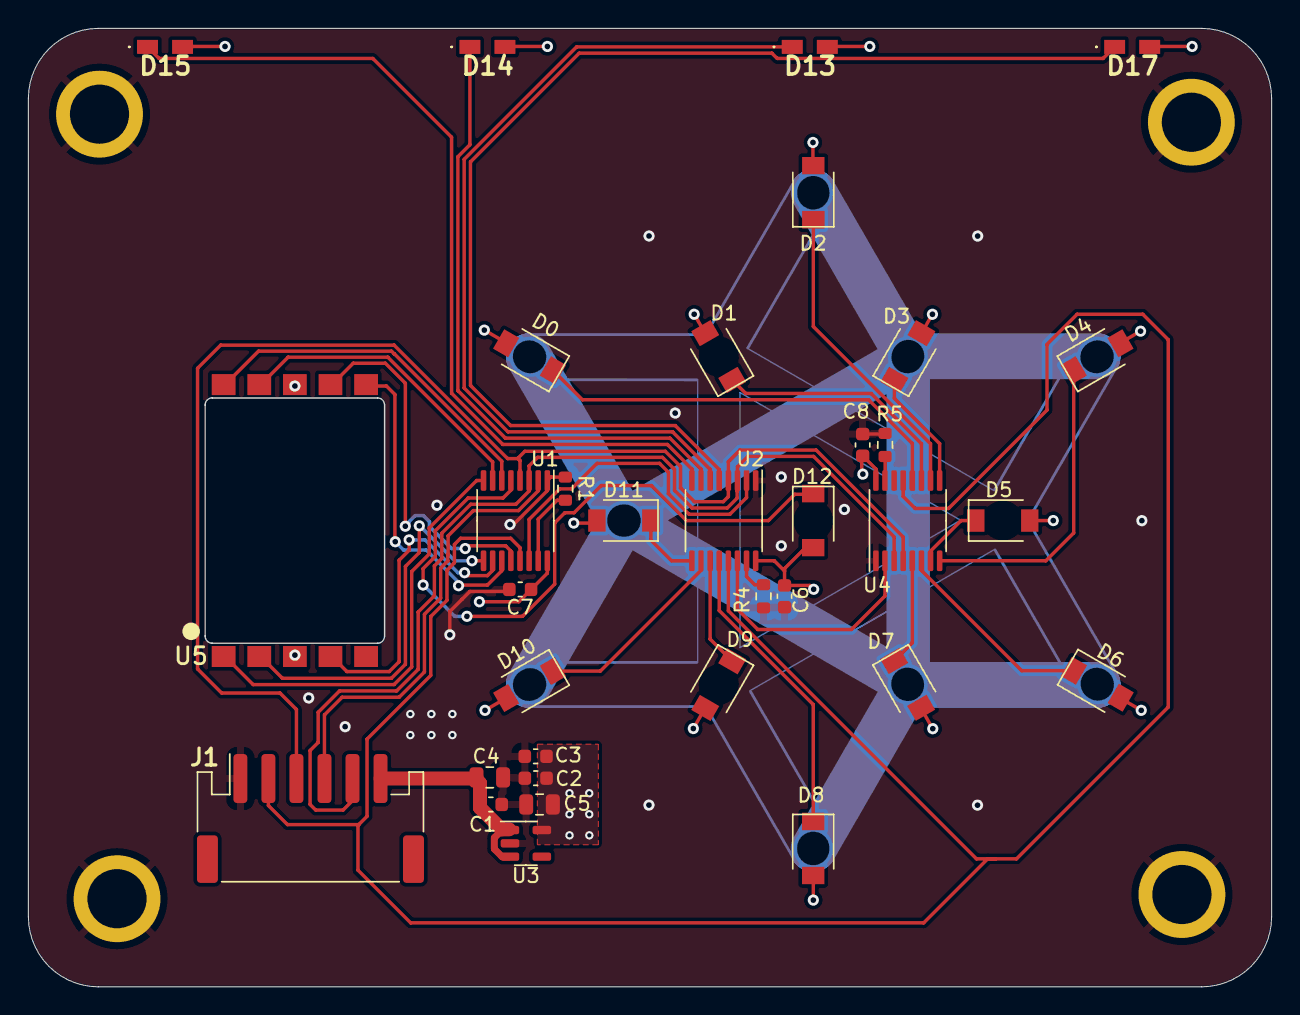
[picture p15: board d-lev-tuner.kicad_pcb from above]

Board: 4 copper layers, 88.7 x 68.4 mm, 38 parts (0 on the bottom side), 36 nets.

Parts:
C1, C3: 1u; C_0603_1608Metric
C2, C6, C7, C8: 100n; C_0603_1608Metric
C4, C5: 10u; C_0805_2012Metric
D0, D1, D2, D3, D4, D5, D6, D7, D8, D9, D10, D11, D12: LTST-C250TBKT; LED_1206_3216Metric_ReverseMount_Hole1.8x2.4mm
D13, D14, D15, D17: LTST-S220TBKT; S220TBKT
H1, H2, H3, H4: SMTSO-M3-2ET; SMTSO-M3
J1: S6B-PH-SM4-TB; JST_PH_S6B-PH-SM4-TB_1x06-1MP_P2.00mm_Horizontal
R1, R4, R5: 4.7k; R_0603_1608Metric
U1, U2, U4: STP08CP05; TSSOP-16_4.4x5mm_P0.65mm
U3: AP2112K-3.3; SOT-23-5
U5: DSM7TA56

Connections:
+3V3: C2.2, C3.2, C5.2, C6.1, C7.1, C8.1, D0.2 (A), D1.2 (A), D2.2 (A), D3.2 (A), D4.2 (A), D5.2 (A), D6.2 (A), D7.2 (A), D8.2 (A), D9.2 (A), D10.2 (A), D11.2 (A), D12.2 (A), D13.2 (A), D14.2 (A), D15.2 (A), D17.2 (A), U1.16 (VDD), U2.16 (VDD), U3.5 (VOUT), U4.16 (VDD), U5.3 (C.A.), U5.8 (C.A.)
+5V: C1.2, C4.2, J1.6, U3.1 (VIN), U3.3 (EN)
/Net-(U3-SDI): U1.14 (SDO), U2.2 (SDI)
A: U1.12 (OUT7), U5.7 (a)
B: U1.11 (OUT6), U5.6 (b)
C: U1.10 (OUT5), U5.4 (c)
CLK: J1.5, U1.3 (CLK), U2.3 (CLK), U4.3 (CLK)
D: U1.9 (OUT4), U5.2 (d)
E: U1.8 (OUT3), U5.1 (e)
F: U1.7 (OUT2), U5.9 (f)
G: U1.6 (OUT1), U5.10 (g)
GND: C1.1, C2.1, C3.1, C4.1, C5.1, C6.2, C7.2, C8.2, H1.1, H2.1, H3.1, H4.1, J1.1, R1.2, R4.2, R5.2, U1.1 (GND), U2.1 (GND), U3.2 (GND), U4.1 (GND)
LE: J1.3, U1.4 (LE), U2.4 (LE), U4.4 (LE)
LED0: D0.1 (K), U4.12 (OUT7)
LED1: D1.1 (K), U4.11 (OUT6)
LED2: D2.1 (K), U4.10 (OUT5)
LED3: D3.1 (K), U4.9 (OUT4)
LED4: D4.1 (K), U4.8 (OUT3)
LED5: D5.1 (K), U4.7 (OUT2)
LED6: D6.1 (K), U4.6 (OUT1)
LED7: D7.1 (K), U4.5 (OUT0)
LED8: D8.1 (K), U2.12 (OUT7)
LED9: D9.1 (K), U2.11 (OUT6)
LED10: D10.1 (K), U2.10 (OUT5)
LED11: D11.1 (K), U2.9 (OUT4)
LED12: D12.1 (K), U1.5 (OUT0)
LED13: D17.1 (K), U2.5 (OUT0)
LED14: D13.1 (K), U2.6 (OUT1)
LED15: D14.1 (K), U2.7 (OUT2)
LED16: D15.1 (K), U2.8 (OUT3)
unnamed: R1.1, U1.15 (R-EXT)
unnamed: R4.1, U2.15 (R-EXT)
unnamed: U2.14 (SDO), U4.2 (SDI)
unnamed: R5.1, U4.15 (R-EXT)
OE: J1.2, U1.13 (~OE), U2.13 (~OE), U4.13 (~OE)
SDI: J1.4, U1.2 (SDI)
