wormyrocks/d-lev-mini/d-lev-io/d-lev-io.kicad_pcb

## KiCad design d-lev-io/d-lev-io.kicad_pcb (2023-05-04)

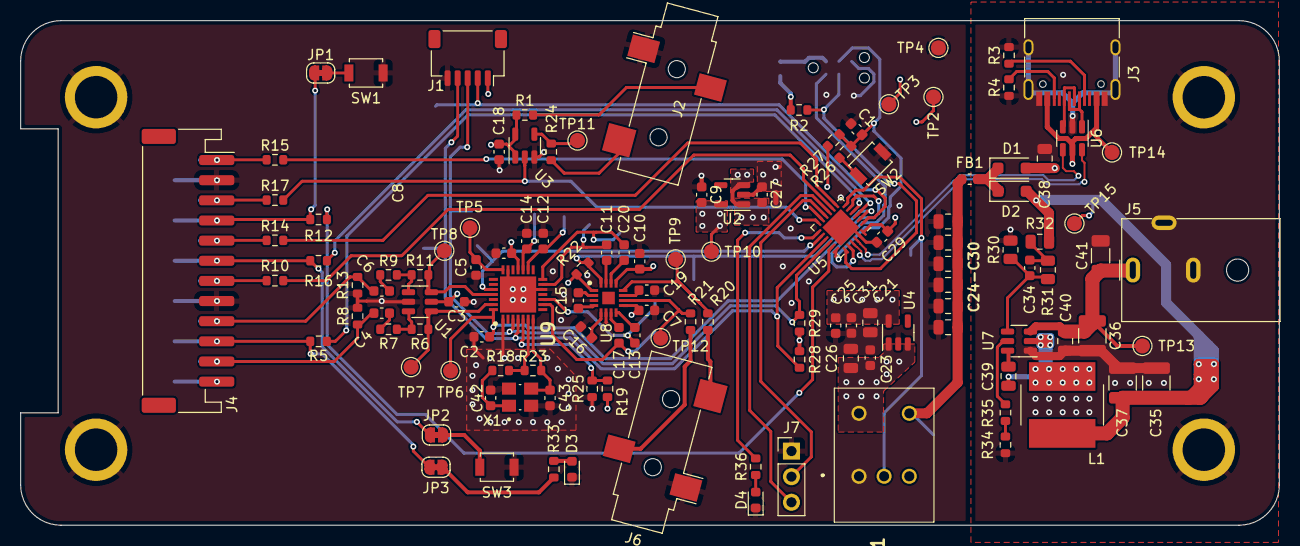
[picture p16: board d-lev-io.kicad_pcb from above]

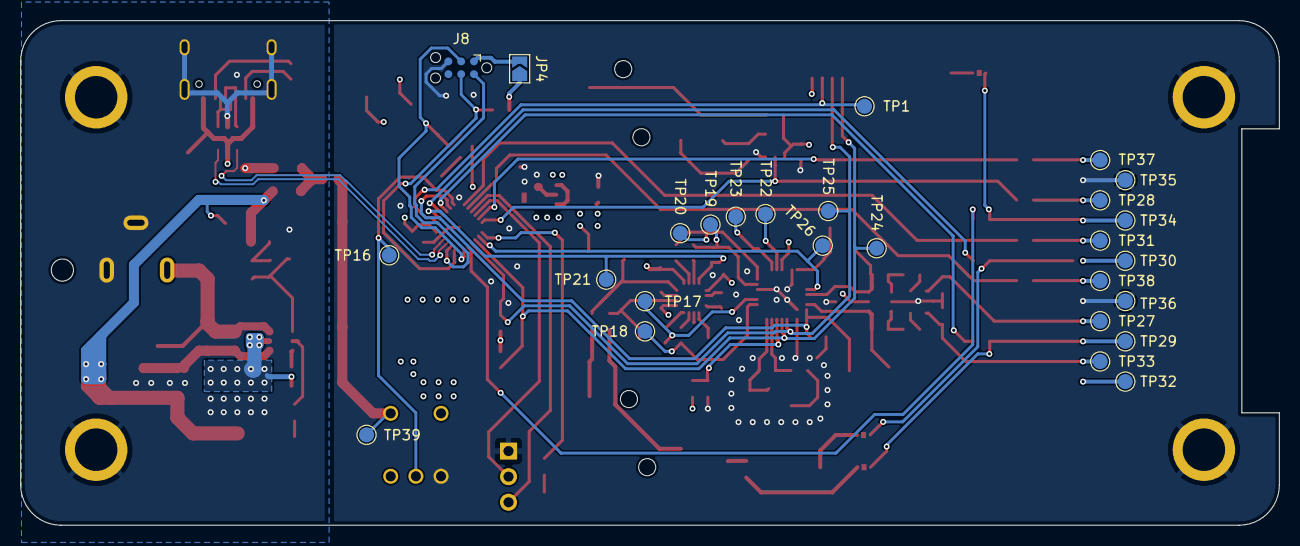
[picture p17: board d-lev-io.kicad_pcb from below]

Board: 4 copper layers, 125.0 x 50.1 mm, 155 parts (27 on the bottom side), 89 nets.

Parts:
C1, C21: .1u; C_0603_1608Metric
C2, C7, C8, C9, C10, C12, C14, C15, C16, C23, C27, C31: 1u; C_0603_1608Metric
C3, C18: 100n; C_0603_1608Metric
C4, C6: 4.7n; C_0603_1608Metric
C5, C29: 4.7u; C_0603_1608Metric
C11, C13, C17, C20: .47u; C_0603_1608Metric
C19: 0.1u; C_0603_1608Metric
C22, C24, C25, C26, C28, C30, C32, C33: 10u; C_0805_2012Metric
C34: 75p; C_0603_1608Metric
C35, C37: 22u; C_1210_3225Metric
C36: 10u; C_1210_3225Metric
C38: 0.1u; C_0805_2012Metric
C39, C40: .1u; C_0805_2012Metric
C41: 47u; C_1206_3216Metric
C42, C43: 33p; C_0603_1608Metric
D1, D2: SS34FA; D_SOD-123F
D3: LED; LED_0603_1608Metric
D4: STATUS; LED_0603_1608Metric
FB1: 50mohm DCR, 120R@100Mhz; L_0603_1608Metric
H1, H2, H3, H4: MountingHole_Pad; SMTSO-M3
J1: CV_HDR; JST_SH_SM05B-SRSS-TB_1x05-1MP_P1.00mm_Horizontal
J2: MIDI_OUT_JACK; Jack_3.5mm_CUI_SJ-3523-SMT_Horizontal
J3: USB_C_Receptacle_USB2.0; USB_C_Receptacle_HRO_TYPE-C-31-M-12
J4: Conn_01x12_MountingPin; JST_PH_S12B-PH-SM4-TB_1x12-1MP_P2.00mm_Horizontal
J5: PJ-059A; BarrelJack_CUI_PJ-059A
J6: HEADPHONE; Jack_3.5mm_CUI_SJ-3523-SMT_Horizontal
J7: TOUCH_HDR; PinHeader_1x03_P2.54mm_Vertical
J8: PROG_HDR; Tag-Connect_TC2030-IDC-NL_2x03_P1.27mm_Vertical
JP1: ACAL_JUMPER; SolderJumper-2_P1.3mm_Bridged_RoundedPad1.0x1.5mm
JP2: MUTE_JUMPER; SolderJumper-2_P1.3mm_Bridged_RoundedPad1.0x1.5mm
JP3: MUTE_LED_JUMPER; SolderJumper-2_P1.3mm_Bridged_RoundedPad1.0x1.5mm
JP4: PROG_VIN; SolderJumper-2_P1.3mm_Open_TrianglePad1.0x1.5mm
L1: 15u; L_Bourns_SRN8040TA
NT1: NetTie_2; NetTie-2_SMD_Pad0.5mm
R1, R7, R9, R24: 220; R_0603_1608Metric
R2, R33, R36: 1k; R_0603_1608Metric
R3, R4: 5.1k; R_0603_1608Metric
R5, R12, R15, R16, R25: 0; R_0603_1608Metric
R6, R11, R22: 100k; R_0603_1608Metric
R8, R13: 75; R_0603_1608Metric
R10, R14, R17: 100; R_0603_1608Metric
R18: 20; R_0603_1608Metric
R19: 56k; R_0603_1608Metric
R20, R21: 27; R_0603_1608Metric
R23: 499k; R_0603_1608Metric
R26: 330; R_0603_1608Metric
R27: 10k; R_0603_1608Metric
R28, R29: 2.2k; R_0603_1608Metric
R30: 13.3k; R_0805_2012Metric
R31: 100k; R_0805_2012Metric
R32: 49.9; R_0805_2012Metric
R34: 105k; R_0603_1608Metric
R35: 511k; R_0603_1608Metric
SW1, SW2, SW3: SW_Push; SW_SPST_B3U-1000P
TP1, TP6, TP16, TP21, TP24, TP25, TP26: TestPoint; TestPoint_Pad_D1.5mm
TP2: VSYS; TestPoint_Pad_D1.5mm
TP3: VDD; TestPoint_Pad_D1.5mm
TP4: GND; TestPoint_Pad_D1.5mm
TP5: DVDD; TestPoint_Pad_D1.5mm
TP7, TP8, TP11, TP14, TP27, TP28, TP29, TP30, TP31, TP32, TP33, TP34, TP35, TP36, TP37, TP38: VUSB; TestPoint_Pad_D1.5mm
TP9: SE_L; TestPoint_Pad_D1.5mm
TP10: VCCA; TestPoint_Pad_D1.5mm
TP12: SE_R; TestPoint_Pad_D1.5mm
TP13: VIN; TestPoint_Pad_D1.5mm
TP15: VBUCK; TestPoint_Pad_D1.5mm
TP17: BAL_R-; TestPoint_Pad_D1.5mm
TP18: BAL_R+; TestPoint_Pad_D1.5mm
TP19: BAL_L+; TestPoint_Pad_D1.5mm
TP20: BAL_L-; TestPoint_Pad_D1.5mm
TP22: VREG; TestPoint_Pad_D1.5mm
TP23: VREF; TestPoint_Pad_D1.5mm
TP39: VDD_B4SW; TestPoint_Pad_D1.5mm
U1: 74LVC2GU04; SOT-23-6
U2: ADP151-3.3; SOT-23-5
U3: 74AHC1G126; SOT-23-5
U4: AP2112K-3.3; SOT-23-5
U5: ATSAMD11D14A-M; QFN-24-1EP_4x4mm_P0.5mm_EP2.6x2.6mm
U6: USBLC6-2SC6; SOT-23-6
U7: TPS54202DDC; SOT-23-6
U8: MAX97220C/MAX97220D; QFN50P300X300X80-17N
U9: ES9010K2M; QFN50P500X500X90-29N-D
VR1: RK09711110EL
X1: 7M-50.000MAAJ-T; XTAL_7M-50.000MAAJ-T

Connections:
+3.3VA: C3.2, C7.1, C8.2, C9.2, C10.1, R19.1, R22.2, TP10.1, U1.5 (VCC), U2.5 (VOUT), U8.1 (PVDD), U8.9 (SVDD2), U8.13 (SVDD), U9.18 (VCCA)
+3V3: C21.2, C25.2, C29.2, C31.2, JP4.1 (A), R2.1, R27.1, R28.2, R29.2, TP2.1, U4.5 (VOUT), U5.24 (VDD), VR1.3 (CW)
+12V: C36.1, C40.1, C41.1, J5.1, TP13.1, U7.3 (VIN)
/Buck/VOUT: C35.1, C37.1, D2.2 (A), L1.2, R32.1, TP15.1
/DAC/DAC.XI: C43.1, R23.1, U9.7 (XI(MCLK)), X1.3
/DAC/DAC.XO: R18.2, R23.2, U9.6 (XO)
/DAC/DAC_1V2: C5.1, TP5.1, U9.21 (DVDD)
/DAC/DAC_GPIO: TP26.1, U5.14 (PA17), U9.24 (GPIO1)
/DAC/DAC_RESET: C2.2, TP6.1, U5.5 (PA06), U9.28 (RESETB)
/DAC/HPA_SHDN: R22.1, TP21.1, U5.2 (PA03), U8.16 (~SHDN)
/DAC/IN_BAL.L+: C11.2, U8.15 (INL+)
/DAC/IN_BAL.L-: C20.2, U8.14 (INL-)
/DAC/IN_BAL.R+: C17.2, U8.7 (INR+)
/DAC/IN_BAL.R-: C13.2, U8.8 (INR-)
/DAC/OUT_BAL.L+: C11.1, TP19.1, U9.13 (DACL)
/DAC/OUT_BAL.L-: C20.1, TP20.1, U9.14 (DACLB)
/DAC/OUT_BAL.R+: C17.1, TP18.1, U9.9 (DACR)
/DAC/OUT_BAL.R-: C13.1, TP17.1, U9.10 (DACRB)
/DAC/OUT_SE_L: R20.2, TP9.1, U8.12 (OUTL)
/DAC/OUT_SE_R: R21.2, TP12.1, U8.10 (OUTR)
/DAC/SCL: J1.3, R29.1, TP25.1, U5.16 (PA23), U9.3 (SCL)
/DAC/SDA: J1.4, R28.1, TP24.1, U5.15 (PA22), U9.4 (SDA)
/DAC/SPDIF1: R11.2, TP8.1, U1.6, U9.25 (DATA2)
/DAC/SPDIF2: R6.2, TP7.1, U1.4, U9.27 (DATA_CLK)
/SAMD11/CV_EN: J1.2, TP1.1, U5.1 (PA02)
/SAMD11/JTAG.SWCLK: J8.4, R2.2, U5.19 (PA30/SWCLK)
/SAMD11/JTAG.SWDIO: J8.2, U5.20 (PA31/SWDIO)
/SAMD11/PTC_X2Y8: J7.3, U5.9 (PA10)
/SAMD11/PTC_X3Y9: J7.2, U5.10 (PA11)
/SAMD11/STATUS_LED: R36.2, U5.13 (PA16)
/SAMD11/USB.DN: U5.21 (PA24), U6.6 (I/O1)
/SAMD11/USB.DP: U5.22 (PA25), U6.4 (I/O2)
/SAMD11/VOLUME_POT: TP16.1, U5.6 (PA07), VR1.2 (WIPER)
/SAMD11/~RST: C1.2, J8.3, R26.1, R27.2, U5.18 (PA28/~RST)
/UINN: J3.A7 (D-), J3.B7 (D-), U6.1 (I/O1)
/UINP: J3.A6 (D+), J3.B6 (D+), U6.3 (I/O2)
GND: C1.1, C2.1, C3.1, C5.2, C7.2, C8.1, C9.1, C10.2, C12.1, C14.1, C16.1, C18.1, C19.2, C21.1, C22.1, C23.1, C24.1, C25.1, C26.1, C27.1, C28.1, C29.1, C30.1, C31.1, C32.1, C33.1, C35.2, C36.2, C37.2, C38.1, C40.2, C41.2, C42.2, C43.2, D3.1 (K), D4.1 (K), H1.1, H2.1, H3.1, H4.1, J1.5, J2.S, J3.A1 (GND), J3.A12 (GND), J3.B1 (GND), J3.B12 (GND), J3.S1 (SHIELD), J4.2, J4.8, J5.2, J5.3, J6.S, J7.1, J8.5, NT1.1, NT1.2, R3.1, R4.1, R8.2, R13.2, R25.1, R30.2, R34.2, SW1.1, SW2.1, SW3.1, TP4.1, TP35.1, TP36.1, U1.2 (GND), U2.2 (GND), U3.3 (GND), U4.2 (GND), U5.23 (GND), U5.25 (GND), U6.2 (GND), U7.1 (GND), U8.3 (PGND), U8.6 (SGND), U9.1 (DGND_1), U9.12 (AGND), U9.20 (DGND_2), U9.29 (EP/DGND), VR1.1 (CCW), X1.2 (GND), X1.4 (GND)
unnamed: C4.1, R7.2
unnamed: C6.1, R9.2
unnamed: C34.1, R31.1, R32.2
unnamed: C42.1, R18.1, X1.1
unnamed: D1.1 (K), D2.1 (K), FB1.1
unnamed: D3.2 (A), R33.1
unnamed: D4.2 (A), R36.1
unnamed: J2.R, R1.2
unnamed: J2.T, R24.2
unnamed: J3.A5 (CC1), R3.2
unnamed: J3.B5 (CC2), R4.2
unnamed: J4.1, R15.1, TP37.1
unnamed: J4.3, R17.1, TP28.1
unnamed: J4.5, R14.1, TP31.1
unnamed: J4.7, R10.1, TP38.1
unnamed: J6.R, R21.1
unnamed: J6.T, R20.1
unnamed: J8.1, JP4.2 (B)
unnamed: JP1.2 (B), SW1.2
unnamed: JP2.2 (B), SW3.2
unnamed: JP3.2 (B), R33.2
unnamed: R6.1, R7.1, U1.3
unnamed: R9.1, R11.1, U1.1
unnamed: R24.1, TP11.1, U3.4
unnamed: R26.2, SW2.2
unnamed: R34.1, R35.2
unnamed: R16.1, U5.3 (PA04)
unnamed: R5.1, U5.4 (PA05)
unnamed: R12.1, U5.17 (PA27)
unnamed: C39.1, U7.6 (BOOT)
unnamed: R35.1, U7.5 (EN)
unnamed: C34.2, R30.1, R31.2, U7.4 (FB)
unnamed: C39.2, L1.1, U7.2 (SW)
unnamed: C19.1, U8.11 (BIAS)
unnamed: C15.2, U8.4 (C1N)
unnamed: C15.1, U8.2 (C1P)
unnamed: C16.2, U8.5 (PVSS)
unnamed: R19.2, R25.2, U9.5 (ADDR)
unnamed: C12.2, TP23.1, U9.16 (VREF)
unnamed: C14.2, TP22.1, U9.17 (VREG)
SWITCH_LOW: C22.2, C24.2, C28.2, C30.2, C32.2, C33.2, FB1.2, TP39.1, VR1.5 (NO)
VBUS: C38.2, D1.2 (A), J3.A4 (VBUS), J3.A9 (VBUS), J3.B4 (VBUS), J3.B9 (VBUS), TP14.1, U6.5 (VBUS)
VDD: C18.2, C23.2, C26.2, C27.2, J1.1, J4.12, R1.1, TP3.1, TP32.1, U2.1 (VIN), U2.3 (EN), U3.1, U3.5 (VCC), U4.1 (VIN), U4.3 (EN), VR1.4 (COM)
acal_btn: J4.4, JP1.1 (A), R12.2, TP34.1
midi_from_fpga_3v: R17.2, U3.2, U5.12 (PA15)
midi_to_fpga_3v: R15.2, U5.11 (PA14)
mute_btn: J4.6, JP2.1 (A), R16.2, TP30.1
mute_led: J4.10, JP3.1 (A), R5.2, TP29.1
spdif_line: C6.2, J4.9, R13.1, TP27.1
spdif_mon: C4.2, J4.11, R8.1, TP33.1
uart_rx_3v: R10.2, U5.8 (PA09/XOUT)
uart_tx_3v: R14.2, U5.7 (PA08/XIN)
