wormyrocks/d-lev-mini/d-lev-main/dlev-mini.kicad_pcb

## KiCad design d-lev-main/dlev-mini.kicad_pcb (2023-04-21)

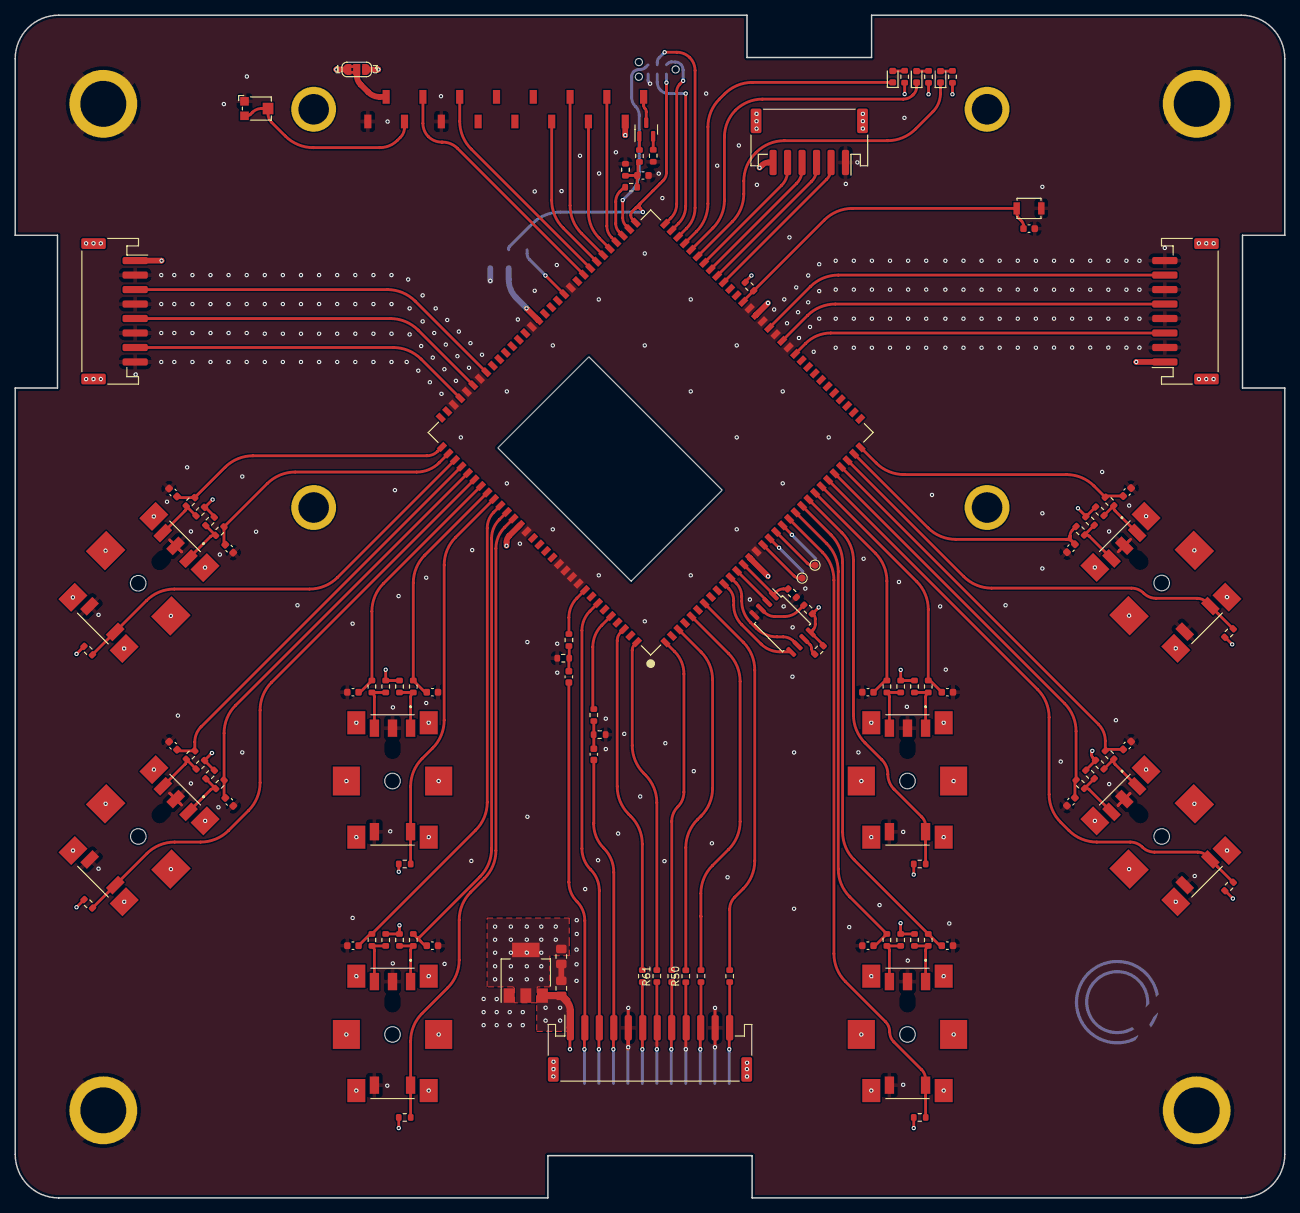
[picture p18: board dlev-mini.kicad_pcb from above]

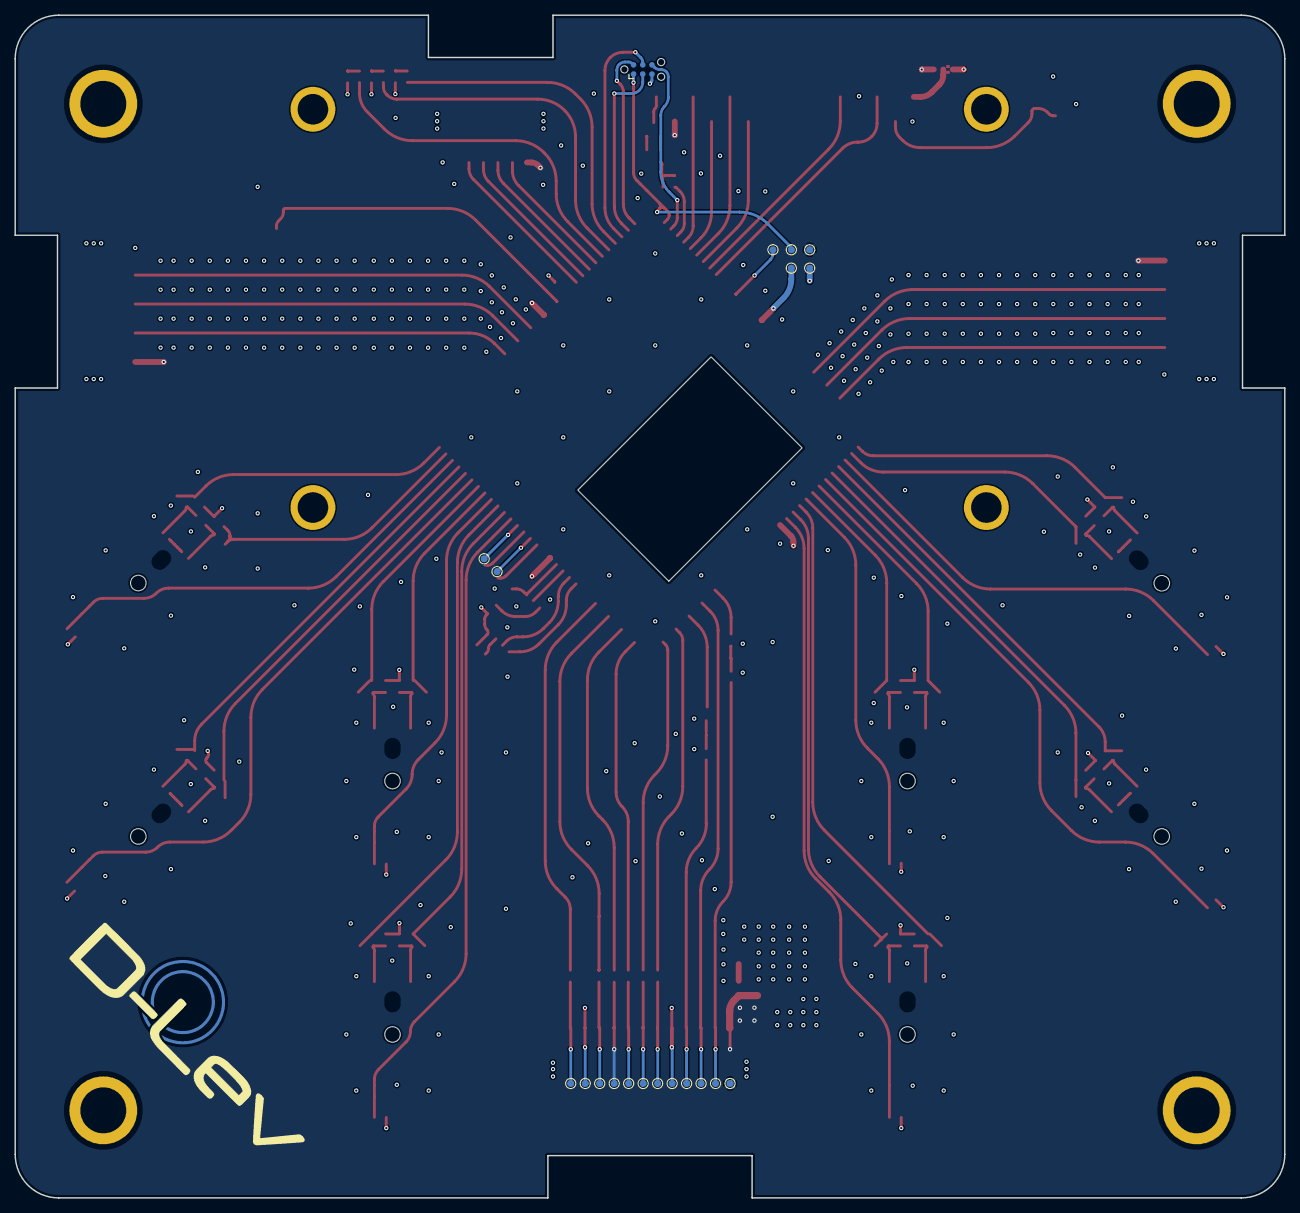
[picture p19: board dlev-mini.kicad_pcb from below]

Board: 4 copper layers, 175.3 x 163.3 mm, 136 parts (20 on the bottom side), 108 nets.

Parts:
C1: .1u; C_0603_1608Metric
C2, C3, C4, C6, C7, C8, C9, C10, C11, C13, C14, C15, C16, C17, C18, C21, C22: .01u; C_0603_1608Metric
C5, C12: 100n; C_0603_1608Metric
C19, C20: 22u; C_0805_2012Metric_Pad1.18x1.45mm_HandSolder
D1, D2, D3: LED; LED_0603_1608Metric
DS1: LCD-20X4B-noshield; ERM2004-2
H1, H2, H7, H8: MountingHole_Pad; SMTSO-M4
H3, H4, H5, H6: M3 Standoff; SMTSO-M3
J1: S6B-PH-SM4-TB; JST_PH_S6B-PH-SM4-TB_1x06-1MP_P2.00mm_Horizontal
J2, J3: S8B-PH-SM4-TB; JST_PH_S8B-PH-SM4-TB_1x08-1MP_P2.00mm_Horizontal
J4: S12B-PH-SM4-TB; JST_PH_S12B-PH-SM4-TB_1x12-1MP_P2.00mm_Horizontal
J5: Tag-Connect TC2030-NL; Tag-Connect_TC2030-IDC-NL_2x03_P1.27mm_Vertical
JP1: LCD_VSEL; SolderJumper-3_P1.3mm_Bridged2Bar12_RoundedPad1.0x1.5mm_Num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
Q1: MMBT3904; SOT-23
R1, R2, R3, R4, R6, R7: 1k; R_0603_1608Metric
R5: 22; R_0603_1608Metric
R8, R9, R10, R11, R12, R13, R14, R15, R16, R17, R18, R19, R20, R21, R22, R23, R24, R25, R26, R27, R28, R29, R36, R37, R38, R39, R40, R41, R42, R43, R44, R45, R46, R47, R48, R49, R51, R52, R53, R54, R55, R56, R57, R58: 10k; R_0603_1608Metric
R30, R32: 210; R_0603_1608Metric
R31, R33: 110; R_0603_1608Metric
R34, R35, R50, R59, R61: 100; R_0603_1608Metric
R60: 0; R_0603_1608Metric
RV1: 10K; Potentiometer_Bourns_TC33X_Vertical
SW1: SW_Push; SW_SPST_B3U-1000P
SW2, SW3, SW4, SW5, SW6, SW7, SW9, SW10: RotaryEncoder_Switch; PEC11S-929K
TP1: GPIO_O3; TestPoint_Pad_D1.0mm
TP2: GPIO_I3; TestPoint_Pad_D1.0mm
TP3: 2v5; TestPoint_Pad_D1.0mm
TP4: VDD; TestPoint_Pad_D1.0mm
TP5: GND; TestPoint_Pad_D1.0mm
TP6: 1v2; TestPoint_Pad_D1.0mm
TP7: 3v3; TestPoint_Pad_D1.0mm
TP8: GPIO_O2; TestPoint_Pad_D1.0mm
TP9: GPIO_I2; TestPoint_Pad_D1.0mm
TP10, TP11, TP12, TP13, TP14, TP15, TP16, TP17, TP18, TP19, TP20, TP21: TestPoint; TestPoint_Pad_D1.0mm
U1: AC608; ac608-toponly
U2: 25LCxxx; SOIC-8_5.275x5.275mm_P1.27mm
U3: AMS1117-3.3; SOT-223-3_TabPin2

Connections:
+2V5: J5.1, TP3.1, U1.63 (VDD2.5)
+3V3: C19.1, JP1.1 (A), R1.2, R2.2, R3.2, R8.2, R9.1, R11.1, R13.1, R14.2, R16.2, R17.1, R18.1, R21.1, R24.1, R25.1, R26.1, R28.1, R37.1, R39.1, R40.1, R43.1, R44.1, R46.1, R47.1, R49.1, R52.1, R53.1, R54.1, R56.1, R57.1, R58.1, TP7.1, U1.14 (VDD3.3), U1.48 (VDD3.3), U1.78 (VDD3.3), U1.106 (VDD3.3), U2.8 (VCC), U3.2 (VO)
/FPGA/TCK: J5.4, U1.60 (TCK)
/FPGA/TDI: J5.3, U1.61 (TDI)
/FPGA/TDO: J5.6, U1.64 (TDO)
/FPGA/TMS: J5.2, U1.62 (TMS)
/FPGA/enc_1.a: C3.1, R12.1, U1.95 (LVDS_TX4_P)
/FPGA/enc_1.b: C4.1, R10.1, U1.94 (LVDS_TX4_N)
/FPGA/enc_1.s: R9.2, SW2.S1, U1.96 (LVDS_TX5_N)
/FPGA/enc_2.a: C9.1, R23.1, U1.98 (IO_R1)
/FPGA/enc_2.b: C8.1, R22.1, U1.97 (LVDS_TX5_P)
/FPGA/enc_2.s: R44.2, SW4.S1, U1.99 (IO_T2)
/FPGA/enc_3.a: C11.1, R27.1, U1.101 (IO_T3)
/FPGA/enc_3.b: C10.1, R29.1, U1.100 (IO_R3)
/FPGA/enc_3.s: R49.2, SW5.S1, U1.102 (IO_R4)
/FPGA/enc_4.a: C17.1, R45.1, U1.104 (IO_R5)
/FPGA/enc_4.b: C18.1, R48.1, U1.103 (IO_T4)
/FPGA/enc_4.s: R57.2, SW9.S1, U1.105 (IO_T5)
/FPGA/enc_5.a: C6.1, R20.1, U1.31 (IO_D15)
/FPGA/enc_5.b: C7.1, R19.1, U1.30 (IO_D16)
/FPGA/enc_5.s: R21.2, SW3.S1, U1.29 (I_E16)
/FPGA/enc_6.a: C15.1, R42.1, U1.28 (IO_F15)
/FPGA/enc_6.b: C16.1, R41.1, U1.27 (IO_G15)
/FPGA/enc_6.s: R56.2, SW7.S1, U1.26 (IO_F16)
/FPGA/enc_7.a: C14.1, R36.1, U1.25 (IO_K15)
/FPGA/enc_7.b: C13.1, R38.1, U1.24 (IO_J14)
/FPGA/enc_7.s: R52.2, SW6.S1, U1.23 (IO_L14)
/FPGA/enc_8.a: C22.1, R51.1, U1.22 (IO_J16)
/FPGA/enc_8.b: C21.1, R55.1, U1.21 (IO_J15)
/FPGA/enc_8.s: R58.2, SW10.S1, U1.20 (IO_K16)
/FPGA/gpio_i2: TP9.1, U1.19 (IO_L13)
/FPGA/gpio_i3: TP2.1, U1.18 (IO_N14)
/FPGA/gpio_o2: TP8.1, U1.17 (IO_P14)
/FPGA/gpio_o3: TP1.1, U1.16 (IO_N12)
/FPGA/lcd.data0: DS1.11 (DB4), U1.69 (IO_N5)
/FPGA/lcd.data1: DS1.12 (DB5), U1.68 (IO_N3)
/FPGA/lcd.data2: DS1.13 (DB6), U1.67 (IO_M6)
/FPGA/lcd.data3: DS1.14 (DB7), U1.66 (IO_L4)
/FPGA/lcd.e: DS1.6 (E), U1.70 (IO_P3)
/FPGA/lcd.pwm: R6.1, U1.65 (IO_K5)
/FPGA/lcd.rs: DS1.4 (RS), U1.71 (IO_L7)
/FPGA/led1: D2.1 (K), U1.57 (IO_G5)
/FPGA/led2: D3.1 (K), U1.58 (IO_G2)
/FPGA/led3: D1.1 (K), U1.59 (IO_G1)
/FPGA/mem_spi.cl: U1.11 (IO_L16), U2.6 (SCK)
/FPGA/mem_spi.cs: R15.1, U1.13 (IO_N11), U2.1 (~CS)
/FPGA/mem_spi.di: U1.10 (IO_L15), U2.5 (MOSI)
/FPGA/mem_spi.do: U1.12 (IO_P11), U2.2 (MISO)
/FPGA/pitch.quad: J2.3, U1.86 (LVDS_TX1_N)
/FPGA/pitch.sq: J2.5, U1.88 (LVDS_TX2_N)
/FPGA/pitch.zero: J2.7, U1.90 (LVDS_TX3_N)
/FPGA/tuner.le: J1.3, U1.54 (IO_F3)
/FPGA/tuner.oe: J1.2, U1.53 (IO_D1)
/FPGA/tuner.scl: J1.5, U1.56 (IO_F1)
/FPGA/tuner.sda: J1.4, U1.55 (IO_F2)
/FPGA/vol.quad: J3.3, U1.42 (I_A9)
/FPGA/vol.sq: J3.5, U1.44 (IO_C9)
/FPGA/vol.zero: J3.7, U1.46 (IO_D9)
/FPGA/~reset: C2.1, R8.1, SW1.1, U1.50 (I_E1)
/LCD/VLCD: DS1.2 (VDD), JP1.2 (C)
/LCD/backlight_cathode: DS1.16 (K), Q1.3 (C)
/encoder1/A1: R23.2, R25.2, SW4.A
/encoder1/B1: R22.2, R24.2, SW4.B
/encoder2/A1: R26.2, R27.2, SW5.A
/encoder2/B1: R28.2, R29.2, SW5.B
/encoder3/A1: R45.2, R47.2, SW9.A
/encoder3/B1: R46.2, R48.2, SW9.B
/encoder4/A1: R17.2, R20.2, SW3.A
/encoder4/B1: R18.2, R19.2, SW3.B
/encoder5/A1: R40.2, R42.2, SW7.A
/encoder5/B1: R41.2, R43.2, SW7.B
/encoder6/A1: R36.2, R39.2, SW6.A
/encoder6/B1: R37.2, R38.2, SW6.B
/encoder7/A1: R51.2, R53.2, SW10.A
/encoder7/B1: R54.2, R55.2, SW10.B
/encoder/A1: R11.2, R12.2, SW2.A
/encoder/B1: R10.2, R13.2, SW2.B
/spdif_tx_0: R30.1, U1.120 (IO_R12)
/spdif_tx_1: R32.1, U1.116 (IO_R10)
GND: C1.2, C2.2, C3.2, C4.2, C6.2, C7.2, C8.2, C9.2, C10.2, C11.2, C13.2, C14.2, C15.2, C16.2, C17.2, C18.2, C19.2, C20.2, C21.2, C22.2, DS1.1 (VSS), DS1.5 (R/W), H1.1, H2.1, H7.1, H8.1, J1.1, J2.2, J2.4, J2.6, J2.8, J3.2, J3.4, J3.6, J3.8, J4.5, J4.11, J5.5, R4.1, R5.1, R15.2, R31.1, R33.1, RV1.1, SW1.2, SW2.C, SW2.S2, SW3.C, SW3.S2, SW4.C, SW4.S2, SW5.C, SW5.S2, SW6.C, SW6.S2, SW7.C, SW7.S2, SW9.C, SW9.S2, SW10.C, SW10.S2, TP5.1, TP14.1, TP20.1, U1.15 (GND), U1.43 (I_B9), U1.45 (I_A8), U1.47 (I_B8), U1.49 (GND), U1.73 (GND), U1.79 (GND), U1.87 (LVDS_TX1_P), U1.89 (LVDS_TX2_P), U1.91 (LVDS_TX3_P), U1.107 (GND), U1.112 (I_R8), U1.113 (I_T8), U1.114 (I_R9), U1.115 (I_T9), U2.4 (GND), U3.1 (GND)
unnamed: C1.1, R4.2, R6.2, R7.1
unnamed: C5.1, R32.2, R33.2
unnamed: C12.1, R30.2, R31.2
unnamed: D1.2 (A), R3.1
unnamed: D2.2 (A), R1.1
unnamed: D3.2 (A), R2.1
unnamed: DS1.3 (V0), RV1.2, RV1.3
unnamed: J4.6, R34.1, TP15.1
unnamed: J4.7, R61.1, TP16.1
unnamed: J4.8, R35.1, TP17.1
unnamed: J4.9, R50.1, TP18.1
unnamed: J4.10, R59.1, TP19.1
unnamed: J4.12, R60.1, TP21.1
unnamed: Q1.1 (B), R7.2
unnamed: Q1.2 (E), R5.2
unnamed: TP6.1, U1.74 (VDD1.2)
unnamed: R16.1, U2.7 (~HOLD)
unnamed: R14.1, U2.3 (~WP)
VDD: C20.1, DS1.15 (A), J1.6, J2.1, J3.1, J4.1, JP1.3 (B), TP4.1, TP10.1, U3.3 (VI)
acal_btn: R50.2, U1.3 (IO_R16)
midi_in: R60.2, U1.7 (IO_N16)
midi_out: R59.2, U1.5 (IO_P16)
mute_btn: R61.2, U1.124 (IO_R14)
mute_led: J4.3, TP12.1, U1.118 (IO_R11)
spdif_line: C12.2, J4.4, TP13.1
spdif_mon: C5.2, J4.2, TP11.1
uart_rx: R35.2, U1.1 (IO_T14)
uart_tx: R34.2, U1.122 (IO_R13)
