wormyrocks/d-lev-mini/(commit log)

2023-02-11 Laid down some ideas
    [20854-005E-02.step, 20X4LCD JHD204A.STEP, AC608.kicad_sch, AFE.kicad_sch, EP4CE15 and E22 in QFP144 pinout.xls, Encoders.kicad_sch, FPGA.kicad_sch, IOPanel.kicad_sch]
2023-02-13 Add ac608 model and move into subdirectory
    [20854-005E-02.step, 20X4LCD JHD204A.STEP, AC608.kicad_sch, AFE.kicad_sch, EP4CE15 and E22 in QFP144 pinout.xls, Encoders.kicad_sch, FPGA.kicad_sch, IOPanel.kicad_sch]
2023-02-13 Add AFE antenna schematic and rough layout
    [S7B-PH-SM4-TB.stp, d-lev_afe-antenna.kicad_pcb, d-lev_afe-antenna.kicad_sch]
2023-02-20 Add block diagram
    [AFE.kicad_sch, Encoders.kicad_sch, FPGA.kicad_sch, IOPanel.kicad_sch, dlev-mini.kicad_pcb, dlev-mini.kicad_sch]
2023-02-23 Many changes
    Reorganized libraries to share between projects
    Set up JLC 2- and 4- layer design rules
    Finished copying over most of the schematic (excluding I/O board)
    [20854-005E-02.step, AFE.kicad_sch, Encoders.kicad_sch, FPGA.kicad_sch, LCD.kicad_sch, S7B-PH-SM4-TB.stp, d-lev-io.kicad_pcb, d-lev-io.kicad_sch]
2023-02-25 Reorganized, and updates
    [ES9016-2M_REF3_REV3 BOM.xls, ES90182M_REF3_3v0.dip, d-lev-afe.kicad_pcb, d-lev-afe.kicad_sch, d-lev-dac.kicad_pcb, d-lev-dac.kicad_sch, d-lev-io.kicad_sch]
2023-02-28 schematic + wiring for avr
    [AVR.kicad_sch, DAC.kicad_sch, FPGA.kicad_sch, d-lev-io.kicad_sch, dlev-mini.kicad_sch, midi.kicad_sch]
2023-02-28 add more datasheets for ESS/ power components
2023-03-02 clean up 3d models
    [Encoders.kicad_sch, FPGA.kicad_sch, LCD.kicad_sch, d-lev-afe.kicad_pcb, d-lev-afe.kicad_sch, d-lev-io.kicad_sch, dlev-mini.kicad_pcb, dlev-mini.kicad_sch]
2023-03-08 Level shifters and rearrange encoders
    * WIP: use net buses more effectively to organize encoder signals
    * Add application note for level shifters
    * Add level shifters for UART, change MIDI level shifter BJT to FET
    * Add MIDI_HI pull-up on d-lev-io board
    * Add/change some footprints
    [Encoders.kicad_sch, FPGA.kicad_sch, LCD.kicad_sch, SingleEncoder.kicad_sch, d-lev-io.kicad_sch, dlev-mini.kicad_pcb, dlev-mini.kicad_sch]
2023-03-08 more encoder bus mangling
    [Encoders.kicad_sch, FPGA.kicad_sch, LCD.kicad_sch, SingleEncoder.kicad_sch, dlev-mini.kicad_pcb, dlev-mini.kicad_sch]
2023-03-09 Small changes to 3D models and footprints; fixed bus routing of encoder signals
    [Encoders.kicad_sch, FPGA.kicad_sch, LCD.kicad_sch, SingleEncoder.kicad_sch, dlev-mini.kicad_pcb, dlev-mini.kicad_sch]
2023-03-09 Moved encoders around
    [FPGA.kicad_sch, LCD.kicad_sch, SingleEncoder.kicad_sch, dlev-mini.kicad_pcb, dlev-mini.kicad_sch]
2023-03-12 start routing
    * add simple knob model
    * place encoders
    * change display to use SMT female headers and SMTSO screw holes
    * rotate fpga model 90 degrees
    [FPGA.kicad_sch, LCD.kicad_sch, SingleEncoder.kicad_sch, dlev-mini.kicad_pcb, dlev-mini.kicad_sch, knob.scad, knob.step]
2023-03-12 many changes to pcb
    [FPGA.kicad_sch, LCD.kicad_sch, SingleEncoder.kicad_sch, dlev-mini.kicad_pcb, dlev-mini.kicad_sch, standoff_m3x10.stp, standoff_m3x4.stp, standoff_m3x5.stp]
2023-03-12 knob.scad changes, not happy with them yet
    [knob.scad]
2023-03-14 Switch from Rpacks to 0603 pull resistors
    [EncoderSingle.kicad_sch, FPGA.kicad_sch, LCD.kicad_sch, SingleEncoder.kicad_sch, dlev-mini.kicad_pcb, dlev-mini.kicad_sch]
2023-03-15 more minor pusharounds and updates
    [AVR.kicad_sch, FPGA.kicad_sch, LCD.kicad_sch, SingleEncoder.kicad_sch, d-lev-io.kicad_pcb, d-lev-io.kicad_sch, dlev-mini.kicad_sch, midi.kicad_sch]
2023-03-15 Fix error in pinmap spreadsheet
    [ac608-pinmap.xlsx]
2023-03-15 Pinned out FPGA and rearranged encoders again
    [EncoderSingle.kicad_sch, FPGA.kicad_sch, LCD.kicad_sch, SingleEncoder.kicad_sch, d-lev-io.kicad_sch, dlev-mini.kicad_pcb, dlev-mini.kicad_sch]
2023-03-15 Built out power circuitry on d-lev-io
    [FPGA.kicad_sch, d-lev-io.kicad_sch, dlev-mini.kicad_sch]
2023-03-16 mostly done routing
    [FPGA.kicad_sch, LCD.kicad_sch, d-lev-io.kicad_sch, dlev-mini.kicad_pcb, dlev-mini.kicad_sch]
2023-03-16 four layer routes
    [LCD.kicad_sch, dlev-mini.kicad_pcb, dlev-mini.kicad_sch]
2023-03-16 Clean up unroutes and add DRC
    [FPGA.kicad_sch, dlev-mini.kicad_pcb]
2023-03-17 main board - push vias around
    [dlev-mini.kicad_pcb]
2023-03-18 Improve routing and rearrange I/O connector
    [AVR.kicad_sch, FPGA.kicad_sch, d-lev-io.kicad_sch, dlev-mini.kicad_pcb, dlev-mini.kicad_sch]
2023-03-18 messed up line endings
    [Encoders.kicad_sch, d-lev-dac.kicad_pcb, dlev-mini.kicad_pcb, untitled.kicad_sch]
2023-03-24 Add buck converter schematic
    [LDO.kicad_sch, buck.kicad_sch, d-lev-io.kicad_sch]
2023-03-24 Add footprint references and fix error in buck schematic
    [buck.kicad_sch]
2023-03-24 Via stitching around afe traces and add fix for lcd contrast pot
    [LCD.kicad_sch, dlev-mini.kicad_pcb, dlev-mini.kicad_sch]
2023-04-07 many many changes'
    [AVR.kicad_sch, FPGA.kicad_sch, LCD.kicad_sch, LDO.kicad_sch, LDO4v5.kicad_sch, d-lev-afe.kicad_pcb, d-lev-afe.kicad_sch, d-lev-io.kicad_sch]
2023-04-12 many more changes
    [AVR.kicad_sch, LDO.kicad_sch, LDO4v5.kicad_sch, buck.kicad_sch, d-lev-afe.kicad_pcb, d-lev-afe.kicad_sch, d-lev-io.kicad_pcb, d-lev-io.kicad_sch]
2023-04-13 map SAMD21 pins
    [LDO.kicad_sch, SAMD11.kicad_sch, buck.kicad_sch, d-lev-io.kicad_pcb, d-lev-io.kicad_sch]
2023-04-14 Add gerbers for 9016K2M EVB
    [Board.gbr, BoardOutline.gbr, Bottom.gbr, BottomAssy.gbr, BottomDimension.gbr, BottomMask.gbr, BottomPaste.gbr, BottomSilk.gbr]
2023-04-14 Added DAC schematic to I/O board
    [DAC.kicad_sch, LDO.kicad_sch, SAMD11.kicad_sch, buck.kicad_sch, d-lev-io.kicad_pcb, d-lev-io.kicad_sch]
2023-04-15 add headphone amp
    [DAC.kicad_sch, SAMD11.kicad_sch, d-lev-io.kicad_pcb, d-lev-io.kicad_sch]
2023-04-15 round tracks and teardrops
    [FPGA.kicad_sch, LCD.kicad_sch, SingleEncoder.kicad_sch, dlev-mini.kicad_pcb, dlev-mini.kicad_sch]
2023-04-15 Add Coilcraft SMT inductor footprints
2023-04-15 Aesthetic improvements to main/AFE
    [d-lev-afe.kicad_pcb, d-lev-afe.kicad_sch, dlev-mini.kicad_pcb]
2023-04-15 more aesthetics
    [d-lev-afe.kicad_pcb, dlev-mini.kicad_pcb]
2023-04-17 io board more analog schematic capture
    [DAC.kicad_sch, LDO.kicad_sch, SAMD11.kicad_sch, d-lev-io.kicad_pcb, d-lev-io.kicad_sch]
2023-04-17 assign vol pot to analog pin
    [SAMD11.kicad_sch, d-lev-io.kicad_sch]
2023-04-21 many board updates
    [DAC.kicad_sch, FPGA.kicad_sch, LCD.kicad_sch, LDO.kicad_sch, SAMD11.kicad_sch, SingleEncoder.kicad_sch, buck.kicad_sch, d-lev-io.kicad_pcb]
2023-04-21 more routing
    [DAC.kicad_sch, LDO.kicad_sch, SAMD11.kicad_sch, buck.kicad_sch, d-lev-afe.kicad_sch, d-lev-io.kicad_pcb, d-lev-io.kicad_sch]
2023-04-27 Routed IO board
    [DAC.kicad_sch, SAMD11.kicad_sch, d-lev-io.kicad_pcb, d-lev-io.kicad_sch]
2023-04-27 add 5-pin CV expansion header
    [DAC.kicad_sch, LDO.kicad_sch, SAMD11.kicad_sch, buck.kicad_sch, d-lev-io.kicad_pcb, d-lev-io.kicad_sch]
2023-04-27 Moved datasheets out of d-lev-dac and deleted
    [Board.gbr, BoardOutline.gbr, Bottom.gbr, BottomAssy.gbr, BottomDimension.gbr, BottomMask.gbr, BottomPaste.gbr, BottomSilk.gbr]
2023-04-27 route cv header
    [DAC.kicad_sch, LDO.kicad_sch, SAMD11.kicad_sch, buck.kicad_sch, d-lev-io.kicad_pcb, d-lev-io.kicad_sch]
2023-05-03 Add tuner
    [7seg.kicad_sch, LEDs.kicad_sch, d-lev-tuner.kicad_pcb, d-lev-tuner.kicad_sch, d-lev_tuner_driver.kicad_sch, line.kicad_sch, star.kicad_sch]
2023-05-04 I/O board silk placement
    [DAC.kicad_sch, LDO.kicad_sch, SAMD11.kicad_sch, buck.kicad_sch, d-lev-io.kicad_pcb, d-lev-io.kicad_sch]
2023-05-10 finished routing tuner
    [7seg.kicad_sch, d-lev-tuner.kicad_pcb, d-lev-tuner.kicad_sch]
2023-05-11 tuner: fix led footprints, reroute, place vias artistically
    [7seg.kicad_sch, d-lev-tuner.kicad_pcb, d-lev-tuner.kicad_sch, line.kicad_sch, star.kicad_sch]
2023-05-11 d-lev-io: de-rounded tracks
2023-05-11 d-lev-main: de-round tracks
    [FPGA.kicad_sch, LCD.kicad_sch, SingleEncoder.kicad_sch, dlev-mini.kicad_sch]
2023-05-11 d-lev-afe: de-rounded traces
    [d-lev-afe.kicad_pcb, d-lev-afe.kicad_sch]
2023-05-11 renamed dlev-mini to d-lev-main
    [d-lev-main.kicad_sch, d-lev-main.stretch_bkup.kicad_pcb]
2023-05-11 d-lev-main: clean up silkscreen refdes'
2023-05-12 all boards: fix some 3d model paths
    [d-lev-afe.kicad_pcb, d-lev-tuner.kicad_pcb]
2023-05-13 d-lev-io: pass drc before rounding traces
2023-05-13 drc improvements
    [d-lev-afe.kicad_pcb]
2023-05-14 tuner: fixed led footprints
    [d-lev-tuner.kicad_pcb, line.kicad_sch]
2023-05-14 star pattern done
    [d-lev-tuner.kicad_pcb]
2023-05-14 tuner: pass drc
    [d-lev-tuner.kicad_pcb]
2023-05-15 everything passes drc as much as i care for it to, added silk art
    [d-lev-afe.kicad_pcb, d-lev-tuner-rounded.kicad_pcb, d-lev-tuner.kicad_pcb]
2023-05-15 all design files updated with current contents of jlc cart
    [d-lev-tuner-rounded.kicad_pcb]
2023-05-17 Add JLC releases
    [d-lev-afe.kicad_pcb, d-lev-tuner-rounded.kicad_pcb, d-lev-tuner.kicad_pcb]
2023-06-06 Add iBOMs and additional part numbers
    [7seg.kicad_sch, AC608.kicad_sch, AFE.kicad_sch, DAC.kicad_sch, Encoders.kicad_sch, FPGA.kicad_sch, IOPanel.kicad_sch, LCD.kicad_sch]
2023-06-06 Add display-shim adapter board
    [display-shim.kicad_pcb, display-shim.kicad_sch]
2023-06-12 Normalize line endings
    [AVR.kicad_sch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]
2023-08-20 Added step file of the entire enclosure assembly
2023-08-21 d-lev-afe: switch to 2 layers, add 'antenna' version, pick out JLC parts
    [d-lev-afe.kicad_pcb, d-lev-afe.kicad_sch]
2023-10-17 pushed smaller AFE board
    [d-lev-afe.kicad_pcb, d-lev-afe.kicad_sch]
